BiscutLabs/RISCay-MCU/README.md

# RISCay-MCU

RISCay-MCU is an asynchronous RV32E microcontroller built in Chisel with
[chisel-async](https://github.com/BiscutLabs/chisel-async), targeting the GF180MCU
process. It combines a small RISC-V CPU, on-chip SRAM, firmware loading, GPIO,
measurement interfaces and event-driven sleep.

The active rebuild is a [multi-bank desynchronized MCU](docs/desync-contract.md),
generated from the [clocked MCU](designs/clocked/README.md). Its register banks
will exchange data through four-phase handshakes, without a shared fast clock.
The bank transformation and physical controllers are under development.
The earlier **four-phase bundled-data (BD)** and **native two-phase Click** designs
are frozen behavioral references. All variants use the same ISA and software interfaces.

## Features

| Component | Capabilities |
| --- | --- |
| CPU | RV32E, sixteen 32-bit registers, one instruction in flight; no cache, compressed instructions or hardware multiply/divide |
| Memory | 2 KiB executable SRAM and 1 KiB working SRAM in the reference build; configurable capacities |
| Boot | External SPI NOR flash, A/B firmware slots and a golden recovery image, with I²C host-loader fallback |
| Programming | CRC and image-compatibility checks, programming lock, optional flash persistence |
| I/O | GPIO inputs, outputs and events; external SPI ADC interface; measurement value, validity and age |
| Timing | Independent low-frequency timebase and watchdog, deadlines, wake events and retained sleep |

Application behavior lives in firmware. Board profiles describe pin assignments,
measurement metadata and capacities.

The BD and Click CPU and major SoC datapaths use native request/acknowledge handshakes.
The low-frequency timebase, watchdog, reset qualification, service coordination,
wire sampling and production SRAM access still use clocks. See the
[architecture and remaining clocked boundaries](docs/async-residual-state.md).

## Build and test

Use Python 3.12, JDK 21, firtool 1.160.0 and Icarus Verilog 13. Firmware tests also
use the pinned RISC-V GCC toolchain. Follow the [setup guide](docs/build-and-test.md)
to install the tools and configure their paths, then run:

```sh
python tools/ci.py --output build/ci-local
```

Choose a fresh output directory for each run. This runs the Python tests and fast
RTL simulation suites; CI uses the same command on pushes to `main` and pull
requests. The build fetches chisel-async at a pinned Git revision automatically.

To export the clocked source for the rebuild:

```sh
python tools/sbt.py --bootstrap "clocked/runMain riscay.clocked.EmitClockedSoc build/export/clocked"
```

The [build guide](docs/build-and-test.md) also covers reference exports, extended
simulation suites and the physical toolchain. Run only one sbt process at a time.

## Firmware and integration

Firmware targets `rv32e` with the `ilp32e` ABI. The repository includes startup
code, linker scripts, a generic bootloader and example test workloads in
[`firmware/`](firmware/README.md).

At power-on, the bootloader validates an image in external SPI NOR flash and
loads it into executable SRAM. An optional A/B layout preserves the previous
usable image during updates and falls back to an external golden image. If no
valid image is available, it waits for an
I²C upload. GPIOs start as inputs; board pull resistors determine their electrical
state. Watchdog recovery preserves the image and programming lock, with GPIO
retention available as a generic build option.

- [Boot image format and flash programming](docs/generic-boot-contract.md)
- [A/B slots, golden recovery and factory provisioning](docs/boot-slots.md)
- [Memory map and storage](docs/memory-architecture.md)
- [MMIO and I²C host protocol](docs/soc-contract.md)
- [Sleep, wake events and reset behavior](docs/sleep-and-clock.md)

## Repository layout

| Directory | Contents |
| --- | --- |
| [`physical/desync/`](physical/desync/) | Generated desync bank-map inputs |
| [`designs/clocked/`](designs/clocked/README.md) | Independent synchronous reference |
| [`designs/four-phase-bd/`](designs/four-phase-bd/README.md) | BD CPU and SoC implementation |
| [`designs/two-phase-click/`](designs/two-phase-click/README.md) | Native Click CPU and SoC implementation |
| [`shared/`](shared/README.md), [`soc/`](soc/README.md) | ISA, interface definitions, parameters and fixed SRAM models |
| [`profiles/`](profiles/README.md) | Board pin and measurement metadata |
| [`firmware/`](firmware/README.md) | Boot ROM, runtime and firmware fixtures |
| [`verification/`](verification/) | RTL simulation and integration tests |
| [`physical/`](physical/), [`analog/`](analog/) | GF180 implementation flow and analog candidates |
| [`tools/`](tools/) | Build, verification and implementation scripts |

## Physical implementation

BD routed digital layout on a 2.35 × 2.53 mm die


This earlier BD routing study uses a **2.35 × 2.53 mm** outline. Cell
footprints total **3.493 mm²**, including the three SRAM macros across the top.
Pads and analog blocks are not included. The selected run (`d6e5d91`) includes
the native receiver-isolation fixes and predates the expanded A/B boot ROM
and subsequent native-bank changes.

**This is a development design, not ready for fabrication.** Detailed routing
has zero router violations; electrical, timing and signal-integrity qualification
remain open. See the [layout and congestion results](docs/gf180-routability.md),
[module placement study](docs/hierarchical-floorplan.md), [area ledger](docs/area-ledger.md)
and [development roadmap](docs/architecture-followups.md) for measurements and
remaining work.

## License

[Apache License 2.0](LICENSE). Third-party IP retains its own licenses and
attribution.
