BiscutLabs/RISCay-MCU/shared/README.md

# Shared MCU contracts and verification

This directory is reserved for material used unchanged by both implementations:

- RISC-V execution environment, memory map and generic host/peripheral definitions.
- Pure instruction decoding and datapath functions where sharing preserves
  each design's independent protocol/storage implementation.
- Common startup/linker support; board policy and firmware bindings live in `profiles/`.
- Identical workload inputs and independent ISA/supervisor reference models.
- Common test vectors, result schemas and comparison tooling.

Protocol controllers, state storage and protocol-specific timing/reset logic
belong under their respective `designs/` directories. Expected test results
must not come from the same shared datapath used to implement the CPU.

Shared combinational RV32E logic is implemented in
[Architecture.scala](src/main/scala/riscay/Architecture.scala). Independent tests
are in `verification/`; the interpreter does not call production datapath code.
[ArchitecturalRegisters.scala](src/main/scala/riscay/ArchitecturalRegisters.scala)
holds one event-written register bank; each design supplies its own native
arrival pulse and a matched request guard that completes writeback before token
forwarding. Public asymmetric C-elements select each register; read muxes are
inside the execute transform budget. The control token no longer copies the
register file or trace. See the [execution timing contract](../docs/execution-contract.md).

[HostSchema.scala](src/main/scala/riscay/HostSchema.scala) defines and validates
the generic logical host catalog, measurement descriptors and build parameters.
It supplies no I2C transport, peripheral RTL or physical memory. Board-specific
registers and pin roles belong in [profiles/](../profiles/README.md), never in the
shared CPU or common device/loader services.
Shared interface schemas and fixed macros live in [soc/](../soc/README.md);
clocked peripheral implementations live separately under each design. SoC/board
tests live in `verification/`. Compiler-built firmware and memory budgets are in
[firmware/](../firmware/README.md). Both designs must pass the same functional tests; each also
needs its own protocol/timing negative controls. Compare committed instruction
and I/O effects rather than internal cycles. Optional features are on hold.
