BiscutLabs/RISCay-MCU/designs/four-phase-bd/README.md

# Four-phase bundled-data MCU

Selected tape-out implementation, pending physical qualification, using Chisel and chisel-async four-phase
bundled-data components. The core and complete digital SoC are implemented.
[FourPhaseSoc.scala](src/main/scala/riscay/bd/FourPhaseSoc.scala) connects the core
through `FourPhaseFabric` to its own clocked `FourPhaseServices` endpoint via
explicit four-phase/clocked bridges. `FourPhaseControl` uses a seeded state token,
join, transform and fork to own loader accounting/lock, MMIO validation and
selector/producer staging without a periodic clock. Clocked ingress and snapshot
crossings are explicit; peripheral effects and reset/status projection remain in
Services. This directory owns its Platform,
peripheral, scaling, sleep and SRAM controller implementations.
Its native Telemetry, SRAM and I2C loops retain separate POR-owned
state. [FourPhaseSpiAdc.scala](src/main/scala/riscay/bd/FourPhaseSpiAdc.scala)
owns native conversion/priming, frame assembly, scaling and retirement; the
clocked boundary plays its immutable recipe and buffers the complete frame.
`FourPhaseHousekeeping` owns native time/deadline/lease/wake-mask policy, kick
authorization and low-power cadence. Independent LF/watchdog, heartbeat delivery
and legacy SPI idle-delay timing remain clocked.
Follow the [migration checklist](../../docs/async-soc-migration.md).
See the [SoC contract](../../docs/soc-contract.md) for behavior and qualification limits.

The core is [FourPhaseCore.scala](src/main/scala/riscay/bd/FourPhaseCore.scala).
Build instructions are in [build and test](../../docs/build-and-test.md).
The SoC emitter enables retained sleep and also emits `chip/FourPhaseSocChip.sv`
with internal LF and stoppable service oscillator boundaries. See [sleep and clocks](../../docs/sleep-and-clock.md)
for simulation views and outstanding analog qualification.

Own the four-phase CPU sequencing, long-hold storage, reset/token initialization,
top-level integration, emission and protocol-specific tests in this directory.
Use explicit request/acknowledge return-to-zero contracts and preserve their
matched-delay and storage timing obligations.

For each profile, match the native Click implementation's ISA, firmware image, datapath width,
memory capacities, MMIO map, board signals and supervisor policy. Shared logic
must not hide a protocol-specific implementation behind a mode flag.

Use the [reusable interface](../../docs/reusable-interface.md),
[common feature plan](../../docs/features-and-ip.md),
[board I/O contract](../../docs/groundlark-io.md), and
[shared ownership rules](../../shared/README.md). Optional features are on hold.
