BiscutLabs/RISCay-MCU/docs/architecture-followups.md

# Architecture-first follow-ups

The [open migration checklist](async-soc-migration.md) owns sequencing and status.
This document expands its boundary decisions and records the implemented slices.
The remaining proposals are open work. Completed build/characterization work
is in the [migration log](history/migration-log.md#source-build-and-mismatch-screen-follow-up).

RISCay is a generic MCU. Neither RTL nor ROM contains application policy. BD is
the tape-out target. Architecture conversions keep BD and Click functionally equal
unless the user explicitly requests otherwise. Each variant gets its own native
implementation and functional regressions. Click physical timing and sizing work
remains frozen; area and sink accounting still accompany functional changes.
Document temporary internal divergence and any approved ABI transition.

The user has scoped the current native-area redesign **BD first**. BD's
[SRAM word loop](native-sram-word-loop.md) reuses one byte crossing while Click
retains four lanes. BD also replaces Telemetry/Housekeeping reservation round
trips with a [payload-free receiving-edge slot](publication-slot.md); Click
keeps its native reservation owners. BD Control now uses a
[closed architectural/effects bank](native-control-bank.md) and commits CRC on
Stored; Click retains its state FIFO, Join and speculative CRC path. BD
[Telemetry](native-telemetry-effects.md) now publishes a three-bit effects reply
from its existing closed banks. BD [Housekeeping](native-housekeeping-effects.md)
also retains its architectural bank and publishes only 41 effect bits. Click
retains the corresponding full-state replies. The follow-on
[three adaptive area loops](area-optimization-loops.md) are also BD-only: the
first replaces the ADC scaler with an exact single-stage constant transform;
the second factors elapsed arithmetic with its own remeasured request guard;
the third drops consumed CPU Join writeback and unobserved physical retirement
storage. Default BD debug/verification exports still retain retirement, while
PhysicalSocExport explicitly disables it. Click retains its original pipelines
and transport. Both keep the same ISA and integer/scaling ABI. Those loops reached
1.455121 mm² flat BD logic. The follow-on
[memory-guard batch](reviews/bd-memory-guards.md) removes redundant BD Source/Return
waits, retains full decision/history return, and sizes three surviving chains
from their own loaded paths. It maps to 1.345309 mm² flat; the ledger records the
remaining gap. Click retains its existing memory transport and guard recipes.
The [resetless-payload/compact-transport batch](resetless-payload-plan.md) uses
plain latches only for BD's four transient I²C frame banks and narrows the BD
accepted-MMIO descriptor and Control sender address. Click retains resettable
frame payloads and its full command transport; neither ABI nor reset ownership
changes. Architectural banks and all native control state remain resettable.
The external ABI and reset/retention behavior remain equal;
Click remains an unchanged functional regression reference during this pass.

The user-approved [clocked comparison MCU](clocked-design.md) is a third,
independent implementation of the same ABI, including a synchronous CPU. Its
ordinary clocked state is intentional; it neither reverses the native migration
nor changes BD's tape-out selection.

## Work order

The [external boot batch](boot-slots.md) is verified: A/B slots, external golden,
factory image/read-back and full-capacity boot/fallback measurements precede the
remaining area work. No application policy moves into silicon.

1. Decide B's replacement host ABI before resuming 11a2b credit/admission work,
   then continue A/B with producers and consumers moved together.
   Before replacing a memory decision bridge, re-prove publication-ACK inhibition
   before decision-payload reuse. The current +29.206 ns residual credits one
   50 ns period from that retained work-clock bridge at the 20 MHz maximum.
   Removing it, bypassing its retained payload/return states or raising the clock
   limit invalidates that credit. Supply native completion or newly measured
   source retention; do not carry the old margin into the new architecture.
2. Regenerate the BD request-guard inventory and size surviving guards at each
   corner. Historical counts are not the new architecture's inventory.
3. Run item 16 once on the integrated architecture and supported configurations,
   then regenerate 17a3 and close the BD tape-out gate, including full R2b reset
   distribution and targeted routed hold repair.

Local measurements and affected verification accompany each implementation batch.
The [native-area action plan](native-area-action-plan.md) proposes concrete,
ABI-preserving ownership reductions before surviving-guard tuning: one SRAM
word loop per memory, removal of Telemetry/Housekeeping reservation round trips,
and compact Control and native bank-result storage. It preserves the existing
receiving-edge arbitration and memory return/eligibility lifetimes. Its area
budgets are planning gates; [batches 1–4](area-ledger.md) now measure
1.506013 mm² flat BD logic, with 3,449 fewer native storage bits and 247 fewer
flat periodic sinks. This completes the scoped BD-only rewrite, including final
full-capacity primary/golden boot checks. The remaining physical gates are still open. The host ABI decision still precedes frame/credit restructuring.
Record mapped/repaired logic, clock sinks and wake activity/duration in the
[area ledger](area-ledger.md), against the immediate parent and original baseline.
Full extracted-RC qualification remains item 17. Physical prerequisites may be
resolved earlier when they determine a design choice; optional 15a–c research is
not on the tape-out critical path.

The immediate physical prerequisites are compact C-element keeper/output
placement, repairable native parent drivers and a matched 1.94–2.53 mm width
sweep at 50–55% placement density, retaining only zero-router-DRC candidates.
Pre-fix routed timing is [void](gf180-routability.md#withdrawn-physical-results).
The retained time coordinate/timestamps are narrowed from 64
to **43 bits of conservative upper milliseconds**, preserving saturating 32-bit
age. A 41-bit coordinate lasts 69.7 coordinate-years, but the GF180 5–12 Hz
envelope can advance it 2.4 times faster than wall time: only 29.0 wall years.
43 bits supports at least 116 wall years under that envelope. Saturate the
coordinate and force terminal age to `0xffffffff`, even for newly sampled data,
so a stopped coordinate cannot make data permanently fresh. Nominal 32-bit MMIO
time and deadline arithmetic remain unchanged. The verified 43-bit batch removes
42 periodic sinks per variant, with Services work sinks 1,228 → 1,207. Production
ADC/time local timing passes; optional software-sample configurations still need
their own physical map. Matched area and unchanged native-model wake activity
are recorded in the [ledger](area-ledger.md#bounded-time-coordinate).

The [Housekeeping view](native-housekeeping-view.md) removes 292 Services work
sinks in each variant (1,207 → 915). The obsolete elapsed-age command lanes and
architectural state mirror are gone; time/CPU/reset receiving-edge arbitration
remains. The existing 32-bit consumed-time acknowledgement stays at that edge
because it drives asynchronous oscillator-wake logic. BD uses one closed native
bank and a one-bit feedback credit. Click retains its native state buffer and
adds two completion synchronizer flops at the reader boundary. Total periodic
sinks fall by 292 BD / 290 Click. Qualification increases work-clock edges in
some wakes; the ledger records the cost. The 269-sink host snapshot bank belongs
with B's register-pointer redesign, not this slice.

## A. Always-on/application ownership split

The implementation currently has a service clock, a gated work clock and native
POR/application owners, but they are interleaved in Platform/Services. Moving
code into two wrappers alone would not reduce crossings or clock sinks.

| Retained always-on ownership | Application ownership |
| --- | --- |
| LF time/watchdog, reset qualification, crash count, SDA wake | CPU, register file, fetch/execute and CPU transaction presentation |
| Image/lock metadata, host-loader admission, accepted programming work | Uncommitted CPU requests and CPU response presentation |
| SRAM contents and completion of already committed macro work | Application execution eligibility |
| GPIO retention option, POR-retained sample/time state, host telemetry transport | Application words and pending event/deadline/lease state, cleared by the existing reset command |
| Reset/close/rebase coordinator and demand needed to drain owners | Request for sleep/lease, subject to independent watchdog limits |

"Always-on" means retained and able to request progress; it does not mean a
continuously running fast clock. Sampling and the existing service/SRAM boundaries
remain explicit physical obligations. Native storage remains clock-free.
Physical residence does not change reset semantics: an AON owner may host
application-lifetime fields. Pending event flags, deadlines, leases and application
words still clear on application cancellation. Only ordinary GPIO output/OE
retention is configurable; SPI recovery always releases its outputs.

Use the existing close/rebase protocol at the boundary: inhibit admission, close
each receiver on its actual clock, finish or cancel according to the established
commit point, reset native application state, rebase and reopen. No raw reset may
qualify retained synchronous loads. Never cancel a committed loader/SRAM effect
because the CPU resets. Wake demand must include return/rearm, not just valid.

First implementation gate: assign every retained state owner and every periodic
clock sink to a side; move producer and consumer together. Reuse existing channel
schemas, with one ownership crossing per subsystem; move its producer and consumer
as a unit rather than adding a crossing per message type. Do not add a
payload mirror merely to cross the new module hierarchy. Verify reset during host
upload, ADC completion, CPU RAM traffic and sleep, including repeated watchdogs.
Measure mapped/repaired area, periodic sinks and wake activity/duration for each batch.
This absorbs C1e2, the remaining 10b ownership/debt, 11b dispatch, 13a state
projections and 14 temporary round trips. Remove obsolete grant/drain copies,
receipts and gate demand together with their migrated clients.

This is a proposed logical boundary, not implemented power gating. Separate rails
would additionally require isolation, retention cells, supply sequencing and an
external-memory/pad strategy before RTL work starts.

### Implemented slice: retained Telemetry view and clocked event arbitration

Both variants remove Services' application/GPIO payload mirrors. Telemetry keeps
one closed native architectural bank and the existing CPU MMIO crossing. The
[single-writer sample split](single-writer-telemetry.md) assigns physical samples
to the ADC loop and software publications to the CPU, using retained timestamps
in place of time-driven Telemetry updates. BD captures on the qualified
receipt ACK and waits for full return. Click uses its own standard Click bank,
launched by both receipt ACK phases, with its native completion phase synchronized
for clocked readers. Click has no four-phase adapter. See the
[register-view contract](native-app-registers.md).

Pending events, arrival masking and WAIT parking deliberately remain together at
one clocked arbitration point in Services. Independent arrivals must be ordered
against the first offered clear request; saturated source counters cannot preserve
that cutoff. No event travels through Telemetry. The six-bit bank is the sole
pending state, shared by MMIO, WAIT/sleep and the host snapshot. This is a generic
arbitration boundary, not an application policy. The [event contract](native-events.md)
records the sources, exact cutoff/reset rules and shared executable oracle.

The remaining Control scheduler orders host, CPU, programming-completion and reset
commands on the receiving edge. Housekeeping similarly orders time, CPU timer/
cadence actions and recovery. These are intentional clocked arbitration points;
this batch does not require a GF180 MUTEX. Any native replacement must qualify
arbitration before moving the competing sources.

## B. Register-pointer host interface

The target is a **replacement for the framed loader**, not an additional permanent
protocol. The existing framed ABI remains the implemented interface until the
new ABI and host transition are specified and verified. Decide protocol version,
register allocation, pointer units/increment/wrap, command commit, status/error
behavior and migration of existing host tools before changing RTL. Keep 11a2b and
its occupancy/descriptor/admission substeps paused until that decision.

Use repeated START for coherent register reads. Define the snapshot's atomic point
and retain bytes through the read. Stage multibyte command fields and commit only
a complete accepted write. Specify partial writes, STOP, timeout, pointer bounds,
busy/overflow and application/POR reset behavior; none may partially program RAM,
release the lock or start an unvalidated image. Preserve accepted persistent work
and the association of each command with its admission-time reset/busy context.

Reuse the native Control loader owner, full-width image validation, CRC and SRAM
serialization. Do not create a second image store or programming owner. Keep
explicit flash persistence subject to the generic boot contract and source
payloads stable through actual consumer acceptance and native return.

This replaces the old 11a2/11a2b frame-admission and 13c snapshot plan. Decide
whether frame banks are needed at all. Only surviving banks need the R5 epoch/
stale-history redesign and the R6 private frame-route AND replacement with public
primitives. Remove obsolete banks, copies and receipts with the protocol. Test
wire-level repeated START, partial/oversized writes, pointer limits, lock, busy,
reset, coherent snapshots and the chosen host transition in both implementations.
Implement the replacement natively in both variants; Click physical optimization
remains frozen.

## External boot resilience and provisioning

The verified A/B implementation's [contract](boot-slots.md)
specifies the flash layout, golden image placement/protection, versioned
selection/commit metadata and bounded boot attempt/fallback rules. The legacy
single-slot path and I²C fallback remain. Keep generic boot decisions separate from application
behavior; a golden application belongs in external storage, never mask ROM.

The factory tool assembles a bootable image set and verifies full-device read-back,
compatibility and CRC before acceptance. Field updates preserve the newest usable
field image and leave golden/directory untouched. Both variants pass blank/corrupt
slots, interrupted erase/program/metadata commits, POR, watchdog and lock scenarios,
including golden recovery. The programming lock is not protection against
arbitrary firmware GPIO writes to flash; any physical write protection must be
specified separately.

The boot contract records reset-to-entry and worst-case fallback time and work
edges at the full 2 KiB reference capacity. These digital-model measurements
include flash transfer, CRC and SRAM loading; shared ADC-bus drainage has its
separate integration test. Routed boot timing and board provisioning remain
physical integration obligations.

## Retained services and arbitration (11c, 12, 13b)

Use a native MUTEX only for independent asynchronous requesters meeting in the
native domain; qualify metastability containment and ownership. Arbitration on
a real receiving clock is acceptable after the requests safely cross into it.
Neither approach may compromise fairness, accepted work or reset containment.

Acquisition has one publication path into the ADC's retained sample bank. CPU and
host read its coherent view; no independent Supervisor history or fan-out exists.
Keep elapsed ordering/reduction (12a) and GPIO/event history (12c) only for retained
application services, with bounded capacity, sample validity/age, set-wins events
and correct cancellation lifetimes. Retained residence does not imply POR-only
lifetime for every field. Output publication (13b) concerns generic GPIO and cadence,
POR input defaults, optional watchdog GPIO retention and mandatory SPI recovery
release. There is no board-owned power output or application-policy feedback path.

## Residual audit configuration matrix

Run item 16 once after A and B are integrated. Audit emitted owners, native/event/
periodic storage, reset domains, chip-wrapper state and actual clock sinks. Record
conditional owners and exclude unsupported combinations explicitly; do not revive
removed supervisor-policy configurations.

| Configuration axis | Required coverage |
| --- | --- |
| Production reference | Generic 2 KiB program / 1 KiB working SRAM, SPI boot, scheduled ADC and source-stopping LF sleep |
| Boot | Valid external image, I²C fallback, supported I²C-only builds, A/B/golden paths and interrupted updates |
| Acquisition | ADC disabled/zero measurement channels, scheduled ADC, and autonomous ADC in supported legacy builds |
| Time and sleep | LF with service stopping on/off, plus legacy service-derived time without retained-sleep support |
| Capacity and schema | Supported minimum/non-power-of-two/reference capacities; generic GPIO/channel counts and sparse application words |
| Reset | GPIO retention on/off, SPI release, POR, repeated watchdogs and reset during committed work |
| Implementation | Full BD and Click ownership/sink inventories and functional regressions; BD physical qualification only |

SPI boot requires at least seven logical GPIOs and 256 bytes of working RAM.
SPI boot plus ADC requires explicitly scheduled acquisition; the autonomous ADC
combination is currently rejected. Use the actual parameter validators when
constructing the matrix. Reconcile the final inventory with item 17 clock/reset
constraints and retain a written reason for each clocked boundary.

## External application dependency

Groundlark firmware, its policy tests and board integration are maintained outside
this MCU workstream. Application compatibility is an integration dependency, not
permission to restore power policy, profile-owned GPIO masks or a supervisor in
RTL/ROM. Generic MCU verification uses generic firmware and peripheral stimuli.

## Routed hold repair

The former +0.729 ns feedback result has zero wire RC and is not a routed margin.
Reserve 0.05 mm² additional BD standard-cell area, separately from existing
electrical/CTS repair and whitespace. No reserve cells are inserted in advance.

After routing and electrical repair, enumerate every actual feedback/source-release
path with min/max extracted RC at all corners. Measure earliest next-data arrival
against the latest capture leaf plus its Liberty hold aperture, including the
source's real ACK reaction and return/rearm. Preserve phase-specific contexts and
fail on unresolved paths or out-of-table slew; do not borrow Control's margin for
other owners.

Only paths with failing composed hold get candidate delay cells, outside protected
primitives and on the affected data branch. Recheck setup at the earliest capture
leaf, ACK ordering, pulse width, return/rearm, graph equivalence and all sibling
loads after every repair. If a data buffer cannot repair hold without breaking
setup, revise the relevant capture/ACK ordering and remeasure it; do not blanket
buffer all payload bits. Record cell count/area, limiting pins and before/after
slacks in the existing run receipt and area ledger. The reserve is a planning
allowance, not permission to relax the hold requirement.
