BiscutLabs/RISCay-MCU/docs/memory-architecture.md

# On-chip memory architecture

Both native variants execute from on-chip SRAM. Generic mask ROM loads a CRC-
and compatibility-validated image from external SPI boot flash, or waits for the
I2C loader when storage is blank/invalid. No application or profile policy is
fixed in ROM or RTL. See [generic boot](generic-boot-contract.md) for current
implementation and verification status.

## Groundlark sizing budget

| Storage | Selected baseline capacity | Implementation |
| --- | --- | --- |
| Generic bootstrap | Generated RV32E boot ROM | External SPI read, existing CRC/compatibility validation and I2C fallback; no power policy |
| Application firmware, constants and startup image | 2 KiB | Two on-chip 1 KiB SRAM macros loaded from external flash or I2C; volatile |
| Application data and stack | 1 KiB | One on-chip 1 KiB SRAM macro |
| Architectural registers and control | x1-x15 contain 480 bits; additional PC/control and pipeline storage | Protocol-appropriate standard-cell storage; x0 is constant |

Use **2 KiB program SRAM and 1 KiB working SRAM** as the baseline. The
[compiled sizing fixtures](../firmware/README.md) provide repeatable code/data/stack
measurements; actual future application changes must pass these budget checks.
The SPI ROM is generated by `tools/build_boot_rom.py`; its report records bytes,
instruction audit and stack bound. Minimal host-only fixtures may still select
the three-instruction I2C-wait ROM. Neither contains application behavior.
External flash retains the application across total MCU power loss; SRAM does not.

The selected implementation uses **three 1024-by-8 GF180 SRAM macros**, totaling
3 KiB (24,576 data bits), following the explicit SRAM scope change. Their combined
LEF footprint is **0.46624 mm2**, before controllers, routing and placement margins.
The CPU architectural register file, loader metadata and peripheral registers
remain standard-cell storage. [SRAM integration](sram-integration.md) specifies
pinned views, serialization, reset behavior and physical qualification limits.
Keep memory separate from the CPU's circulating state token. Both protocol
variants must use the same backend, capacity and firmware for each comparison;
count their wrappers in the results.

The 1 KiB working RAM budget includes static application data, a 16-byte guard,
and a 128-byte reserved downward-growing stack. It has no heap or interrupt stack.
CPU architectural/handshake state, loader state, measurement registers and
profile-declared software-owned MMIO application words are separate storage.
All profile application words are software-owned. These
program/data capacities are not a count of every flip-flop in the MCU.

Compiler sizing with pinned GCC 13.2.0, `rv32e/ilp32e`, `-Os`:

| Workload | Loaded program image | Static working RAM | Static maximum stack | Guard | RAM including measured bound |
| --- | ---: | ---: | ---: | ---: | ---: |
| Finite event loop | 728 B | 16 B | 20 B | 16 B | 52 B |
| Runtime stress fixture | 1212 B | 48 B | 88 B | 16 B | 152 B |

The larger image leaves **836 bytes (40.8%)** of program headroom. Reserving 128
stack bytes, rather than just its 88-byte bound, uses 192 RAM bytes including
static data and guard, leaving **832 bytes** uncommitted. A 1 KiB program budget
cannot hold that workload; 128 bytes of working RAM cannot hold its static data,
stack bound and guard. The linker negative controls deliberately reject both.
The 1 KiB data capacity follows the selected fixed macro size; it is not a new
firmware requirement. These finite fixtures exercise useful runtime paths but are not the final Groundlark application.

The measured stress call chain uses `main` (12), `batch` (32), `transform` (44)
and `divide` (0), totaling 88 stack bytes. Startup uses no stack. The report includes load
copies of `.data` in program size and both `.data` and `.bss` in static RAM size;
it does not confuse ELF file size or debug metadata with on-chip storage.

`FirmwareSpec` uploads both binaries over real I2C and executes them on both native
SoCs at these full capacities. Independent retirement-SP and RAM-watermark checks
must match the compiler's 20-byte event-loop and 88-byte stress bounds. It also
checks initialization, arithmetic, guard, sleep retention and programming lock.
The images above include explicit event acknowledgement and keyed watchdog
servicing; earlier 704/1204-byte images predate that fix. See the
[verification record](build-and-test.md).

## Generic cold-start and recovery

1. POR disables GPIO outputs and invalidates image/lock metadata. Board pull
   resistors determine safe levels.
2. ROM claims the shared SPI bus, waits for complete ADC drainage, then reads the
   generic external image. It feeds the header/body to the native loader owner.
3. The loader validates full-width fields before narrowing, serializes SRAM
   writes, and accepts the image only after complete CRC verification.
4. ROM releases SPI and starts the validated image. Invalid/blank flash falls
   back to the existing I2C host loader. CRC provides integrity, not authenticity.
5. Watchdog recovery retains validated SRAM image and lock, returns to ROM, and
   restarts a valid retained image without rewriting locked storage. Interrupted
   CPU-origin loading retires accepted writes before aborting the session.

No fixed controller makes power decisions while software is missing or stalled.
A Pi reset does not reset MCU memory or lock. Full MCU POR clears validity and
lock even if some SRAM bits happen to survive. Optional flash write-through must
publish a valid commit record last and distinguish RAM validity from durability.

## Previous flip-flop baseline

The earlier 2 KiB program plus 256-byte working flip-flop implementation is
retained only as historical evidence in [GF180 estimates](gf180-estimates.md).
Those whole-chip area, leakage and energy numbers do not describe this SRAM
revision. New estimates must include all three physical macros, controller
logic, their clock loads and memory-access activity.

## Async integration and initialization

The selected SRAM has a synchronous single-port interface. Its 8-bit width also
requires sequencing to serve the core's 32-bit read response. Each design owns its service controller, which, but must satisfy macro pulse-width, setup/hold
and access timing, then retain the response until consumed. [SRAM datasheet][sram]

Do not wire an arbitrary request signal directly to a macro clock. Qualified
local timing is necessary; a free-running global CPU clock is not required.
Include byte sequencing and response storage in the comparison. A Chisel
`SyncReadMem` declaration alone does not supply the technology macro or its
physical integration. [Chisel memory guide][chisel-memory]

Use the existing one-outstanding-request contract and byte masks. Validate a
transaction before any write commits; return exactly one completion. Define
coordinated reset behavior, including reset during a multi-byte operation.

RAM contents are not guaranteed after power-on. Bootstrap initializes its own
working state; application startup initializes data from the validated image
and clears the required zero-initialized region before use. Do not make
an instantaneous hardware clear of every RAM bit part of the architectural
contract; that would unnecessarily constrain an SRAM replacement.

## Verification required at integration

Test both native SoCs against actual ROM SPI transactions: valid, blank, corrupt,
incompatible and truncated images; busy/stuck storage; competing I2C/ROM loads;
lock; watchdog; and POR at each commit boundary. Keep first/last SRAM address,
byte-mask, aliasing, ROM-write rejection, backpressure and exactly-once checks.
Firmware startup still initializes its data and stack. All GPIOs must be inputs
at POR regardless of profile names; test both generic watchdog retention options.
Application power-policy verification belongs to its firmware project.

[sram]: https://gf180mcu-pdk.readthedocs.io/en/latest/IPs/SRAM/gf180mcu_fd_ip_sram/cells/gf180mcu_fd_ip_sram__sram256x8m8wm1/gf180mcu_fd_ip_sram__sram256x8m8wm1.html
[dff]: https://gf180mcu-pdk.readthedocs.io/en/latest/digital/standard_cells/gf180mcu_fd_sc_mcu7t5v0/cells/dffq/gf180mcu_fd_sc_mcu7t5v0__dffq_1.html
[chisel-memory]: https://www.chisel-lang.org/docs/explanations/memories
