BiscutLabs/RISCay-MCU/docs/async-soc-migration.md

# Asynchronous SoC migration: open work

RISCay is a **generic MCU**: ROM contains the bootloader; application policy lives
in external firmware. **BD is the tape-out target. Architecture conversions cover
both native implementations** unless explicitly scoped otherwise. Click physical
timing and sizing campaigns remain frozen.
Completed work and old contracts are in the [migration log](history/migration-log.md).
The [architecture plan](architecture-followups.md) supplies boundary details.
External [A/B boot, golden recovery and factory provisioning](boot-slots.md) are
verified, including full-capacity boot measurements in both variants.

## Architecture and implementation

- [ ] **A. Always-on/application island split.** Absorbs C1e2, the 10b remainder,
  11b, 13a and 14. Assign state, reset, cancellation and wake ownership; move each
  subsystem's producer and consumer together, with one crossing per subsystem.
  Remove duplicate queues, mirrors and grant/drain round trips while preserving
  committed SRAM/loader effects, lock, retention and close/rebase recovery.
  Start with a logical split on one supply. Measure mapped/repaired area, periodic
  clock sinks and wake activity/duration against the parent for each batch.
  The [Telemetry register view](native-app-registers.md) removes application/GPIO
  mirrors in both variants. [Event pending/clear/WAIT](native-events.md) stays at
  its intentional clocked arbitration boundary, without Telemetry transport.
  The [single-writer sample split](single-writer-telemetry.md) removes time/sample
  Telemetry traffic and clocked sample projections in both variants.
  The [Housekeeping view](native-housekeeping-view.md) removes its clocked state
  mirror and obsolete elapsed lanes, retaining command arbitration and the
  consumed-time wake acknowledgement. The scoped [BD area rewrite](native-area-action-plan.md)
  reuses SRAM byte crossings, removes reservation detours and compacts Control,
  Telemetry and Housekeeping transport; Click remains the unchanged reference.
- [ ] **B. Register-pointer host interface.** Replace the framed loader; do not
  build a permanent second transport. Decide the versioned wire ABI and host
  transition before RTL. Absorbs 11a2/11a2b, 13c, R5 epoch work and the R6 public
  frame-route AND replacement if frame banks survive. **11a2b is paused until the
  ABI decision.** Define coherent reads, partial-write commit, busy/reset/overflow
  behavior, pointer bounds and lock enforcement; reuse the existing loader/CRC owner.
- [ ] **11c. Arbitration.** Use a physically qualified native MUTEX only where
  independent asynchronous requesters meet. Clocked arbitration at a real crossing
  is acceptable; verify fairness, simultaneous arrivals and reset containment.
- [ ] **12. Observation transport.** Use one acquisition consumer. Retain 12a elapsed
  ordering/reduction and 12c GPIO/event history only where retained application services
  need them; preserve sample age/validity, set-wins events and bounded buffering.
- [ ] **13b. Output publication.** Remove redundant GPIO/cadence copies where timing
  permits. Keep generic POR inputs, optional watchdog GPIO retention and SPI release;
  there is no board-owned output or supervisor feedback path.
- [ ] **BD request guards.** After A/B, enumerate surviving canonical request guards
  and size them in one same-corner campaign, with mismatch derates, complete launch/
  capture/ACK/hold composition, pulse floors and worst-corner throughput checks.
- [ ] **16. One residual-state audit after the split and ABI integration.** Cover
  generic SPI boot and I²C fallback, ADC on/off, retained sleep on/off, supported
  time sources/capacities and both GPIO-retention settings. Reconcile native/event/
  periodic storage, generated wrappers and clock sinks in both variants without
  restarting Click physical optimization. [Configuration details](architecture-followups.md#residual-audit-configuration-matrix).

## Remains clocked and why (15)

| Boundary | Required obligation |
| --- | --- |
| Production SRAM macros and pin controllers | Qualified CLK pulse, address/data setup/hold and read capture |
| I²C/GPIO pin sampling | Metastability containment, filtering and bounded edge capture |
| Event pending, clear cutoff and WAIT | One work-clock edge orders all six producers against request arrival; preserves the cutoff ABI without an unqualified native MUTEX |
| Command scheduling | Receiving-edge arbitration for Control's host/CPU/completion/reset commands, Housekeeping's time/timer/cadence/recovery, and Telemetry's CPU/recovery ordering; no unqualified native MUTEX |
| Shared upper-time coordinate | One POR time counter on the work-clock side of the existing LF/elapsed receipt; no new clock or per-sample clocked age bank |
| Consumed-time acknowledgement and bank-reader qualification | Capture LF progress on the real receiving edge before it enters asynchronous wake logic; inhibit readers during native bank capture/return |
| SPI pin player | Bounded SCLK high/low times and MISO sampling aperture |
| LF timebase/watchdog | Time and recovery independent of CPU/service progress |
| Reset qualifier/coordinator and clock gates | Real-time reset holds, receiving-edge close/rebase, safe stop/start |

15a–c (self-timed SRAM, edge-driven pin capture and SPI sequencing) are **optional
research**, not prerequisites for tape-out. A still removes avoidable scheduler
transport and payload copies; the documented receiving-edge arbitration remains. Keep the asynchronous SDA wake event. Qualification of
15d/e (time/watchdog, reset/wake/gating) belongs to 17.

## BD tape-out gate (17 + R2b)

- [ ] **Regenerate 17a3 after A/B** from the final ownership graph and protected leaf
  pins: ROM/fetch, RF/execute, elapsed, I/O, SRAM, feedback/return, arbitration and
  every surviving custom controller. Missing obligations fail qualification.
- [ ] Close electrical and routing violations, then composed setup/hold/ACK,
  capture-tree spread, pulse/rearm, clock skew/duty, SRAM and CDC checks across all
  required corners with extracted min/max RC and justified mismatch derates.
  Complete native-control crosstalk/keeper checks and power-grid analysis with
  actual supply and workload models. [Routing investigation](gf180-routability.md)
  separates NDR assignment, representative noise experiments and static IR screens
  from qualification.
- [ ] **Memory Return keeper retention:** remeasure `released` set-to-feedback
  retention (+2.060 ns locally) and every branch-completion keeper's set-to-feedback
  retention (minimum +1.606 ns), in both BD ProgramReturn and RamReturn, with
  extracted min/max RC and coupling. These are residuals after the engineering
  derate and 2 ns floor, at zero wire RC. A pulse/keeper failure needs feedback
  compaction or a remeasured arm/history tail, not payload hold buffers. Recheck
  offer inhibition, proof withdrawal, pulses, reset and throughput if it lengthens.
- [ ] **Resetless frame-bank hold:** qualify all four BD `frame_store/storage0–3`
  capture-to-source-reuse paths with mismatch and extracted min/max RC. The
  local plain-latch campaign grants no source-release credit; its positive
  zero-wire margin is not a routed hold result. Preserve both publisher-copy and
  receipt/Control full-return joins. [Contract](resetless-payload-plan.md).
- [ ] **SRAM byte receipts:** qualify retained-byte setup/hold and CDC with routed
  clock skew/jitter and min/max RC. Preserve the measured two-period setup wait
  and four-period source-hold floor, or re-prove them if the clocked boundary
  changes. Check 400 kHz earliest-status throughput with slow-corner native
  delays; the digital deadline pass is not physical throughput closure.
- [ ] **R2b:** qualify complete reset assertion/release distribution, recovery/removal,
  hold intervals and startup, including generated reset trees, wake and clock gating.
- [ ] Apply routed hold repair **only to failing composed paths**; reserve **0.05 mm²**
  separately from electrical/CTS area. Recheck setup, ACK and sibling paths after
  repair. Complete DRC/LVS, pad/analog integration and reconcile the item 16 inventory.

Each implementation batch needs affected [verification](build-and-test.md), a fresh
independent review and an [area/activity ledger](area-ledger.md) entry before commit
and push. **Groundlark firmware and board integration are external dependencies**;
this repository implements neither their power policy nor their firmware port.
