BiscutLabs/RISCay-MCU/docs/frame-admission-contract.md

# Native I2C frame delivery and admission

Item 11a1's payload-free original receipt is digitally verified and committed.
Item 11a2a moves accepted payload/epoch retention into separate native BD and
Click banks. Digital qualification and independent review pass. Narrow logical
credits, descriptor ordering and dispatch remain
clocked for 11a2b/11b/14. No physical timing or minimum-state claim follows.

**R3b native route ownership is digitally verified, 2026-10-13.** The implementation below
removes the clocked-slot dependency introduced by R3's copy-qualified admission.
Affected regressions, strict exports, fault controls and matched cost/activity
measurements pass; fresh independent review is recorded under `review-r1/`.
R3's original digital evidence and failed physical copy assumption remain recorded
below; neither qualifies the current change or complete physical implementation.

## 11b1: borrow the retained frame through native Control acceptance

Digitally verified on 2026-10-17. Affected regressions, fault controls and all
four strict exports pass; [matched cost and review](reviews/control-frame-borrow.md)
record the evidence. Physical timing of the new borrowed-data path remains open.
This supersedes the earlier D-time physical head retirement described below.

D remains `ControlCommand.fire`: it frees exactly one logical descriptor and
captures the existing dispatch-time kind/reset/busy/MMIO metadata. A, Q=A-D,
full-queue rejection (including A+D at Q=2), Stored precedence and epoch
classification at D are unchanged. The current descriptor's frame still feeds
loader classification at D and same-edge admission busy history.

The periodic sender now stores only a 108-bit `ControlCommandHeader`. A separate
POR-owned two-bit retiring-bank identity selects the immutable native frame for
the native Control input. A one-bit pending flag owns that bank. Click retains
its Join capture; BD's [architectural-bank rewrite](native-control-bank.md)
captures the borrowed frame's transition directly into its closed banks.
The native `ControlCommand` schema remains 379 bits; neither native payload
storage nor a new acknowledgment synchronizer is added. Non-Host commands mask
the borrowed frame to zero. Never use the live descriptor selector for this
borrowed view: the logical queue can advance on D.

R is retirement of the clocked tag: the sender has returned to `in.ready`
and the work clock is enabled. Sender idle proves synchronized native acceptance;
BD includes full command return-to-zero, and Click retains its phase protocol.
Another Host cannot replace the tag before R; simultaneous R/new D is permitted
with the new D assignment winning. Non-Host dispatch cannot overwrite the tag.
Pending participates in `controlBusy` and work-clock demand until R.

The physical return differs by protocol. Click accepts its head receipt at R,
with the selected head valid. BD accepts its head receipt at the original D,
then joins that receipt's ACK with the selected native Control ACK in a native
C-element for each bank. The join rises after both accept and falls only after
both return; their returns overlap. The existing clocked receipt ACK feeds the
join directly alongside native Control ACK, without an added observation stage.
Consequently a BD bank can finish before R, or remain held after R if its receipt
ACK is stalled. The retained per-bank C-element safely outlives a selector change
and an independently proceeding newer command. Do not substitute a combinational
AND for this retained return state.

Application cancellation resets neither the tag, pending flag, frame bank nor
sender; POR ends their shared lifetime. Loader completion bypasses controlBusy
as before, so a borrowed frame cannot block its own accepted program write.

At most one command borrows a bank at a time. Older BD banks can remain in
return while two logical descriptors and a publisher offer advance. The four-bank ring does not grant any extra logical credit.
The historical D-to-return arithmetic below must not be reused as a bound on
D-to-R: native acceptance can be stalled. Actual bank return, the unchanged
ready-by-third-next-A deadline and reuse at O remain checked independently; the clocked sender is still a temporary boundary.

The new physical path is native bank Q through the retiring-selector mux and
Host mask to actual Control capture (BD state/effect banks; Click Join). D gives the existing sender's full
settling cycle before its native request. This is a digital ordering argument,
not a physical timing waiver. Qualify selector/mask maximum delay, bank-Q setup,
source hold through the latest relevant capture and earliest R/mask removal at all
corners with routed RC. Prior clocked-snapshot or Control-local timing results
do not qualify this new input path. BD also requires its native ACK qualification
chain to settle low before bank/kind can change after synchronized sender idle.
Measure this complete return envelope; the 1–10 ns digital gate sweep does not
qualify its mapped maximum delay.

## Events, retention and acceptance

The sampled-wire front observes a 15-bit native projection: headGray (4),
active, rejected, addressByte, drive, ack and sent (6). Each variant explicitly
selects these fields from its protocol state. A5a removed 325 redundant
observation bits. A5b moves the receive bytes into a native addressed scratch
bank, narrowing protocol state to 76 bits and publication input to 174 bits;
see the [receive-byte contract](native-i2c-byte-store-contract.md). The publisher's
337-bit retained frame and all bank/admission owners remain unchanged.

The complete publication input, 264-bit scratch bank and held frame/snapshot
feedback form the 783/785-bit BD/Click timing source. The separate scratch
transform has a 264-bit data/capture aperture. The existing projection's
register_data/captured remain 360 bits BD and 362 Click.
Click's two phase-feedback bits remain inside the same capture aperture. Guards,
capture trigger, independent effect backpressure, source hold and POR ownership
are unchanged. Actual-pin wiring checks independently reconstruct all retained
fields; no activity or setup/hold requirement is removed with the unused bits.

O is the original native I2C publisher's completed-frame offer. A is the receipt's
original accepting service/work-clock edge, independent of native copy completion.
C is actual native copy completion. D is the actual selected Host
`ControlCommand.fire`. These are distinct events; native copy completion is
neither A nor D. O, C, A and D retain independent testbench ordinals. A may precede
C; C may precede A. Both must occur before publisher acknowledgment can release
the source. D requires an accepted descriptor and a valid completed bank head.

`FourPhaseFrameReceipt` and `ClickFrameReceipt` retain five POR-owned clocked
bits each: two request synchronizers, acknowledgment and two local reset-release
stages. They transport the publisher's held 337-bit frame without another
payload register. Their ready requires local POR release, the actual work
clock's running state. A changes the receipt's retained ACK
and captures one narrow descriptor on the same edge. The publisher's ACK then
changes through a native completion join; it is not an additional clocked capture.
The original receipt remains on the ungated
front service clock; the falling-edge retained gate still controls work edges.

Original request observation does not depend on bank availability or copy ACK.
`frame.valid` remains the original receipt's actual accepting opportunity A.
Full logical occupancy does not conceal it: a third offered frame trips
`CONTROL_HOST_MAILBOX_OVERFLOW` at A even if copying is delayed and even with D
on that same edge. When D occurs one edge earlier, A succeeds independently of C.
Keep Q=A-D,
0<=Q<=2, independently of physical native-bank return occupancy.

The source packs 264 byte bits, six length bits, overflow, sampled reset/busy
flags and a 64-bit reset epoch. Four fixed physical banks each retain all 337
bits. The descriptor tail advances modulo four at A; native routing advances once
per copy transaction independently. Both start at bank zero after POR. Banks finishing an old return
are separate from the two accepted-undispatched logical credits. These extra
banks provide return spacing; they never authorize a third logical credit.

BD borrows original REQ and payload. Its two-bit route register resets to three
and captures its own increment at O, selecting bank zero first. It holds that
route through the complete original RTZ. The clocked tail is not an input to
the store. Four independent LongHoldBuffers
retain payload through native head acceptance and complete return. Availability
requires input and output REQ/ACK idle plus a 32 ns internal-return guard.

Click sends original phase directly into the native request comparison. A common
native capture pulse captures four payload registers, four bank phase registers,
one global accepted-phase register and its own two-bit modulo-four route. The
route resets to zero and increments on capture. A public asymmetric C-element
asserts the pulse when pending and selected-bank availability are true; after
assertion it remains high until pending falls. Route/phase feedback cannot drop
and reassert the pulse while the same request is pending. Unselected registers
retain their own complete feedback. Each bank toggles its own phase; four global
offers later the global phase has repeated and cannot identify that bank's new
transaction. Availability checks both retained and guarded output phase against
head ACK. There is no phase-masking mux, RTZ adapter or periodic capture clock.

Publisher ACK is a native two-input C-element join of raw copy and receipt ACK
in both variants. There is no copy-ACK synchronizer or copy-qualified ready.
Source request and payload remain retained through joined completion and BD RTZ.
The original receipt still requires clock edges for A and BD return; removal of
the extra copy round trip is not a claim of entirely clockless publication.

Qualification checks actual O-time bank availability, independent native capture
ordinals and exact 337-bit identity at C and D, including identical consecutive
frames and all four wraps. Instantaneous route/tail equality at A is not required:
early A can advance its ordinal before the native route captures. The independent
O/C/A/D ledger proves matching order, and unavailable-bank faults remain visible.

## Context and head dispatch

Two four-bit descriptors retain bank ID and reset/busy context through A. A two-bit
clocked Q retains the exact original capacity/overflow decision. With Q=0, A
writes the first descriptor. With Q=1 and no D it writes the second. A+D at Q=1
replaces the first after its old command capture; Q=2 plus A faults regardless
of D, independently of copy progress.
Both descriptors, Q and tail are POR-owned.

At A, reset context joins the sampled flag, current reset, source/current epoch
mismatch and Services' synchronized application reset. Busy context joins sampled
busy, physical program activity, pending loader effects/control work and an older
Host loader command dispatched on that same edge. The descriptor directly retains
these facts at original A; delayed native copy cannot resample them. No additional
sticky offered-context registers are needed. Epoch comparison still independently
detects complete watchdog episodes. Stored command/reply-edge tests retain their
original assertions.

Each bank has a separate five-bit payload-free head receipt on the ungated front
clock. Only the descriptor-selected valid head may feed Host dispatch. Its ready
requires actual Host D and work-clock running. D retires that descriptor and
acknowledges that same bank once. Nonselected banks and non-Host winners cannot
retire. A queued descriptor waiting for head synchronization retains priority
over CPU MMIO; `mmioLaunch` must require the descriptor queue empty.

The retained raw epoch survives through D. Reset context at D includes A's
retained context, current application reset and raw-bank/current-epoch mismatch.
Current epoch includes a coincident increment. This replaces queued reset debt
and catches complete intervening watchdog episodes, including multiple episodes
before D. Epoch wrap remains a fatal unsupported lifetime boundary. Program busy
at D includes retained A context and current program activity. The existing
ControlCommand crossing captures the final command; no new wide clocked head
copy is introduced. Post-D START recovery and persistent loader effects retain
their original rules.

Application reset resets neither publisher, bank, descriptor, tail, epoch nor
receipt phases. POR aborts their shared lifetime. Stored/MMIO commit/reset/HALT
precedence and the one-outstanding Control dispatcher remain unchanged.

## Digital timing and fixed-ring obligations

SocParameters accepts 1 kHz through 20 MHz: periods of 50 through 1,000,000 ns.
The principal measured sweep covers 3.2 through 20 MHz (312.5 through 50 ns);
that campaign does not redefine the wider parameter contract. Original receipt
observation provides at least two periods from O to A, hence >=100 ns at 20 MHz.
That is only a lower bound on A. R3 first removed the old copy-before-A race by
delaying A. R3b instead makes route ownership independent: A stays on its original
edge and C may finish later. Joined publisher completion retains the source and
head validity blocks early D. No larger assumed delay guard is introduced.

BD's route data path has a complete 10 ns budget and an 11 ns request delay.
Route capture Q is bounded by O+21 ns and decoded selection by O+31 ns. A 32 ns
request guard precedes a preserved atomic AND (1..10 ns), followed by the native
bank's request/capture/ACK path. The resulting copy-ACK bound is:

    32 + 10 + 11 + 10 + 10 + 10 = 83 ns from O.

This historical digital copy bound did not prove the old 100 ns physical race
safe: measured 32 ns guards alone ranged roughly 51-211 ns. The implementation
must no longer depend on copy finishing before that original accepting edge.

Click's complete 1,354-bit transform includes every payload, bank phase and native
route increment. Its source endpoint is 1,691 bits (native route + source + old
bank state). With 10 ns data and 11 ns request delays, 1..10 ns comparison,
atomic capture and register cells, guarded copy ACK is bounded by:

    11 + 10 + 10 + 10 + 32 = 73 ns from O.

All ten Click trigger pins require setup/hold, high/low pulse and distribution
checks. The retained capture pulse returns through accepted-phase feedback,
pending comparison and the capture C-element, with a 3 ns digital minimum. The digital
aperture/distribution assumptions are 100 ps. A 110 ns bank output guard is
separate from copy ACK. These bounds require complete mapped path/distribution
qualification; the fixed digital delay is not an additional decorative buffer.

For the fixed ring, the historical analysis used S(T) as an earliest-next-O
lower bound after A and P(T) as minimum A spacing:

    S_BD = (ceil(111/T)+2)*T + 115 ns
    P_BD = (ceil(111/T)+ceil(115/T)+4)*T
    S_Click = 114 ns
    P_Click = (ceil(114/T)+2)*T

These formulas describe the older digital publisher/receipt path. R3b restores
A as the original descriptor capture. Waiting for both native copy and receipt
at the publisher ACK join adds nonnegative delay to the old earliest-next-O and
A-spacing paths. Thus the formulas remain conservative lower bounds under their
original cell/digital assumptions; they are not exact new ACK latencies or
maximum service deadlines. Receipt ACK still changes at A, while native ACK
follows the characterized join (1-10 ns in the digital cell campaign).
Re-run actual return/capture monitors with those distinct endpoints. In particular,
BD source return must complete both raw copy and receipt RTZ before reuse. Arbitrarily prolonged
copy/return stalls are governed by the handshake, not the old 83/73 ns equations.

FIFO ordering and Q<=2 imply D_i <= A_(i+2)-T before legal reuse. Old source
input/capture feedback must also be quiet by that point: BD's selected input
REQ/ACK return is bounded by 32+10+11+10=63 ns after original REQ falls, before
the original synchronized ACK return and next publication; Click's global
capture/ACK feedback settles before the next original O. Anchor physical bank
return at the later of D_i and old-input quiet, never at an early D alone.

Using a conservative 110 ns BD output-return guard, including a missed receipt
edge and the actual 32 ns availability guard, the conditional return bounds are:

    R_BD <= (floor(120/T)+3)*T + 32 ns
    R_Click <= 20 ns after old capture feedback is quiet

The reuse-O age is at least T+P+S; bank readiness by A_(i+3) gets T+P. Evaluating
all ceil/floor breakpoints over 50..312.5 ns gives minimum
margins of 543 ns BD / 379 ns Click at reuse O, and 198 ns BD / 265 ns Click by
A_(i+3). For T>120 ns the margins simplify to increasing functions:

    BD: reuse 7*T+83 ns; ready-by-A_(i+3) 4*T-32 ns
    Click: reuse 4*T+94 ns; ready-by-A_(i+3) 4*T-20 ns

Thus the same minima cover the entire accepted interval through 1,000,000 ns;
slower periods do not require another bank. Supplemental 1 us and 1 ms period
controls exercise the slower arithmetic regime without changing original
real-wire test deadlines. These are conservative digital arithmetic obligations,
not physical signoff. Directed campaigns must independently observe complete return and
exercise the quantization boundaries, including 50, 57, 57.5, 60, 111, 114, 115,
120, 125 and 312.5 ns. Unbounded forced return stalls must diagnose unavailable
reuse; finite bank count cannot make such stalls safe.

The logical D-to-next-A admission decision remains at most one 50 ns service
period, independently of native copy completion. Same-edge-full rejection still
uses the queue's pre-edge occupancy; a preceding D permits the next A.
Additional physical banks do not solve that native-credit proof. Item 11a2b must
remove Q only with a reviewed path satisfying both next-edge release and
same-edge-full rejection. Otherwise Q remains explicitly temporary while the
native dispatcher removes the periodic edge dependency.

## Sleep and physical obligations

Original pending receipt demand, descriptor occupancy, head receipt busy and
two-stage synchronized native-store busy cover speculative copy, logical work
and complete native return. Q=0 alone is not quiet. Actual A/D require actual
work edges; stopping a clock cannot synthesize receipt progress. Keep the full
synchronized demand and seven-edge ordinary drain guard. Verify final-return
source stopping and wake while preserving LF time, acquisition and permanent
Groundlark power supervision independently of a stalled Host dispatcher.
With workClock stopped before A, a native bank copy may finish while A, tail and
receipt ACK remain held. When the gate returns, original A occurs once. If A
already happened, native C and the publisher ACK assertion can finish even with
both front/work clocks stopped. BD's receipt RTZ still requires its front clock.

Actual native buses require digital aperture checks through source, bank and
ControlCommand capture pins. Synchronous descriptor/epoch/busy context requires
independent pre-edge identity and post-edge destination checks; zero-delay
flip-flops do not prove physical hold time. Metastability, complete data paths,
reset recovery/removal, pin pulse/distribution, clock-gate handoff and supported
configuration limits remain physical item 17 obligations. Old P&R does not
qualify these controllers.

## Verification and state accounting

11a1's committed evidence remains under `build/async-host-frame-migration/`.
11a2a's digitally qualified evidence is under
`build/async-host-admission-payload-migration/`. Native `AsyncFrameStoreSpec`
checks service-clock-free capture, every source bit, repeated bank rotation,
identical payloads, original O/A ordinals, actual pins and POR phases.
`FrameAdmissionSpec` retains its original 14 cases and adds continuous reuse,
multiple completed reset episodes and queued-Host/MMIO priority cases for both
variants. Real I2C, Stored-edge, earliest-status, sleep/wake, firmware and core
reference assertions/deadlines remain required. Structural fingerprints only
attest the reviewed emitted graph; independent simulation/fault controls carry
the behavioral and digital aperture evidence.

R3b requires directed copies slower than two front periods, both relative offer/
completion orders, copy completion after A with front and work clocks stopped,
repeated identical frames across all four banks and both Click phases, admission
reset/busy context that changes before delayed copy, POR and full Q plus same-edge
D. Preserve the exact overflow fatal and independent source, copy, A and D
ordinals. Mutate native route seed/increment, retained Click capture, raw ACK
joining, original-offer visibility and each context fact separately; unrelated
failures do not prove a control. Exercise opposing native route/accepted delays
and every Click capture recipient. The separate R3 results below are historical.

## R3b verification and cost evidence

Current evidence is under `build/async-frame-native-route-repair/`. The focused
campaign passes 46 distinct Scala cases: 12 native-store, 30 admission and four
wake cases. Native stores include 88 seeded runs; additional actual-RTL controls
pass 172 positive and 86 exact-site negative simulations. Structural campaigns
reject 6,368 store mutations and 2,880 receipt mutations. All 463 Python tests
pass after correcting an obsolete external-slot metadata expectation; the
original failed run remains. The composed capture campaign passes 344 cases
(292 positive, 52 exact-site negative), retaining all 312 R3 cases and adding
eight opposing route/accepted profiles plus 24 late-copy runs. Its independent
ledger records 100,124 C-before-A and 192 A-before-C completions. All 20 wake
controls pass (16 positive, four exact-site negative). Four immutable export
snapshots pass 3,762 actual integration mutations (942 per portable export,
939 per inline physical export). The complete affected regression passes 225
verification cases plus four physical-policy tests. Together with the focused
cases, `final-evidence-r1.json` records 275 distinct Scala passes across 29 suites.
All four portable/inline physical strict exports pass. Fresh activity matches
all 27 R3 windows per variant, including durations and fast/work-clock counts;
firmware remains 3,256 work edges BD / 3,161 Click.

The compiled state inventory removes exactly two front-clock copy synchronizers
and two work-clock context bits per variant. BD reuses its native route register;
Click adds two native route bits and uses a retained C-element capture pulse.
Portable periodic totals return to 6,538 BD / 6,539 Click, excluding the unchanged
SDA-edge bit; enabled-policy physical exports contain ten more bits each.
The clocked original receipt, descriptor counter and service scheduler remain.
The matched mapper reports logic area of 3.351460 mm² BD / 4.207351 mm² Click,
respectively −0.05977% / +0.02656% against R3. Existing guards and four payload
banks remain. See the [matched comparison](gf180-matched-comparison.md).
This correction removes an unnecessary clock dependency; it does not establish
lower total storage, standby power, wake energy or physical timing closure.

The first focused run retained 30 fixture-elaboration failures: nested native
route observation needed `BoringUtils`. Four subsequent stop-clock fixtures had
a SystemVerilog declaration after executable statements; their corrected reruns
pass. Two initial negative-control campaigns rejected stale expected fatal sites;
the final controls require the exact observed missed-copy-ACK site. Original
logs and binaries remain. The first portable strict attempts exceeded the default
600-second host allowance. Independent replay of the exact original BD/Click
binaries passes 803,760,768 / 697,428,723 checks in 1,731.36 / 1,720.88 seconds.
Final strict checks use the existing 3,600-second host allowance, as R3 did.
Original probes, binaries and inputs remain hash-bound; no functional expectation,
simulated deadline or coverage requirement was relaxed. Fresh review receipts
cover production wiring, emitted state/ABI, exact negative sites, all executed
campaigns, mapped cost, wake activity and strict execution provenance.

## Historical state accounting through R3

The emitted comparison against `a0e2d1a` confirms unchanged 34-port public tops
and 516 fewer periodic-clocked bits per variant. The old 550-bit mailbox/count/
debt becomes ten descriptor/count bits, removing 540. Four five-bit head
receipts plus two tail and two busy-synchronizer bits add 24. Existing original
receipt and epoch state are outside that subtraction. Four native 337-bit banks
add 1,348 payload bits plus native controls; there is no claim of smaller total
storage, mapped area or power. All 34 new temporary clocked bits remain audit
candidates for 11a2b, 11b and 14. The independent 15-bit snapshot crossing remains.

R3 at `a3f11af` added four periodic-clocked bits per variant beyond that implementation:
two copy-ACK synchronizers and two descriptor-context facts. It adds one native
completion C-element (three inputs BD, two Click), with no payload bank. Count
these controls in the matched mapper and state inventory. This correction keeps
the real clocked descriptor consumer; it does not remove its scheduler, establish
minimum clocked state or qualify physical capture/reset/fork timing.

The final R3 physical-r2 exports have completed matched mapping against C1;
see [incremental cost and constraint binding](gf180-matched-comparison.md#r3-incremental-frame-completion-comparison).
Logic area increases 0.04833% BD / 0.00423% Click. The exact preserved-native
increment is one C-element, 15/13 physical leaves, and all existing native payload
storage/guards remain unchanged. Both copy first stages remain timed; constraint
binding adds no false paths. Evidence is under `build/async-frame-completion-repair/`
in `mapped-cost-r2/receipt.json` and `constraints-binding-r2.json`. Fresh native-model
activity (`activity-r1-receipt.json`) measures unchanged clock-edge counts and
durations in all 27 maintenance/sampling/firmware windows per variant; it does not
measure loader transfer latency. The R3 final functional and fresh-review gates
pass; physical timing remains unqualified.

## R3 final verification

Evidence under `build/async-frame-completion-repair/` retains every failed attempt
and its diagnosis. `final-evidence-r1.json` records 262 distinct passing Scala
cases in 28 suites after affected reruns, 457 Python tests plus the final ten-case
integration-helper rerun, and all four portable/physical strict exports. This
includes both core/reference implementations, firmware, service/reset/sleep,
real-wire I2C and the 33 focused frame-admission/wake cases.

The final campaigns pass 312 capture controls (260 positive, 52 exact-site
negative), 20 wake controls (16 positive, four negative), 2,880 receipt mutations
and 3,868 actual RTL integration mutations. Extracted integration inputs are
immutable snapshots bound to their final export origins; inline inputs and all
mutants retain hash attestations. Independent review additionally exercised
seven completion/rearm/context mutants and checked emitted state, ABI, mapped
cost, measured activity and the campaign receipts under `review-r1/`.

Initial synthetic-delay tests failed because the override did not bind, then
because an injected 8 us delay exceeded the ordinary 2 us POR. Overrides now
resolve exactly one metadata owner/primitive; only those artificial-delay cases
use 20 us POR. Initial strict checks exposed missing retained aliases and
semantic-marker/emitted-alias binding assumptions, all corrected before the
final exports. Supplemental campaigns also exposed stimulus, exact co-fatal,
mutator-formatting and mutable-input attestation failures; original logs remain.

The first broad run passed 140 of 153 cases. Twelve I2C failures came from the old
structural assumption that receipt ready equals work-gate running immediately
after reset. The updated independent ready oracle also checks actual retained
copy phase; all functional wire/reset/overflow assertions and stimuli remain.
The remaining failure was a 240-second BD cold-boot host timeout. Independent
replay of the exact unchanged binary passed in 251.222 seconds, preserving all
original artifacts and the 1.2-second simulated deadline. Only this BD test's
host allowance changes to 600 seconds; its fresh Scala rerun passes. No functional
expectation or simulated deadline was relaxed.
