BiscutLabs/RISCay-MCU/docs/gf180-matched-comparison.md

# Matched service-architecture comparison

This comparison initially froze further service-island migration. The user's
subsequent direction on 2026-10-13 authorizes correcting redundant storage and
clocked coordination around the native services; see the
[historical corrective checklist](history/migration-log.md#corrective-gates-from-the-independent-reviews).
The comparison results below remain the measured baseline. Matching the mapper, SRAMs, native
core timing and workload confirms that the migrated services cost substantially
more area and active-clock work. Keep both native CPUs and all later correctness
requirements while evaluating a smaller service architecture. Restoring the old
raw-reset implementation is not an acceptable rollback.
A corrected service architecture must retain the newer correctness requirements
and be measured again; the historical baseline does not guarantee its final cost.

The compared RTL revisions are `8637099bb603543b4d8e1d76de2bf165bbaa171a`
and `2e4169c2f1befd1e8c5dfc704d9e936fe70e1a90`. No production RTL changes
are part of this measurement. The flip-flop-memory `4b5d105` experiment is not
the baseline here.

## R3b native frame routing

This incremental comparison uses committed R3 (`a3f11af`) and the final R3b
`physical-r1` exports. The mapper sources, Yosys/ABC/sv2v binaries, five pinned
Liberty corners, physical policy, control-delay mapping and normalized synthesis
commands match the R3 run. No P&R or STA run is included.

| Metric | R3 BD → R3b BD | R3 Click → R3b Click |
| --- | ---: | ---: |
| Logic area excluding SRAM (mm²) | 3.353464 → 3.351460 | 4.206234 → 4.207351 |
| Mapped leaves, including SRAM | 122,751 → 122,539 | 124,521 → 124,561 |
| TT listed-state leakage, including SRAM (µW) | 8.765842–11.459462 → 8.760285–11.451153 | 10.450277–14.177046 → 10.452129–14.179303 |
| Front/service-clock storage cells | 1,333 → 1,331 | 1,337 → 1,335 |
| Front/service storage clock-input capacitance (pF) | 4.461361 → 4.454669 | 4.474775 → 4.468083 |
| Work-clock storage cells | 4,733 → 4,731 | 4,784 → 4,782 |
| Work storage clock-input capacitance (pF) | 16.585777 → 16.579085 | 16.757203 → 16.750511 |
| Preserved native physical leaves | 66,127 → 66,125 | 71,531 → 71,542 |
| Firmware work-clock edges per wake | 3,256 → 3,256 | 3,161 → 3,161 |
| Maintenance work-clock edges per wake | 22 → 22 | 19 → 19 |
| Sampling work-clock edges per wake | 216 → 216 | 214 → 214 |
| Retired instructions per firmware wake | 43 → 43 | 43 → 43 |

Logic area changes **−0.05977% BD / +0.02656% Click**. Each variant removes
two copy synchronizers and two retained admission-context bits, reducing each
front/work clock load by 0.006692 pF. BD reuses its two native route bits with
a different reset seed and reduces its completion join from three inputs to two.
Click adds two native route bits, replaces its capture AND with a C-element and
widens the existing data transform by two route bits. No payload bank is added.
The private AND bindings in BD's bank routes are unchanged by this item.

Eight compiled hierarchy inventories independently confirm portable nonprimitive
totals of 6,539 BD / 6,540 Click, or **6,538 / 6,539 periodic bits** after excluding
the unchanged SDA-edge bit. Enabled-policy physical exports contain ten more bits
per variant: 6,549 / 6,550 nonprimitive, or 6,548 / 6,549 periodic. These counts
exclude the generated chip wrapper and SRAMs; they are not mapped cell counts.
Native primitive register declarations remain 14,221 bits in BD and increase
14,382 → 14,384 in Click. Click's retained C-element pulse is recorded separately
as a primitive change; combinational feedback state is not a Verilog register.

All native binding changes are confined to the frame store and completion join.
The four 337-bit frame banks and matched-control guard area remain unchanged;
guard area is 0.594065 mm² BD / 1.146281 mm² Click. All three SRAMs, the 34 external
ports in each portable/physical export, and every chip wrapper/oscillator/reset/
supply model are unchanged. Ordinary logic remaps under the same ABC policy;
fewer periodic storage cells do not imply lower total mapped area or leakage,
as the measured Click increase demonstrates.

Fresh native-model activity contains 22 maintenance, three sampling and two
firmware windows in each variant. All 27 ordinals retain their R3 classifications,
fast/work-clock counts, retired counts, ADC counts and durations. Every measured
delta is zero; the audit records changes rather than requiring unchanged
performance. Firmware windows last 271,691.173 ns BD / 263,774.443 ns Click.
The testbenches and 50 uploaded words are identical, and the audit verifies
current source/binary hashes and exact final R3b I2C target/store RTL. These
windows exclude loader transfer latency and do not measure energy.

Final constraints bind 15,321 paths / 230 stages / 14,221 capture monitors for BD
and 15,594 / 131 / 14,384 for Click. Click's two route bits add two paths and two
capture monitors. Both variants retain the same 40 pre-existing first-stage
false-path declarations. The removed copy synchronizer also removes its timed
residual CDC entry; no timing exemption is added. Binding is not qualification
of the new feedback path or any reset, pulse, setup/hold, slew/load or routed path.

Evidence is under `build/async-frame-native-route-repair/`: final `mapped-*-r1/`,
`mapped-cost-r1/receipt.json` (1,799 input hashes), `constraints-abi-r1.json`
(79 hashes), their audit scripts/logs, and `mapping-source-exports-r1.json`.
`reviewer-mapped-constraints-r1.json` freezes 1,890 evidence hashes. Accounting
adapts the reviewed independent Liberty/Decimal and clock-pin graph audit;
`emitted-state-r2/receipt.json` binds the compiled inventories with 1,299 hashes.
`activity-r1-receipt.json` binds 475 activity inputs, and
`reviewer-cost-state-activity-r1.json` freezes 2,583 combined evidence hashes.
Affected functional and strict checks pass; fresh independent review covers
the mapped/compiled inventories, activity, unchanged public ABI and all constraint
bindings. See [R3b verification](frame-admission-contract.md#r3b-verification-and-cost-evidence).
Listed-state leakage is a library envelope, not measured reachable standby power.
Storage clock-pin capacitance excludes routing/CTS and does not establish energy.
Historical physical failures remain open.

## R3 incremental frame-completion comparison

The frame-copy completion repair is mapped against committed C1 (`abcd1d2`),
using final `physical-r2` exports. This is a separate incremental comparison;
the historical R4 tables below retain their original revisions. The mapper
sources, Yosys/ABC/sv2v binaries, pinned Liberty files, physical policy, guard
mapping and normalized synthesis commands match C1. No P&R or STA run is included.

| Metric | C1 BD → R3 BD | C1 Click → R3 Click |
| --- | ---: | ---: |
| Logic area excluding SRAM (mm²) | 3.351844 → 3.353464 | 4.206056 → 4.206234 |
| Mapped leaves, including SRAM | 122,587 → 122,751 | 124,516 → 124,521 |
| TT listed-state leakage, including SRAM (µW) | 8.761202–11.452980 → 8.765842–11.459462 | 10.448732–14.176661 → 10.450277–14.177046 |
| Front/service-clock storage cells | 1,331 → 1,333 | 1,335 → 1,337 |
| Front/service storage clock-input capacitance (pF) | 4.454669 → 4.461361 | 4.468083 → 4.474775 |
| Work-clock storage cells | 4,731 → 4,733 | 4,782 → 4,784 |
| Work storage clock-input capacitance (pF) | 16.579085 → 16.585777 | 16.750511 → 16.757203 |
| Preserved native physical leaves | 66,112 → 66,127 | 71,518 → 71,531 |
| Firmware work-clock edges per wake | 3,256 → 3,256 | 3,161 → 3,161 |
| Maintenance work-clock edges per wake | 22 → 22 | 19 → 19 |
| Sampling work-clock edges per wake | 216 → 216 | 214 → 214 |
| Retired instructions per firmware wake | 43 → 43 | 43 → 43 |

Logic area increases **0.04833% BD / 0.00423% Click**. The added native C-element
maps to 15 BD or 13 Click leaves; every existing native binding, native storage,
guard area and all three SRAMs remain unchanged. Ordinary logic is remapped by
the same ABC policy, so total cell-count changes are not the new join count plus
four flip-flops. The four added clocked bits are two copy-completion synchronizers
and two retained admission-context facts. No payload bank is added.

Fresh native-model activity contains 22 maintenance, three sampling and two
firmware windows per variant. Every recorded window retains its C1 classification,
fast/work-clock counts, ADC count, retired count and duration; measured deltas are
zero. The audit records all old/new ordinals and flags changes rather than requiring
unchanged performance. It verifies identical stimulus and observers, the same
50 uploaded words, current source/binary hashes and exact final R3 I2C RTL.
The measured testbenches are identical.
These measured windows exclude loader transfer latency. The added synchronizers
and context facts increase front and work storage clock-input capacitance by
0.006692 pF each per variant despite unchanged measured clock-edge counts.

Final constraint generation binds 15,321 paths / 230 stages / 14,221 capture
monitors for BD and 15,592 / 131 / 14,382 for Click. The new join adds one bound
path per variant. Both retain the same 40 pre-existing first-stage false-path
declarations; the new copy synchronizer is explicitly recorded with
`none-preserve-synchronous-control`. Neither the new stage nor the completion
path receives a false-path exemption. Binding is not timing qualification.

Evidence is under `build/async-frame-completion-repair/`: final `mapped-*-r2/`,
`mapped-cost-r2/receipt.json` (1,285 input hashes), `audit_mapped_r2.py`,
`constraints-binding-r2.json` and its audit script/log. Fresh activity is recorded
in `activity-r1-receipt.json` (470 input hashes) and `audit_activity_r1.py`; the
frozen reviewer handoff is `reviewer-cost-activity-r1.json`. Accounting adapts C1's
reviewed independent Decimal/Liberty and hierarchical clock-pin audit. R3's
affected functional checks, all four strict exports and fresh independent review
pass; `final-evidence-r1.json` binds the final sources and result receipts.
All five listed-state leakage corners are retained in the receipt. These are
library state envelopes, not measured reachable standby power. Clock-pin
capacitance excludes routing/CTS and does not determine wake energy. Historical
R4 physical failures remain open; this correction does not qualify reset, pulse,
setup/hold, slew/load or routed timing.

## Matched mapping and activity

| Metric | Baseline BD | Current BD | Baseline Click | Current Click |
|---|---:|---:|---:|---:|
| Mapped logic area, excluding SRAM (mm²) | 0.576457 | 3.492221 | 0.594447 | 4.345699 |
| Control guards (mm², included above) | 0.018892 | 0.594065 | 0.027954 | 1.146281 |
| TT listed-state leakage, including SRAM (µW) | 2.217–2.890 | 9.129–11.987 | 2.253–2.982 | 10.817–14.705 |
| Firmware work-clock edges per wake | 866 | 3,256 | 866 | 3,161 |
| Maintenance work-clock edges | 10 | 22 | 10 | 19 |
| Sampling work-clock edges | 183 | 216 | 183 | 214 |
| Work storage clock-input capacitance (pF) | 6.358257 | 20.774969 | 6.358257 | 20.946395 |

All candidates have three identical SRAM macros: 2 KiB program and 1 KiB working
memory. Their combined LEF footprint is 0.466241 mm². The report keeps SRAM
Liberty area and LEF footprint distinct. The real 100,000-edge POR hold is included
in mapping. Five pinned Liberty corners are reported in the evidence.

Each activity run contains 22 maintenance windows, three sampling windows and
two firmware windows. Every firmware window retires exactly 43 instructions.
Real I²C upload, commit, lock, deadline sleep and ADC pin stimulus are unchanged.
Both revisions use identical supported default core policies; the old physical
emitter's different timing experiment is not used. The baseline harness-only
patch inlines its original assertions so Icarus executes them. Baseline metadata
explicitly retains its historical reset limitations and cannot pass the
production v3 policy gate.

The workload uses the same 12 MHz service oscillator and approximately 7.7307 Hz
LF model. It exercises Groundlark OFF/restart qualification, not RUN/SHUTDOWN.
The implementation clock target remains 20 MHz.

These are library estimates and native-model activity, not silicon energy.
Leakage sums independent listed cell states, which need not form one reachable
standby state. Storage clock-pin capacitance excludes buffers, CTS and wires.
Native activity counts width-weighted capture opportunities, not changed bits,
glitches or internal switching energy. Analog and pads are excluded. The
6.06×/7.31× logic-area increase, larger leakage, loads and wake counts justify
freezing further state removal without claiming a complete energy measurement.

Large native owner groups include I²C (0.522/0.608 mm² BD/Click), elapsed scaling
(0.339/0.377), Control (0.331/0.397), and program/RAM access (each 0.221/0.299).
These disjoint hierarchy groups include nested bridges and guards. Guard area
crosses those owners; do not add the two decompositions. Rework must preserve
reset containment, accepted effects, ABI, lock, retention and permanent power
supervision.

## Physical experiment

The common outline is fixed before placement at 3,250 µm square, with the same
30 µm core inset, macro coordinates, PDN, placement settings, routing seed, eight
threads and pinned tools. It derives from the largest mapped logic candidate at
45% target occupancy plus SRAM footprints and core inset. Placement uses density
0.50 for every candidate. This does not establish minimum die size.

Nominal, minimum and maximum RC are extracted independently from the same routed
checkpoint, each with its own bound ODB/SPEF. The flow analyzes five cell corners
against each RC view. Reset-tree repair and the full reset envelope remain R2b
obligations; other timing-closure work remains under item 17. Routing success is
not qualification.

| Routed metric | Baseline BD | Current BD | Baseline Click | Current Click |
|---|---:|---:|---:|---:|
| Placed cells plus SRAM (mm²) | 1.058367 | 4.024985 | 1.079839 | 4.880987 |
| Routed wire length (m) | 1.316968 | 5.864487 | 1.325040 | 6.401379 |
| Detailed-router violations | 0 | 0 | 0 | 0 |
| TT/nom local probe groups | 85 | 1,228 | 83 | 1,495 |
| Local timing violations | 0 | 395 | 0 | 47 |
| Uncovered local probe groups | 0 | 0 | 0 | 0 |

The local probe inventory additionally contains ten constant groups and four
reset-only groups across the four designs. These are not dynamic timing passes.
The targeted FF/min and SS/max checks cover the former missing dynamic probes:
BD's address C-element measures 8.091–11.020 ns at SS/max, exceeding its 10 ns
maximum. Click's corresponding acknowledge guard measures 200.045–211.952 ns;
its local contract has a 32 ns minimum and no upper bound. That PASS does not
establish a controller deadline or reset envelope. Full local probes here use
TT/nom only, supplemented by those selected corners; they are not a complete
fifteen-corner local timing campaign.

Signed STA diagnostics are retained: 202 negative reset-only measurements in BD
and 40 negatives in Click (24 dynamic). Every dynamic negative belongs to a
VIOLATION group. Independent old/per-group and optimized/global contexts agree
point by point. The inspected negatives arise from Liberty extrapolation beyond
an 8.6 ns slew-table ceiling: BD's reset input is modeled at 537.8 ns; Click's
generated `~porReleased` net drives 3,300 instance terminals and reaches about
641/548 ns rise/fall slew. Its downstream buffer then receives 55.3 ns slew.
These out-of-range results are not credible physical delay bounds. The collector
rejects a dynamic-negative PASS, and R2b must repair this internal POR tree as
well as other reset distribution before qualifying reset or local timing.

The old probe logs contain two BD omissions and one Click omission. BD's initial
data path is proven constant zero. The dynamic omissions are automatic STA loop
cuts inside preserved primitives. Separate local measurements retain source
slew, cut outgoing timing edges at selected output/capture boundaries without
changing physical connections, and
require each meaningful source/sink polarity pair. Constant and reset-only
cases are distinct from timing passes. Keeper feedback, complete controller
loops, pulse/aperture and reset envelopes remain separate obligations.

The four corrected routes, all 60 clocked corner reports and full TT/nom probes
are complete. Independent review found that an early constraint fallback to
module inputs omitted locally retained state. Those first attempts remain
diagnostic evidence. The corrected fallback bounds all register launches to the
exact destination, with explicit endpoint-qualification limits. The final
independent receipt confirms complete evidence for the R4 cost decision while
retaining open timing violations. R2b reset distribution comes next.

## Reproduction

Evidence is under `build/matched-service-comparison/`. The baseline is a detached
worktree; `tools/gf180_matched.py setup-baseline` records its two-file patch.
Run sbt serially in each checkout to emit `riscay.physical.EmitPhysical` and run
`riscay.PhysicalEstimateSpec`. Use `gf180_matched.py map-inputs`,
`gf180_implement.py` and `report_gf180_matched.py --output <new-report.json>`
with the same locked assets. Baseline policy requires the explicit comparison
option. Keep original logs and use fresh output paths for reruns.

The independent numerical review uses its own Decimal/Liberty parser and graph
traversal. It reproduced areas, five leakage corners, clock loads, storage
observer coverage, all wake windows, and identical core/workload contracts.
The final mapping/activity report is `mapped-cost-r4.json`; it validates eight
measurement/preparation helpers and the independent audit's 432 artifact files
and 190 source files, including the four executed testbenches, binaries and logs.
Reproduction requires that independent audit receipt (`--audit-receipt`), not
just copying the displayed totals. Ten provenance controls reject stale or
missing bindings. Four physical-policy cases and all 428 Python controls pass.
The new executable Tcl controls reproduce the endpoint-cap failure across both
polarities and reject a mutation restoring the old accounting.
Preparing the local timing graph once preserves all pair/polarity checks while
avoiding repeated whole-design rebuilds. Independent differential checks match
17,980 measurements across all 295 completed original groups, retain existing
violations and detect the
same actual interior-arc mutations. `--run-tag context-r3` keeps the new complete
sweeps separate from the original reports and interrupted current-BD attempt.

The final independent physical receipt is
`physical-review/r4-physical-provenance-r1.json`, SHA256
`18e890ad30954d6d4ed6fed4a56bb1b394c81007e80009e0c4ba014dfe03609a`.
It binds 1,119 inputs and 12 helper files, all four corrected routes, 60 clocked
views, 257,148 complete local polarity/mode measurements, original/new
differential checks and actual-path negative-delay diagnosis. Seventeen
collector controls pass. The mapping/activity provenance receipt is
`cost-review/r4-provenance-receipt.json`, SHA256
`c7bfd7b02421cc6c4627ea663205b5b417cb2f69de8a193fcfae88f14e7f5757`.
All paths in this paragraph are relative to the evidence directory above.
