BiscutLabs/RISCay-MCU/docs/gf180-estimates.md

# GF180 area, standby and wake-energy estimates

The current generic-MCU correction is measured in the [area ledger](area-ledger.md):
2.100657 / 2.894444 mm² mapped logic and 2.283901 / 3.099576 mm² repaired logic
(BD / Click), excluding SRAM. Earlier leakage/power estimates below have not been
rerun for the changed boot ROM and removed supervisor; they are historical bounds,
not current deep-sleep power measurements.

The [matched service comparison](gf180-matched-comparison.md) supersedes the
cross-method comparisons below. Its mapped area/activity and completed P&R runs
are independently audited. The subsequent corrective work targets redundant
storage and clocked coordination while preserving native BD/Click; see the
[migration checklist](async-soc-migration.md). Physical timing remains unqualified.

## Electrical repair area

The newer [11b1 matched measurement](reviews/control-frame-borrow.md) reports
**3.014986 / 3.795762 mm²** of repaired logic (BD / Click), excluding SRAM, and
268 fewer periodic flip-flops per variant. Digital verification passes; the
new path remains physically unqualified.
The tables below retain the preceding physical baseline and its provenance.

These are totals over every physical leaf in the accepted electrical-first maps
(`bounded-distribution-bd-r2` and `-click-r2`, RTL at the merged PR #8 tree,
with bounded native trees and three exclusive SRAM clock drivers).
The comparison is the original and repaired graph of **the same mapping**, not
the earlier A2b RTL. Pinned LEF dimensions supply physical cell footprints.
SRAM's three unchanged macros occupy **0.4662406590 mm²**; their distinct
Liberty area fields sum to 0.6282008304 mm². Both totals are reported explicitly.
Standard-cell areas agree between the two views.

| Area metric (mm²) | BD | Click |
|---|---:|---:|
| LEF footprint before repair, including SRAM | 3.3146048574 | 4.0794827838 |
| LEF footprint after repair, including SRAM | 3.5052426110 | 4.2894580542 |
| Liberty area sum before repair, including SRAM | 3.4765650288 | 4.2414429552 |
| Liberty area sum after repair, including SRAM | 3.6672027824 | 4.4514182256 |
| Before repair, excluding SRAM | 2.8483641984 | 3.6132421248 |
| After repair, excluding SRAM | 3.0390019520 | 3.8232173952 |
| Repair increase | **0.1906377536** | **0.2099752704** |
| Added native-reset distribution buffers | 0.0153707904 | 0.0187953024 |
| Three exclusive SRAM clock drivers | 0.0002502528 | 0.0002502528 |
| Added hierarchy-writer feedback buffers | 0.0117223680 | 0.0291873792 |
| Other OpenROAD buffers | 0.1261888768 | 0.1239366016 |
| Added constant ties | 0.0017034752 | 0.0014839552 |
| Net change from equivalent ordinary-cell resizing | 0.0354019904 | 0.0363217792 |

The buffer counts are 1,167/1,427 reset, 890/2,216 writer workaround, and
1,958/1,931 other OpenROAD buffers (BD/Click), plus three SRAM clock drivers each.
The bounded-tree/clock-driver update increases repaired logic area by
0.0067568256 / 0.0063572992 mm² relative to the previous electrical-first maps.
Exact accounting reconciles
`after - before = added cells + net resizing`; no workaround cell is hidden.
Fixing the writer or proving a flat-netlist repair could remove the workaround
cost, at most the currently listed 0.0117/0.0292 mm² before any replacement
distribution. It would not eliminate most of the repair cost. Neither alternative
has yet passed the required graph and roundtrip proof.

Reproduce with `python tools/report_repair_area.py <mapping> <new-output.json>`
and the configured physical-tool environment. The report validates the complete
repair receipt, records hashes and inventories every leaf. Evidence is
`build/bounded-area-bd-r1.json` and `build/bounded-area-click-r1.json`.
The previous electrical-first reports remain in `build/repair-area-{bd,click}-r2.json`.
Independent review caught the original Liberty/LEF naming error; the earlier
`repair-area-*-r1` reports remain as superseded accounting. Seven focused tests cover distinct
SRAM views, hierarchical leaves, resizing/additions, missing areas and overlapping
or empty named inventories.
These are cell totals before placement, excluding routing, fillers, analog and
pads. They do not establish leakage, wake energy or timing closure. The older
activity and leakage tables below do **not** describe these repaired maps.

### Wide capture-driver correction

The subsequent `capture-drive-{bd,click}-r1` maps use stronger wide
EventRegister capture roots/trunks. Standard-cell area after repair becomes
**3.0391600064 mm² BD / 3.8246398848 mm² Click**, increases of
0.0001580544 / 0.0014224896 mm². Before repair it is 2.8485222528 /
3.6146646144 mm². Repair-added area, resize deltas, cell counts and SRAM area
remain unchanged; these changes replace existing buffer masters only.

The corresponding LEF totals including SRAM are 3.5054006654 /
4.2908805438 mm². Evidence is `build/capture-drive-{bd,click}-area-r1.json`.
The [capture contract](native-capture-distribution.md#capture-driver-correction-after-pr9)
records local timing and its limits. This correction does not update leakage,
wake activity or routed-area estimates.

## Earlier A2b comparison

The A2b retained-loader-metadata comparison against accepted C1e1 `64e6211`
uses the same pinned mapper, macros, native bindings and five-corner cost
method. Acceptance: **digitally verified; matched cost recorded; physical timing open**. Logic area excluding SRAM is
**2.8309672384 / 3.5965234816 mm²** (BD / Click); the measured area
changes are **-1.1045% / -0.9128%**.
The mapped work-clock inventory falls from 4,068 to 4,009 storage-cell inputs in BD and from 4,119 to 4,060 in Click. Pin-only clock capacitance falls from 14.378128 to 14.183811 pF and from 14.549554 to 14.355237 pF, respectively. The complete fanout inventory reports 43 to 43 BD and 46 to 42 Click nets exceeding a listed pin-capacitance limit; wire RC, slew and the full capture/hold aperture remain unqualified. All 27 ordinal wake windows per variant remain unchanged; the 43-instruction firmware wakes still use 3,255 BD / 3,160 Click work-clock edges.

| A2b listed-state leakage, including SRAM | BD (µW) | Click (µW) |
| --- | ---: | ---: |
| TT / 25°C / 3.3 V | 7.496075–9.710117 | 8.961381–11.964312 |
| SS / -40°C / 3.0 V | 6.102031–7.702081 | 7.294739–9.488268 |
| SS / 125°C / 3.0 V | 44.400154–48.592716 | 48.659267–54.434697 |
| FF / -40°C / 3.6 V | 8.881997–11.142658 | 10.608502–13.548919 |
| FF / 125°C / 3.6 V | 250.992944–557.391048 | 320.157194–653.981167 |

These per-cell listed-state envelopes are not reachable deep-sleep
measurements or complete silicon power bounds. Analog, pads, clock/reset
distribution and routed overhead remain excluded. All observed increases
and timing failures are retained; see [the A2b report](reviews/loader-metadata-a2b-completion.md).

The prior [C1e1 request-receipt measurement](application-reset-boundary.md#c1e1-retained-cpu-request-receipt)
compares against the accepted C1f maps using the same mapper, assets, policies
and five-corner accounting. Logic area falls **0.2404% BD / 0.2999% Click** to
**2.862584704 / 3.629653440 mm²**, excluding SRAM. The complete mapped hierarchy
contains **103,349 / 105,247** leaves, including the unchanged three SRAMs and
**56,276 / 61,661** preserved native cells. The four deleted request payload
objects total 70 periodic bits per variant; all nine receipt control/reset bits and
all native storage remain. Service storage clock-pin load falls **0.234220 pF**
per variant, to **4.193681 / 4.207095 pF**. Work-clock load stays **14.378128 /
14.549554 pF**. All 27 ordinal wake windows are unchanged, including both
43-instruction firmware wakes at **3,255 / 3,160 work edges**.

| C1e1 listed-state leakage, including SRAM | BD (µW) | Click (µW) |
| --- | ---: | ---: |
| TT / 25°C / 3.3 V | 7.577419–9.818140 | 9.043886–12.090826 |
| SS / -40°C / 3.0 V | 6.168063–7.787103 | 7.361771–9.587289 |
| SS / 125°C / 3.0 V | 44.951562–49.193714 | 49.161935–55.008372 |
| FF / -40°C / 3.6 V | 8.978283–11.266171 | 10.706138–13.690175 |
| FF / 125°C / 3.6 V | 253.568210–563.763014 | 323.102086–660.434374 |

Both ends decrease at every corner. These independent per-cell listed-state
envelopes are not reachable deep-sleep measurements or complete silicon bounds.
Analog, pads, clock/reset distribution and routed implementation overhead are
not included. The receiving-aperture results and unproved native/mask/clock/RC
obligations remain explicit in the request contract; no timing or energy
qualification follows from these cost reductions. Evidence is retained under
`build/async-quiescing-receipt-measurement-r3/`.

The prior [C1f saved-address measurement](sram-integration.md#c1f-saved-address-narrowing)
uses A5b `67b282cf` and the same mapper/assets/policies and five-corner accounting.
Logic area changes **-0.1878% BD / -0.0782% Click**, to
**2.869484 / 3.640572 mm²** excluding SRAM. TT listed-state
leakage including SRAM becomes **7.595104–9.845576 / 9.071659–12.132237 µW**.
Click FF125 high listed-state leakage increases **0.231845076 µW**
from ordinary-logic cell composition (low changes -0.277877088 µW).
Periodic RTL loses 43 bits per variant; native storage, ABI and macro topology
remain unchanged. Of 27 ordinal windows per variant, **0 BD /
0 Click** change; all values remain recorded. Bounded
controller timing reports violations in **20/20**
cases and missing coverage in **20/20**. Real native
aperture, clock/reset distribution, route RC, SRAM and A7 qualification remain
open. Setup timing worsens: largest matched endpoint slack changes are
**-17.39656 ns BD / -21.38074 ns Click**
at SS125; hold minima remain unchanged. These are unplaced estimates, not
physical timing acceptance, deep-sleep power or wake energy.

The prior [A5b addressed-byte measurement](native-i2c-byte-store-contract.md#matched-cost)
uses the same mapper and five-corner accounting as C1d. Logic area falls
**1.9160% BD / 1.5153% Click**, to **2.874882 / 3.643422 mm²** excluding SRAM.
TT listed-state leakage including SRAM becomes **7.607764–9.867172 /
9.079021–12.144499 µW**. Native payload storage loses 513 bits per variant;
periodic state, periodic clock-pin loads and all 27 matched wake windows remain unchanged.
Functional, frame-control and strict export checks pass. The byte-write
transform exceeds its 10 ns allowance at slow corners, and the changed upstream
transform fails at TT and both SS corners. Relative setup/hold screens remain
conditional. These are pre-layout estimates, not measured deep-sleep power
or wake energy.

The prior [C1d SPI comparison](spi-player-contract.md#matched-cost)
uses the same mapper and five-corner accounting against `a8c0300`. Logic area
falls **0.2730% BD / 0.3012% Click**, to **2.931040 / 3.699481 mm²** excluding
SRAM. TT listed-state leakage including SRAM becomes **7.752528–10.033946 /
9.222217–12.361046 µW**. Each variant loses 90 periodic bits and 0.290708 pF
of mapped storage clock-pin load. All 27 matched wake windows remain unchanged.
Functional, actual-wiring and strict export checks pass. Local selected
setup/hold paths pass, while slew and capacitance failures remain explicit.
These figures do not update P&R or measure reachable deep-sleep power or wake energy.

The prior [A5a observation comparison](native-area-reduction.md#a5a-native-i2c-observation-projection)
uses the same mapper and five-corner accounting against `5e1406b`. Logic area
falls **1.2155% BD / 1.0008% Click**, to **2.939063 / 3.710656 mm²** excluding
SRAM. TT listed-state leakage including SRAM becomes **7.772042–10.062488 /
9.252447–12.399941 µW**. Periodic storage and clock-pin loads are unchanged.
All 27 matched wake windows per variant are unchanged, including 43-instruction
firmware wakes at **3,255 / 3,160 work-clock edges**. Functional, strict export
and actual-pin mutation controls pass. Complete publication/capture/reset
timing remains unqualified. These figures do not
update P&R or measure reachable deep-sleep power or wake energy.

The prior [A2a CRC comparison](native-area-reduction.md#a2a-narrow-whole-word-crc-feedback)
uses the same mapper and five-corner accounting against `7bb7b71`. Logic area
falls **4.0985% BD / 4.2730% Click**, to **2.975227 / 3.748168 mm²** excluding
SRAM. TT listed-state leakage including SRAM becomes **7.864666–10.202253 /
9.346913–12.543369 µW**. Periodic storage, clock-pin loads and all 27 matched
wake windows per variant remain unchanged; firmware wakes retire 43 instructions
in **3,255 / 3,160 work-clock edges**. Functional, mutation and strict export
checks pass. Measured CRC transform timing still fails its data allowance;
complete capture/reset and routed qualification remain open. These figures do
not update P&R or measure reachable deep-sleep power or wake energy.

The prior [A1b elapsed-loop comparison](native-area-reduction.md#a1b-bounded-native-elapsed-loop)
uses the same mapper and five-corner accounting against `0f6e26f`. Logic area
falls **5.5516% BD / 5.4050% Click**, to **3.102377 / 3.915477 mm²** excluding
SRAM. TT listed-state leakage including SRAM becomes **8.176051–10.596532 /
9.763012–13.152871 µW**. Periodic state and its clock-pin load are unchanged.
All 27 matched wake windows per variant retain their classes and effects and
lose one fast/work edge; firmware wakes retire 43 instructions in **3,255 /
3,160 work-clock edges**. Functional and strict export checks pass. Arithmetic
data-budget failures remain explicit; these numbers do not update P&R, qualify
physical timing or measure reachable deep-sleep power or wake energy.

The [C1b retained peripheral/SRAM cleanup](held-peripheral-capture-contract.md#matched-cost)
is digitally verified. Against `2676845`, the same mapper and five-corner
Liberty accounting show logic area falling **1.78% BD / 1.41% Click**, to
**3.291909 / 4.147977 mm²** excluding SRAM. TT listed-state leakage including
SRAM falls to **8.603006–11.223379 / 10.293397–13.952939 µW**. Portable periodic
RTL totals become **6,000 BD / 6,001 Click**, excluding the unchanged SDA-edge
bit; enabled-policy physical SoC exports contain ten more bits each. Native
storage, delay chains, SRAMs and public ports are unchanged. Fresh activity
matches all 27 baseline windows per variant, including 3,256 / 3,161 firmware
work-clock edges and 43 retired instructions. These results do not update P&R,
qualify the direct capture paths or measure reachable standby/wake energy.

The digitally verified [R3b native-frame-routing comparison](gf180-matched-comparison.md#r3b-native-frame-routing)
uses the same mapper/library inputs as R3. Logic area changes **−0.05977% BD /
+0.02656% Click**, to **3.351460 / 4.207351 mm²** excluding SRAM. Both variants
remove four periodic-clock storage bits; Click adds two native route bits. TT
listed-state leakage including SRAM is **8.760285–11.451153 /
10.452129–14.179303 µW**. Each front/work storage clock load falls 0.006692 pF.
Compiled portable periodic totals are **6,538 BD / 6,539 Click**; enabled-policy
physical SoC exports contain ten more bits each, excluding the chip wrapper.
No payload bank or timing exemption is added. Fresh activity matches R3 in all
27 windows per variant: firmware wakes use 3,256 / 3,161 work-clock edges and
retire 43 instructions, with unchanged measured durations. Affected functional and
strict checks pass; independent review receipts bind the evidence. These measurements exclude
loader transfer latency and do not establish physical timing or power/energy savings.
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
