BiscutLabs/RISCay-MCU/docs/images/bd-layout-2530x2530.png

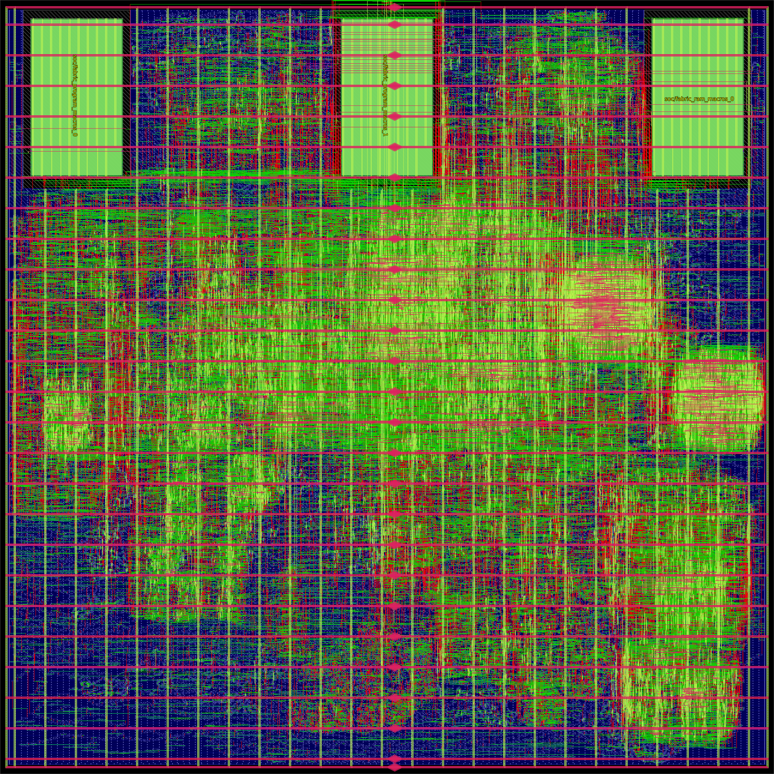
docs/images/bd-layout-2530x2530.png
