BiscutLabs/RISCay-MCU/docs/images/bd-layout-3930x2530.png

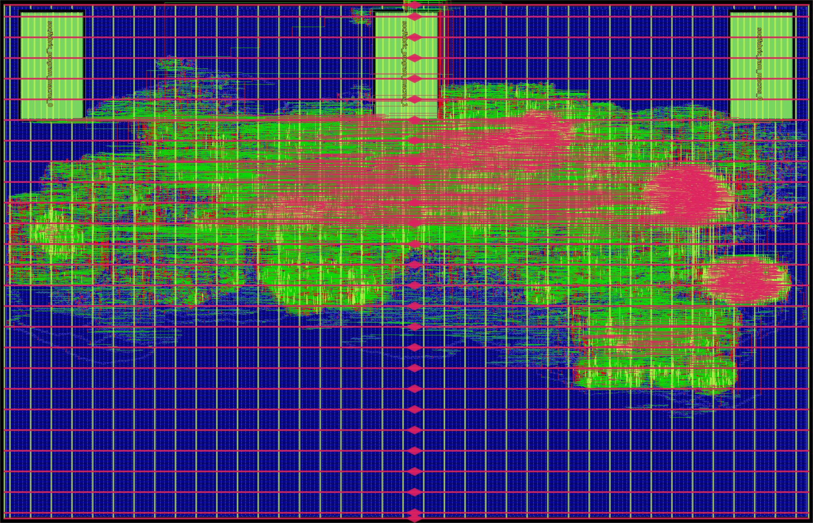
docs/images/bd-layout-3930x2530.png
