BiscutLabs/RISCay-MCU/docs/history/migration-log.md

# Migration log (historical)

Archived from `1376557` on 2026-10-18. The [open checklist](../async-soc-migration.md)
is the current work plan; [build and test](../build-and-test.md) is the current
verification entry point.

The entries below preserve items 1–9, completed sub-item narratives, their
surrounding historical plans, and the original scope/handshake contracts.
Checkboxes, counts, commands and timing assumptions describe their original
revision, not present qualification. Some linked evidence sections and tools have
since been retired. The fixed application supervisor was removed by the generic
MCU correction; its historical contracts must not be implemented again. BD is now
the tape-out target and Click is a frozen functional reference.

The obsolete C3 supervisor task, probe-hook/mapper-sweep plans and superseded
post-PR10 work order are omitted. Their source history remains in Git. The
completed area-batch narrative is retained at the end.

## Ownership and invariants

- Four-phase bundled-data implementation: `designs/four-phase-bd/src/main/scala/riscay/bd/`.
- Native two-phase Click implementation: `designs/two-phase-click/src/main/scala/riscay/click/`.
- Each owns its Fabric, Completion, Admission, RAM/program sources, Control, Telemetry, Housekeeping, SRAM sequencing, I2C and SPI ADC protocol,
  Services, Platform, ClockedPeripherals, ConstantScaling,
  I2cTarget, SleepTiming and SramBank code. Copying the former service island into
  these directories establishes ownership; it does not migrate its state machines.
- Share port schemas, parameter/ISA definitions, fixed macro models and verification
  utilities. Keep protocol controllers separate; Click must not use hidden RTZ adapters.
- Preserve the host/firmware ABI, programming lock, validated image, accepted SRAM
  effects and retention, retained sleep and application-reset isolation. Application
  behavior belongs to uploaded firmware, not silicon. Keep an independent timebase/watchdog even as
  service-clock work is removed. Never relax tests to accept implementation bugs.

## Corrective gates from the independent reviews

The area proposal against `c71b234` is tracked in the
[native area reduction plan](../native-area-reduction.md). Begin with C1g, then
ABI-preserving elapsed arithmetic and CRC reduction. LF width reduction needs
a publication-latency/overflow proof. Self-timed SRAM macro clocks are authorized
for implementation only after the macro timing and reset/pulse gates in A4;
the existing service-clock implementation remains current until qualified.
Then address native I2C storage, residual widths/copies, guards and data-delay
mapping. Proposal estimates remain hypotheses; record matched costs at every
accepted step. C1g and A1 are digitally verified. After A1a removes unused native
context, A1b replaces unrolled elapsed arithmetic with a bounded native loop,
reducing mapped logic area a further 5.5516% BD / 5.4050% Click. Periodic state
is unchanged; each matched wake loses one fast/work edge. Whole-transform
physical timing still fails its existing allowance. See the plan for exact
evidence and qualification limits.

A5b now retains received I2C bytes in one native addressed scratch bank instead
of carrying them through every protocol-state/update token. It removes 513
native payload bits per variant without changing periodic storage or measured
wake activity. The [receive-byte contract](../native-i2c-byte-store-contract.md)
records its passing digital checks, exact mapped cost and open physical
gates. Publication/bank copies, sampled readWord, reset epochs and clocked
dispatch are separate unfinished items.

A2b narrows retained native loader metadata while preserving full-width
host validation and the public ABI. Its acceptance is **digitally verified; matched cost recorded; physical timing open**;
the [area checklist](../native-area-reduction.md#a2b-capacity-sized-loader-metadata)
records the exact capacity, strict, cost and physical-screen scope. The
2026-10-15 pause and incomplete strict attempt remain historical evidence.
At that point the request authorized finishing only the WIP PR, and broader
migration was paused. Later work superseded that pause; the prior incomplete
attempt remains historical evidence. Use the [open checklist](../async-soc-migration.md)
for the current work order.

The subsequent user instruction on 2026-10-13 authorizes correcting the
clocked coordination around native services and adapting timing analysis to
their actual protocols. This supersedes the R4 migration freeze as a work
priority; the measured cost regression remains evidence. Use native ownership
and completion, remove duplicate payload storage, and measure each correction.
Synchronous-tool limitations do not authorize masking real timing failures or
adding periodic-clock stages to a native path. R3 completion is digitally verified;
R2b and complete physical frame capture/return qualification remain open.

The first correction is **C1: direct capture of retained native service
replies**, tracked below. Subsequent steps must remove complete redundant
crossings/owners; C1 alone does not remove the clocked service shell.

The review of `2e4169c` changes the order: **R4 matched comparison first,
then R2b reset distribution; R3/R5 only for service blocks retained by the
comparison decision.** R4 is complete. The [matched comparison](../gf180-matched-comparison.md) of `8637099`
and `2e4169c` favors the smaller clocked island with the same supported core
timing, mapper, SRAMs, enabled board policy, wake workload and physical settings.
Retain both native CPUs and reconstruct expensive services while preserving all
later correctness fixes; never restore the old raw-reset crossings. Any revised
service architecture must be measured again. Independent timekeeping and permanent
supervision remain mandatory. The benchmark preparation and reviewed evidence
live under `build/matched-service-comparison/`; cost comparison is complete,
physical timing qualification is not.

The user supplied a code-only review on 2026-10-12. Its environment could not run
the dependencies, so its findings require local reproduction and independent
verification. Complete the already-started supported-export prerequisite (17a2a),
then resolve the following gates before further clocked-state removal. Earlier
digital passes remain evidence of their tested scope, not RDC or physical proof.

- [x] **R1. Close reset-domain crossings — digitally verified.** Inventory
  raw-reset state and native levels reaching POR-owned clocked acceptance,
  reservation, commit/cancel and payload state. Include request bridges,
  application projections, return fences, recovery debt and retained role levels.
  Synchronize or isolate each crossing with an explicit stability/handshake
  contract. Delaying a bridge reset alone is insufficient if its native source
  drops phase or payload immediately. Preserve accepted effects and prevent old
  requests from acquiring new-lifetime credit. Add structural rejection controls
  and adversarial reset/capture tests; simulation cannot prove metastability safe.
  The [reset-boundary contract](../application-reset-boundary.md) retains
  native producers until actual clocked closure acknowledgments, then rebases
  POR-owned bridge history while payload stays held. Publication clients use
  clocked reservation/recovery mirrors. A graph audit additionally found and
  removed BD's raw word-ACK input to RAM/program admission. The affected cohort
  passes 509 verification cases in 38 suites, four physical-emitter/core-policy
  tests, 402 Python tests and all four portable/inline strict exports. Fresh
  review fixes and exact source/probe/binary/log receipts are preserved with
  original failures under `build/async-reset-domain-migration/`. The change adds
  forty periodic-clocked bits per variant. This closes digital containment only;
  physical CDC, related-clock timing and reset propagation remain unqualified.
  - [x] Remove unused raw-reset return fences and move the test-only RAM/program
    reset-debt observers into fixtures, preserving their diagnostic oracles (C1c).
- [ ] **R2. Reset intervals and complete physical recovery bounds.**
  - [x] **R2a. Extend assertion and release intervals — digitally verified.**
    Retain the eight-edge raw qualifier and unchanged 250 ns supported digital
    timing-policy cap. A reused six-bit counter separately requires 64 native
    assertion edges and 64 post-release isolation edges, plus actual receiving
    rebase/withdrawal acknowledgments. Each interval is conservatively at least
    3.15 us at 20 MHz, over twice the rounded measured local 1.55 us guard bound.
    The change adds three periodic bits per variant and preserves all 34 public
    ports. V3 export metadata explicitly records this limited scope. Fresh
    review, 431 affected verification cases in 34 suites,
    four physical-emitter/core-policy cases, 402 Python tests, 92 coordinator
    and 12 service-projection actual-RTL controls and all four strict exports
    pass. Original short pulses and behavioral oracles remain intact; service
    projections are tested at the
    coherent cutoff with pre-cutoff retention checked separately. Setup failures,
    stale diagnostic expectations and a host timeout are retained with their
    diagnosis/reruns under `build/async-reset-hold-migration/`.
  - [ ] **R2b. Qualify the complete physical reset/recovery envelope (17a3).**
    Repair reset fanout/slew with a protected-net-aware buffered distribution
    tree before measuring assertion and release; the first run's small inverter
    and excessive slew are not acceptable physical implementation.
    Include the generated `~porReleased` distribution: R4 found a 3,300-load
    Click net with modeled reset slew far outside Liberty's table range.
    Repairing only the external reset port would miss this tree.
    Include upstream logic, reset-tree wiring, recovery/removal, every native
    controller and later core-reset removal/startup. Local guard margin and an
    acknowledgment withdrawal edge do not establish this complete bound. Use
    proved completion or measured bounds with margin; increase/rework intervals
    if full-path evidence requires it. R2a does not authorize physical use.
- [x] **R3. Remove the unacknowledged frame-copy timing race — digitally verified, 2026-10-13.** Original receipt
  acceptance could precede physical bank copy completion. Use a native join of
  original receipt and bank-copy completion, with safe route/payload retention
  through BD RTZ and independent Click phase ownership. Explicitly revise the
  old no-wait-for-copy contract if required. Keep exactly two logical credits,
  original-offer overflow observability and immutable reset/busy admission
  context; delaying ACK must not conceal a third offer or resample its context.
  Retain the selected bank tag until copy completion, including a Click capture
  later than original admission/tail advance; an ACK join alone is insufficient
  if the copy can observe the next slot. Cover both copy-first and receipt-first
  orders and complete return before reuse.
  Exercise copies slower than two service periods, stalls, identical payloads,
  reset and all bank wraps with independent offer/capture/dispatch ordinals.
  The original R3 implementation at `a3f11af` kept the request receipt and observed
  its eligible offer O_f independently of A. Two POR copy-ACK synchronizers
  gate actual A/tail advance. Publisher ACK uses a native C-element join of
  copy and receipt; BD also includes synchronized copy ACK so RTZ cannot finish
  before the old high observation clears. Click compares synchronized copy
  phase against the clocked receipt phase, without a four-phase adapter.
  Two POR descriptor-context bits accumulate original-offer reset/busy evidence
  through delayed A and clear only at accepted enqueue. Full Q still faults on
  the original offer, including same-edge D. This adds four periodic-clock bits
  per variant and no payload bank. Existing identity/capture checks remain.
  Final evidence covers 262 distinct passing Scala cases across 28 suites,
  including both core/reference implementations, firmware, reset and sleep;
  457 Python tests plus the final ten-case integration-helper rerun; and all
  four portable/physical strict exports. The 312 capture and 20 wake controls,
  2,880 receipt mutations and 3,868 integration mutations pass, with exact-site
  negative controls and immutable export provenance. Fresh independent review
  checked RTL, context/rearm mutants, costs, activity and evidence hashes.
  Matched logic area increases 0.04833% BD / 0.00423% Click versus C1; all 27
  measured wake windows per variant retain their work counts and durations.
  Preserve initial failed runs, including twelve obsolete ready-identity checks
  and the 240-second BD host timeout. The unchanged binary passed in 251 seconds;
  its fresh rerun passes with a 600-second host allowance and the same simulated
  deadline and behavioral assertions. See `build/async-frame-completion-repair/`
  and [frame verification](../frame-admission-contract.md#r3-final-verification).
  This closes the unacknowledged-copy race in the digital contract. The service
  scheduler and complete physical bank/capture/return timing remain open.
- [x] **R3b. Move frame-bank route ownership fully into each native store — digitally verified, 2026-10-13.**
  The review of `a3f11af` identifies clocked `frameSlot` as the avoidable native
  copy dependency. BD reuses its two-bit route register, seeded to three and
  incremented at each original offer. Click adds a two-bit native route register,
  seeded to zero and incremented on the common capture pulse. Include increment
  feedback in each full data aperture. Click capture uses a public asymmetric
  C-element: selected-bank availability permits assertion, while pending alone
  controls return. A combinational AND could retrigger when route/phase feedback
  changes before pending falls; verify opposing route/accepted delays explicitly.
  Restore original clocked acceptance A and direct descriptor reset/busy capture.
  Remove the two copy synchronizers, two sticky offered-context bits and offered
  port per variant. Join raw copy and receipt ACK only, retaining publisher data
  through both acknowledgments. Keep the independent two-bit clocked descriptor
  ordinal: A may precede native copy, so substituting live native route at A
  would recreate the crossing. Verify original O, actual copy, A and D ordinals,
  full-Q rejection including same-edge D, identical payloads, all bank wraps,
  POR and application reset. D must wait for a valid completed head. Prove late
  copy completes after A with both front/work clocks stopped. The original
  receipt still requires clocked acceptance and BD return; only the redundant
  synchronized-copy round trip is removed. Final verification passes 275 distinct
  Scala cases across 29 suites, 463 Python tests and all four strict exports.
  Actual-RTL campaigns pass 172 positive/86 negative store simulations,
  292 positive/52 negative composed capture simulations, 16 positive/four negative
  wake simulations, 6,368 store/2,880 receipt/3,762 integration mutations.
  Fresh independent review covers RTL, exact fault sites, input/binary hashes,
  state/ABI, mapped cost and activity. Four periodic bits are removed per variant;
  Click adds two native route bits. Mapped logic changes −0.05977% BD / +0.02656%
  Click; all 27 wake windows per variant retain their counts and durations.
  Evidence: `build/async-frame-native-route-repair/final-evidence-r1.json` and
  [R3b verification](../frame-admission-contract.md#r3b-verification-and-cost-evidence).
  Preserve initial fixture, stale-expectation and host-timeout failures. Both
  original timed-out strict binaries independently pass unchanged with the
  existing 3,600-second host allowance; simulated deadlines and coverage remain
  unchanged. R3's earlier evidence remains historical. Physical capture/reset
  qualification, clocked service scheduling and energy measurement remain open.
- [x] **C1. Remove duplicate clocked service-reply payload banks — digitally verified, 2026-10-13.** Both native
  variants already retain Control, Telemetry, Housekeeping and Supervisor replies
  through acceptance. Keep their receivers' existing synchronizers, control FSM,
  settling interval and ACK cadence while capturing payload directly in the
  existing consumer on `reply.fire`. Add no native payload copy or guard.
  Keep POR ownership and verify stalled replies, stopped clocks, both Click
  phases, BD RTZ, application recovery and exactly-once effects. Strict probes
  must drive exact native producer storage, never a derived bus. Measure the
  actual state/ABI delta, run affected regressions and strict exports, obtain
  fresh review, and keep producer-to-consumer physical setup/hold open until
  qualified. See [service-reply capture](../service-reply-capture-contract.md).
  Independent compiled inventories prove exactly 1,254 fewer clocked payload
  bits per variant, identical native/macro state and public ABI. Matched logic
  area falls 4.02% BD / 3.21% Click; firmware wake work remains 3,256 / 3,161
  edges. Core/reference, service/reset/sleep/firmware and physical-policy checks,
  452 Python controls and all four strict exports pass after the documented
  test corrections. Keep the original failed runs: a Click test selected an
  idle high phase, and two long BD simulations hit the 90-second host allowance.
  Actual pending-phase checks now cover both directions; exact unchanged binaries
  prove the runtime diagnoses, with all RTL deadlines and oracles preserved.
  Fresh independent review and hash-bound evidence are retained under
  `build/async-service-publication-repair/`. This item removes payload copies;
  the service scheduler, physical capture timing and R2b remain open. R3 is
  separately verified above.
- [x] **C1b. Remove duplicate peripheral and SRAM receiver payload banks — digitally verified, 2026-10-13.**
  Audit found no ordinary clocked storage inside the native controller bodies.
  Remove 538 duplicate periodic-clock payload bits per Groundlark variant:
  elapsed result 159, ADC result/token 35, I2C snapshot token 8, eight SRAM byte
  requests 336. Reuse each design's existing direct held-bus receipt without
  changing synchronizers, settling or ACK cadence. Preserve real macro input
  capture and falling-edge launch. Extend structural RDC proof through the
  actual saved byte, compiled native-state inventory and mutation controls.
  Standalone scaling/SRAM wrappers receive equivalent fixes but are excluded
  from the production count. Require regression, strict export, cost/activity
  evidence and independent review before completion. See the
  [capture contract](../held-peripheral-capture-contract.md). Evidence root:
  `build/async-held-boundary-cleanup/`; baseline `2676845`.
  The full verification suite passes 660 tests and physical-policy checks pass
  four tests; the focused run passes 68 overlapping tests. All 468 Python tests,
  four complete strict exports, 252 structural fault controls and 24 compiled
  exact-fatal wiring mutations pass, with a positive wiring baseline per variant.
  Fresh independent review addresses capture-monitor, clock-proof, primitive
  inventory and executed-binary provenance gaps. Final compiled periodic totals
  are 6,000 BD / 6,001 Click. Matched logic area falls 1.78% / 1.41%; all 27 wake
  windows per variant are unchanged. Keep initial checker/catalogue/provenance
  failures and interrupted runs. The final evidence index binds passing runs and
  review to the final sources; physical capture timing and native service
  scheduling remain open.
- [x] **C1c. Remove test-only Platform reset diagnostics — verified, 2026-10-13.** Move raw-reset
  `ramResetDebt`/`programResetDebt` mirrors and unused return-fence expressions
  into verification fixtures, preserving fault controls. Expect source clarity,
  not mapped savings: these have no production consumers. Both variants now
  keep the observers in RAM/program/publication fixtures; RecoveryOwnership
  inherits the publication observers. The 52 affected tests and 468 Python tests
  pass. Six positive and six exact-fatal observer controls pass. The old RAM
  early-release mutant exposed a 12-edge test window shorter than the current
  reset sequence; extending the unchanged assertions to 200 edges detects it.
  All 11 RAM tests pass again after this strengthening. Four fresh production
  exports have identical preprocessed default/synthesis/recorded-strict inputs
  and identical contract fields except derived RTL hashes from unused random
  initialization indices. Prior strict evidence is reused under those exact
  flags; it is not a newly executed strict run. State totals and mapped logic
  remain unchanged. Fresh independent review and evidence, including failed
  compile/control attempts, are retained in `build/async-platform-diagnostic-cleanup/`.
  See the [reset contract](../application-reset-boundary.md#verification-only-observers-c1c).
- [x] **C1d. Compact the fixed SPI waveform player.** Digitally verified:
  replace its 96 recipe shift bits with a five-bit slot and active bit, preserving
  all 32 samples, exact half-phases, first-frame discard, immutable source recipe
  and full drain. See the [player contract](../spi-player-contract.md). Verification
  passes 167 Scala tests, 519 Python controls, four strict exports and four
  actual-wiring baselines with 30 exact-fatal mutations. Matched logic falls
  0.2730% BD / 0.3012% Click; all 27 wake windows per variant are unchanged.
  Fresh independent review and source/evidence inventories are recorded in
  `build/async-spi-recipe-reduction/review-final-r1.json` and `final-evidence-r1.json`.
  The physical pin boundary remains clocked. Selected local setup/hold passes;
  slew, capacitance and complete physical qualification remain open.
- [x] **C1e1. Remove the quiescing CPU request payload copy.** The implemented
  receiver uses the native 70-bit address-stage payload with zero outside valid.
  Preserve R1 close/closed/rebase/withdrawal, both synchronizers, settling/ACK
  cadence, BD return and Click phase history. Actual work-clock capture qualifies
  service-clock ACK; background consumers must see the invalid zero mask.
  Regression, exact source/mask/gate/RDC controls and strict exports pass.
  Both variants lose 70 periodic bits; native state is unchanged. Matched logic
  area falls 0.2404% BD / 0.2999% Click and all 27 ordinal wake windows are
  unchanged. Evidence and independent review are in the
  [request-receipt contract](../application-reset-boundary.md#c1e1-retained-cpu-request-receipt).
  Native source aperture, minimum mask-removal hold and physical reset/clock/RC
  bounds remain open; this does not complete all C1e or minimum boundary state.
- [ ] **C1e2. Remove the six smaller grant/drain payload copies.** The accepted
  C1f maps retain all ten bits: seven have no functional mapped consumer and
  three carry program/publication roles. No C1e2 implementation is applied.
  Preserve all POR-owned reservations, real work-clock acceptance, assertion
  identities, independent grant/drain retirement and BD/Click histories.
  Require separate stopped-clock/reset, actual-wiring, state and cost evidence.
- [x] **C1f. Narrow internal SRAM saved addresses.** Both controllers retain only
  configured address bits under the upstream valid-offset contract, with full
  32-bit firing-lane assertions retained for verification. No range-rejection
  hardware is added at the byte controller.
  Groundlark removes 43 periodic RTL bits per variant; native state, macro
  topology, public schema, falling launch and full-cycle capture are preserved.
  Twelve fresh fixtures cover one-word, non-power-of-two and production sizes;
  1,304 exact negative controls bind all 48 production assertion sites. Regression,
  strict and actual held wiring evidence and whole mapped cost/activity are in
  the [SRAM contract](../sram-integration.md#c1f-saved-address-narrowing). Five-corner
  controller timing retains all violations and missing checks; physical source
  aperture, clock/reset distribution, route RC, macro qualification and A7 stay open.
- [x] **C1g. Make I2C snapshot consumer-clock acceptance explicit.** Both
  receipts qualify acceptance with the actual work-clock gate; no storage or
  handshake stage is added. SnapshotWakeSpec covers reads from real sleep,
  source stopping on/off, 3.2/8/20 MHz, maximum native delays and deliberately
  stopped consumers. A real SELECT changes the second snapshot; ACK must
  coincide with actual capture. All 26 strengthened cases and two positive/
  four exact-fatal controls pass. Full verification/physical checks total 690
  distinct tests; Python controls total 468. Four strict exports and 1,890
  portable/1,884 physical structural controls pass. Matched native/periodic
  state, guard cells and all 27 wake windows per variant are unchanged; mapped
  logic changes +0.0293% BD/+0.0470% Click. This hardens an implicit invariant,
  not a demonstrated production loss. See the
  [capture contract](../held-peripheral-capture-contract.md#snapshot-consumer-clock-c1g)
  and `build/async-snapshot-clock-qualification/final-evidence-r1.json`.
- [x] **C2. Narrow native loader CRC feedback (A2a, digitally verified).**
  The selected implementation replaces four 337-bit stores with one 32-bit
  whole-word CRC stage. The existing update stage retains context, with explicit
  native request/return rendezvous delaying its acknowledgment through state
  capture and CRC ingress return. This ownership change is necessary: borrowing
  BD's update latch after its old ACK would permit premature reopening. The
  measured candidate comparison favors this over both a wide whole-word stage
  and narrow byte feedback. All 230 ScalaTest and 500 Python cases pass, with
  four strict SoC exports and 27 original/27 exact-fatal rendezvous controls.
  Logic area falls 4.10% BD / 4.27% Click; periodic storage and all 27 matched
  wake windows per variant are unchanged. Physical timing remains open. Preserve
  independent branch stalls, immediate source reuse, actual capture/POR checks
  and Stored-only accounting. See [the CRC contract](../native-crc-contract.md).
- [x] **R4. Matched baseline/current comparison — complete for architecture
  decision, 2026-10-13.** The [matched report](../gf180-matched-comparison.md) uses
  identical core timing, SRAMs, mapper, enabled-policy workload and feasible
  common-outline P&R settings. Mapped logic grows 6.06× BD / 7.31× Click;
  placed cells plus SRAM grow from 1.058/1.080 to 4.025/4.881 mm². Firmware work
  edges per wake grow from 866 each to 3,256/3,161, with exactly 43 retired
  instructions in every window. Reports account for actual guards, native
  storage, bridges, five-corner listed-state leakage and storage clock loads;
  these do not amount
  to measured energy or reachable-state standby leakage. Independent review
  reproduced mapping/activity and verified all four corrected routes, three RC
  extractions each, 60 clocked corner reports and 257,148 local measurements.
  Full TT/nom local probes have zero uncovered groups but retain 395 BD / 47
  Click violation groups; selected FF/min and SS/max probes retain the BD
  violation. Constant/reset-only groups are not timing passes. All 428 Python
  tests, four physical-policy cases and 17 independent collector controls pass.
  Preserve original failures and signed out-of-range Liberty diagnostics.
  This result froze further migration before the later C1 corrective direction;
  retain both native CPUs and all later correctness fixes. These
  results establish common-outline cost, not minimum die size or timing closure.
- [ ] **R5. Replace avoidable guard delays and epoch state.** Inventory the
  200–241 ns guard/cleanup owners and their actual area, leakage and critical
  paths. Prefer native completion where it proves the same ordering/reset
  invariant. Evaluate per-descriptor stale history against the entire O-to-D
  reset window, including resets before admission and repeated episodes, before
  replacing the 64-bit epochs. Do not trade a race for a smaller register count.
- [ ] **R6. Repair public primitive use and maintenance surfaces.** Replace the
  private frame-route AND bindings with supported public primitives, preserving
  atomic semantics, metadata and timing controls. Condense README status and
  keep detailed migration evidence here. Keep separate design implementations
  as originally requested; use shared verification to detect asymmetric fixes.

Each correction requires the same fresh review, fixes, verification, documentation
and separate commit/push loop. R4 remains the measured cost baseline for rework.
R1/R2 safety must survive any architectural rework. Complete
physical reset qualification (R2b) remains mandatory under item 17a3.

## Items

- [x] **1. SocFabric routing - digitally verified, 2026-10-08.** Native request/response routing,
  clockless ROM/static faults, endpoint backpressure/return sequencing, coordinated
  reset and retained payloads. Keep stateful MMIO/SRAM behind explicit endpoint
  bridges. Expand focused and independent-service tests for both implementations;
  rerun affected SoC/sleep/firmware/SRAM, core/reference and Python controls and
  strict exports. Update contracts and evidence, then commit and push.
- [x] **2. MMIO and loader state - digitally verified, 2026-10-08.**
  Move state/serialization and validated-image
  accounting into each protocol; preserve full-width validation, atomic acceptance,
  upload arbitration, reset isolation and the POR-only programming lock.
  Implementation and fresh independent review fixes pass the final 107-case
  verification run, two core physical-policy tests, Python controls and both
  strict exports. See the exact scope below and the linked evidence.
- [x] **3. GPIO, events and telemetry - digitally verified, 2026-10-08.** Separate
  native state loops preserve board ownership, coherent snapshots, set-wins events,
  deadline replacement, retained samples and WAIT/lease behavior. Fresh independent
  review fixes, 121 verification cases, two core physical-policy cases, 69 Python
  controls and both strict exports pass. Exact clocked boundaries remain below.
- [x] **4. Scaling and CRC — digitally verified, 2026-10-09.** Independent native
  elapsed/sample pipelines and CRC feedback stages preserve fractional time,
  wrap/catch-up and image integrity. Fresh independent review fixes, all 145
  verification cases, two core physical-policy cases, 70 working-tree Python
  controls and both strict exports pass. Exact boundaries and evidence are below.
- [x] **5. Permanent supervisor — digitally verified, 2026-10-09.** Separate native
  state and safety-sample loops preserve firmware-independent Pi bootstrap and
  watchdog isolation, with disabled-by-default production policy. Fresh review
  fixes, 161 verification cases, two core policy cases, 71 working-tree Python
  controls and both strict exports pass. Scope and timing limits are below.
- [x] **6. SRAM access sequencing — digitally verified, 2026-10-09.** Separate
  native word ownership, byte sequencing and read assembly surround explicit
  synchronous GF180 macro crossings. No local clock generator is introduced.
  Fresh independent review, all 169 verification cases, two core policy cases,
  74 working-tree Python controls and both strict SoC exports pass. Scope,
  retained failure evidence and physical limits are documented below.
- [x] **7. I2C - digitally verified, 2026-10-09.** Separate native protocol
  loops preserve wire behavior, coherent reads, reset isolation, address-only wake
  and stuck/foreign-bus release. Fresh review fixes, 190 verification outcomes,
  two core policy cases, 80 Python controls, thirteen actual wiring mutation
  controls and both strict SoC exports pass. Scope and physical limits are below.
- [x] **8. SPI ADC - digitally verified, 2026-10-10.** Separate native conversion,
  assembly, priming and scaling loops preserve exact wire timing, cadence,
  reconfiguration, freshness and supervision independent of CPU progress. Fresh
  review fixes, 206 verification cases, two core policy cases, 83 Python controls,
  22 actual RTL mutation controls and both strict SoC exports pass. Clocked wire
  playback and full-frame capture remain explicit boundaries below; item 9 owns cadence.
- [x] **9. Slow-domain housekeeping - digitally verified, 2026-10-10.** Separate
  native time/deadline/lease/wake-mask, kick policy and low-power cadence loops retain
  independent LF/watchdog, observation/freshness ingress, Gray CDC and safe gating.
  Fresh review fixes, all 227 verification cases across 28 suites, both core policy
  cases, 84 Python controls and both strict exports pass. Exact boundaries are below.
- [ ] **10. Native completion and CPU coordination.**
  - [x] **10a. Native response storage and selected completion assembly — digitally verified, 2026-10-10.**
    Replace clocked response retention and Telemetry/Housekeeping completion
    joining, and connect the production response directly to native Fabric.
    Keep current admission and per-source cancellation ownership explicit.
    Fresh independent review fixes, all 235 verification cases, both core policy
    cases, 87 Python controls and both strict SoC exports pass. Original probes
    reject 22 actual RTL mutations; 27 contract and six dynamic-binding mutations
    also fail as required. Public ports remain identical to item 9.
  - [ ] **10b. Native transaction ownership and admission context.** Remove the
    remaining clocked CPU occupancy/source-pending state and whole-word response
    round trips. Preserve accepted persistent effects through watchdog reset,
    stale-response cancellation, boot/WAIT behavior and retained sleep.
    - [x] **10b1. Native admission credit — digitally verified, 2026-10-10.** Separate BD/Click credit owners
      must preserve endpoint acceptance and offered-request event visibility,
      and release occupancy from retained native completion retirement. A native
      grant with an explicit clocked-client crossing avoids moving the MMIO
      clear-protection window. Consume the grant at the existing commit edge;
      prevent stale credit through full return. Local replies cannot create
      service credit; HALT consumes credit until reset. Keep an unaccepted parked
      WAIT eligible for sleep and unused credit from retaining clock demand.
      Separate `FourPhaseAdmission`/`ClickAdmission` implementations pass fresh
      independent review, all 253 verification cases, both core policy cases,
      90 working-tree Python controls and both strict SoC exports. The unchanged
      oracles reject 32 actual RTL mutations, 55 contract mutations and six
      dynamic-binding substitutions. Evidence: `build/async-admission-migration/`.
    - [ ] **10b2. Persistent source ownership and cancellation.** Define retained
      operation identity, publication-before-completion and recovery debt before
      removing source-pending bits or SRAM word crossings. Repeated watchdog
      resets cannot alias an old operation into a new CPU lifetime. POR-owned
      effects must finish exactly once while cancelled CPU replies stay cancelled.
      - [x] **10b2a. RAM source slot and cancellation fence - digitally verified, 2026-10-10.** Allocate ownership
        no later than CPU acceptance; cancel reply eligibility without resetting
        accepted POR effects. Include queued commands in the reuse fence. Preserve
        the existing whole-word publication crossing for this first substep.
        Reserve the native slot before permitting clocked CPU acceptance. A
        separate accepted/cancelled receipt settles an uncommitted reservation;
        a committed reservation retains the slot through publication and full
        return. Record every raw reset pulse asynchronously, including a second
        pulse during recovery, and drain queued reservations before releasing
        reset debt. Keep the release sequencer under that same asynchronous reset.
        Do not arm eligibility on late arrival of the existing word command.
        A Decoupled `fire` level is not a commit clock; an unqualified generated
        strobe cannot replace this reservation protocol. Clocked drain projection
        and `SramAccess.active` remain explicit boundaries in this substep.
        The implementation has separate native owners and four POR crossings.
        Focused short-pulse tests exposed Click completion-phase replay during
        reset release; that substep added an eight-edge qualifier
        on the ungated service clock. Its original 350 ns/250 ns settlement
        interpretation is superseded by R1/R2a: the qualifier remains, while
        coordinated reset and separate 64-edge assertion/release intervals
        control native restart. Complete physical reset timing remains open.
        At that substep, review fixes, all 276 verification cases, both core policy cases, 96 Python
        controls and both strict exports pass. Unchanged oracles reject 55 actual
        RTL mutations, 191 metadata mutations and six dynamic-binding changes.
        Coverage includes the full timing policy, emitted reset distribution,
        early publication/return, repeated pulses and actual macro write counts.
        Evidence: `build/async-ram-source-migration/qualification-evidence.json`.
      - [x] **10b2b. Program-memory CPU/loader ownership - digitally verified, 2026-10-10.** Preserve exactly-once
        `Stored` accounting and loader priority through cancellation and recovery.
        Reserve a native slot tagged CPU read or loader write before word
        acceptance. If higher-priority Control work arrives before CPU commit,
        cancel the uncommitted reservation and retry without consuming admission.
        Retain loader obligations through application reset and backpressure a
        loader reply until grant/word/commit acceptance agree. Replace clocked
        CPU-pending and `Stored`-pending ownership; keep `ControlState.loaderPending`,
        which already belongs to the native accounting token. Retain `Stored`
        delivery until its Control command is accepted and the full return drains.
        Click needs independent `Stored` phase history across CPU-only operations.
        Only committed loader slots wait for Stored; CPU commits/cancellations
        bypass that phase. Loader reservation, grant, publication and accounting
        must progress through application reset debt. Accept actual word
        publication before waiting for word drainage; retain admission-time busy
        history through the Stored command/reply gap. Cover independent phase
        histories and directed selector skew with newly derived timing bounds.
        Separate owners now remove Services' `cpuMemoryPending` and
        `completionPending`. Five POR crossings, clocked drain/debt projection
        and the SRAM whole-word round trip remain explicit. Fresh independent
        review fixes, all 309 verification cases, both core policy cases, 105
        Python controls and both strict exports pass. Original functional
        oracles reject 50 actual RTL defects, 218 metadata mutations and six
        dynamic-binding changes. Custom Click register pin checks pass 127
        positive replays and reject ten timing defects (included in the 50).
        Earliest on-wire I2C status exposed a redundant Stored capture stage;
        a specialized two-synchronizer receipt crossing fixes it without
        changing the timing/status oracle. Evidence and retained failures:
        `build/async-program-source-migration/qualification-evidence.json`.
      - [ ] **10b2c. Publication receipts and recovery debt.** Move Telemetry and
        Housekeeping CPU eligibility only with their publication acknowledgments;
        repeated resets cannot let an old recovery clear newly incurred debt.
        - [x] **10b2c1. CPU eligibility and exclusive publication receipts — digitally verified, 2026-10-10.**
          Reserve before CPU acceptance, including both sources for deadline
          writes. Cancel uncommitted grants without consuming admission; keep
          offered-request event history visible during stalls. Do not let a
          reservation block its own commit through the ordinary busy predicate.
          A cancelled Telemetry commit may disappear before dispatch, whereas
          accepted POR-owned Housekeeping actions must still execute and publish.
          Retain an independent reset/full-drain fence until native recovery is
          qualified; remove each clocked CPU-pending bit with its native owner.
          - [x] Retain publication receipts and acknowledge their ingress
            independently of owner retirement. Prove that no captured receipt
            remains in flight before cancellation permits reuse. Keep separate
            Click publication/drain phase histories and complete BD returns.
          - [x] Issue a persistent drain offer for every committed decision,
            including one accepted before application reset. Acknowledgment
            must prove the old dispatch, command, reply and publication paths
            quiet; accumulated observations and undispatched recovery work must
            not prevent that proof or lose their retained history.
          - [x] Hold the validated MMIO Control reply until all required grants
            and decision ingresses can commit together. Leave parked WAITs
            unreserved; separate engine readiness from reservation occupancy.
          - [x] Publish receipts even for cancelled CPU lifetimes. Qualify live
            completion with actual service publication, native eligibility and
            the reset fence. Receipt retirement never advances `consumedGray`.
          - [x] Verify independent crossing stalls, reset during capture and
            return, both deadline arrival orders, skipped phase histories,
            continuous ticks, permanent supervision and immediate source reuse.

          Separate native owners now replace both clocked CPU-pending bits.
          Five POR crossings per source and clocked recovery/debt projection
          remain temporary boundaries. Fresh implementation and qualification
          reviews required actual register-pin timing controls and independent
          Housekeeping publication/drain stalls, in addition to Telemetry cases.
          All 334 verification cases, both core policy cases, 113 Python controls
          and both strict SoC exports pass. Unchanged oracles reject 49 actual RTL
          defects, 857 metadata mutations and six dynamic substitutions.
          Actual Click pin checks pass 130 positive replays, including reset
          overlap in every capture-reset seed/skew case. Evidence and failures:
          `build/async-publication-source-migration/qualification-evidence.json`.
        - [ ] **10b2c2. Fresh recovery attribution and native debt.** An old reset
          reply cannot clear a later raw reset pulse, even when several pulses
          occur before publication. Associate recovery with a retained exclusive
          slot and prove older command/publication/cancellation return before
          reuse. Qualify each projection update with that same identity; keep
          physical reset release and clock-domain observations explicit. Avoid
          a cycle in which debt blocks the recovery dispatch needed to clear it.
          - [x] **10b2c2a. Fresh recovery ownership — digitally verified, 2026-10-10.** Extend the retained source
            role to distinguish CPU work and recovery. Admit a recovery only
            after older accepted effects drain; commit its grant and decision
            with actual reset-command acceptance. A later reset revokes that
            slot's freshness. Require actual attributed publication before
            authorizing application projection or ending recovery. Remove the
            Services reset-needed/recovery flags only with this native owner;
            retain and identify the clocked full-return fence in this substep.
            Fresh review and final digital qualification pass. The new
            native debt and CPU/recovery role reuse the original five crossings.
            Separate command/reply markers identify the recovery reservation;
            Housekeeping `resetApplication` alone is not that identity.
            - [x] Verify repeated raw resets with old recovery replies held,
              revoked queued grants, offered CPU requests, independent source
              return and reset after debt clears but before complete return.
            - [x] Stall reservation ingress while the owner is empty after
              reset: quiet alone must not release the retained return fence.
            - [x] Check the debt register's actual capture pins for every seed
              and skew, including observed reset immediately before/after capture.
            - [x] Reject role, freshness, publication, drain, marker and fence
              defects with unchanged functional oracles. Isolate mutations by
              actual emitted instance even when firtool deduplicates modules.
            - [x] Complete fresh review, full regressions, strict exports,
              preserved ABI/P&R checks, evidence, commit and push.

            All 352 verification cases across 41 suites, two core policy cases,
            43 final focused cases, 137 working-tree Python controls and both
            strict exports pass. The final 34-port ABI matches 10b2c1. Original
            oracles reject 91 actual RTL defects, 989 metadata mutations and six
            dynamic substitutions. Capture checks pass 342 positive replays;
            every reset-overlap fixture meets its coverage obligations. Failed
            probes, surviving mutants and all fixes/rechecks remain recorded in
            `build/async-recovery-ownership-migration/qualification-evidence.json`
            and `failures-and-rechecks.md`. No physical qualification is implied.
          - [x] **10b2c2b. Native full-return debt release — digitally verified, 2026-10-11.** Replace clocked
            debt/previous-safe sequencing only after a native retained proof
            joins fresh recovery publication with complete owner and crossing
            return. If a temporary quiescence receipt is needed at the clocked
            client boundary, count it and schedule its later removal. Never
            use an unqualified combinational strobe or a bare idle observation
            to clear debt. A reset invalidates every older clear obligation.
            - [x] Retain successful recovery identity independently of the
              reopened BD payload latch and independent Click proof phases.
            - [x] Certify original native return before offering a final receipt;
              its consumer checks original bridge/engine drainage without
              waiting on the new receipt or its own owner-idle feedback.
            - [x] Enforce native capacity against an early next request/phase.
              Gate new clocked reserve acceptance without truncating the active
              bridge request; an unaccepted next input cannot block old return.
            - [x] Test repeated reset, offered next payload changes, all original
              return stalls, final receipt stalls and proof cleanup. Qualify
              every new capture/feedback path and reject real proof bypasses.
            - [x] Count temporary receipt synchronizers/ACK storage separately
              from removed policy state, and schedule their removal in item 14.
            Separate `FourPhaseRecoveryReturn`/`ClickRecoveryReturn` controllers
            now retain proof identity, exclude early next admission and release
            debt after original and final return. BD waits for full final RTZ;
            Click uses four independent POR phase registers and no RTZ adapter.
            A 200 ns digital cleanup guard preserves clear pulse/capture before
            reuse. Qualified application reset immediately masks the application
            and revokes eligibility without resetting the POR proof transport.
            Each temporary control-only `ReturnReceipt` contains two request
            synchronizers, an ACK register and two POR-release synchronizers.
            Two receipts add ten clocked bits per variant while four old fence/
            previous-safe bits are removed: **net six additional temporary
            clocked bits**. This transfers policy ownership; it does not finish
            boundary removal. Evidence and retained failures are under
            `build/async-recovery-return-migration/`. Physical qualification and
            the remaining clocked client/bridge removal are still outstanding.
            Qualification covers 365 cases in 43 suites across the retained
            interrupted invocation and its completed-suite continuation, two
            physical-policy cases, 143 Python controls, 11 pinned SRAM assets,
            unchanged 34-port ABIs and both strict SoC exports. Final focused
            reruns pass 63 and 31 cases. Controls reject 181 actual RTL mutations
            (147 simulated mutants and 34 static receipt RTL checks),
            1,845 metadata mutations and six dynamic constant substitutions;
            actual-pin campaigns pass 508 positive replays and all 27/54 prior
            reset-overlap fixtures. Fresh independent reviews and fixes are in
            `build/async-recovery-return-migration/qualification-evidence.json`
            and `review-notes.md`; actual failures and interruptions are retained.
      - [x] **10b2d. Remove whole-word response round trips — digitally verified.** Use the verified
        ownership/isolation contract to connect native completion paths directly
        and remove superseded pending flags and crossings.
        - [x] **10b2d1. Working-RAM native return and presentation isolation.**
          Separate native return owners are connected to working SRAM, source
          publication and an independently selected Completion input in both
          variants. Fresh review, all 415 verification tests across 44 suites,
          two physical-policy tests, 217 Python tests and both strict SoC exports
          pass. Production wiring controls detect all 40 actual RTL faults.
          Evidence: `build/async-ram-return-migration/qualification-evidence.json`.
          Net reduction: 39 clocked RTL bits per variant, with the 34-port ABI
          unchanged. See `docs/ram-return-contract.md`; physical timing remains open.
          Capture the native word and retained slot identity in POR-owned storage;
          acknowledge SRAM independently of publication retirement. Connect its
          payload to a separately selected native Completion input. Application
          reset cancels presentation, not captured memory effects or receive
          phase history. Click needs independent POR receive and application
          transmit phases, with explicit cancellation/return before reuse.
          Do not directly connect SRAM response to source publication: publication
          ACK currently waits for wordDrained, which waits for response return.
          Exclude the retained publication token from the word-drain proof it
          releases. A temporary control-only capture receipt may replace the
          wide reply crossing; count it and retain its item-14 removal obligation.
          Existing RamAccess active/return synchronizers and RAM debt/previous-
          safe policy remain explicit until their own native proof is verified.
          Source occupancy cannot substitute for memoryBusy: it would block the
          reservation's own commit. Distinguish original effect/receipt drainage
          from complete return-owner occupancy; the latter cannot feed the
          publication proof that releases it. Capture per-word reset-sticky
          permission before exposing branches, and retain terminal proof so
          asynchronous reset cannot shorten a POR capture event. BD branches
          require independent request return; Click requires independent receive,
          issue and application phases. Test clock-stopped payload progress, byte/
          publication/presentation stalls, reset throughout capture and return,
          exact macro effects, custom capture pins and actual isolation mutations.
          Represent the mixed-lifetime application output as an explicit reset
          boundary with a closed protocol/reset schema and production bindings;
          the library's single-domain channel metadata cannot express it. Keep
          POR monitors active and add a complete application-reset monitor.
          Click's saved application target resets with permission/output phase;
          POR issue identity must never sample an asynchronously reset phase.
        - [x] **10b2d2. Program/loader native return and Stored attribution — digitally verified, 2026-10-12.**
          Reuse only interface/verification contracts; each design owns its
          implementation. Preserve retained loader/CPU role and separate selected
          program/RAM Completion inputs with immutable plan selection. Loader
          effects must issue exactly one Stored token and never CPU completion.
          ProgramSource.eligible alone denotes the live application lifetime;
          it does not distinguish loader writes from CPU reads. Capture the
          retained native role with presentation permission; never infer role
          from projected loader state or reuse RAM's eligibility-only binding.
          Stored ACK remains Control command acceptance; preserve the subsequent
          busy/reply gap, independent Click Stored history and BD complete return.
          Test alternating banks/roles/cancellations, earliest real I2C status,
          repeated reset with held old replies, and exact received/CRC/write counts.
          Remove the old wide memory ingress only after both banks qualify;
          preserve the Completion return barrier and complete capture aperture.
          This step removes the 39-bit program word reply bridge, eight-bit
          publication bridge and 40-bit Completion memory ingress. Account for
          every replacement receipt, reset and idle synchronizer in the net
          change. Keep the existing five-bit Stored
          receipt until its Control consumer is native; a loader completion must
          remain live while application reset is held.
          Fresh review and qualification pass under
          `build/async-program-return-migration/qualification-evidence.json`: all
          461 verification cases / 45 suites in an explicitly split regression,
          both physical-policy cases, the final strengthened 16-case loader-source
          recheck, 301 Python tests and both strict SoC exports. The original
          interrupted invocation remains recorded as incomplete. Actual program/
          RAM production wiring controls reject all 42/40 faults. The public
          34-port ABI is unchanged; net clocked state falls by 80 bits per variant.
          Physical timing remains open; no maximal-asynchrony claim is made.
          - [x] Connect separate native ProgramReturn/ProgramAccess owners and
            remove all three obsolete crossings from production.
          - [x] Close retained CPU-role permission, independent capture receipt,
            POR publication and application-reset presentation contracts.
          - [x] Preserve original loader/CPU effect oracles; add capture stalls,
            work-clock stops, role/phase alternation and early Stored visibility.
          - [x] Qualify actual capture pins, opposing skew/reset edges and
            production wiring faults against attested strict positive runs.
          - [x] Recount clocked state and public ABI; finish core/reference,
            firmware/sleep, Python and strict-export checks, then fresh review,
            fixes, documentation, commit and push.
        Both steps require closed strict-export bindings, independent references,
        unchanged external ABI, fresh review and updated crossing/state counts.
        Wrappers are temporary implementation choices, not physical necessities.
      Use exclusive retained slots until every older command, publication,
      cancellation and handshake has drained. A wrapping lifetime bit alone is
      insufficient. Test short reset pulses between work-clock edges, repeated
      watchdog episodes with an old reply held, accepted byte-lane effects and
      both native return protocols. Do not join a POR-owned Click sender directly
      to an independently reset application receiver without isolation/recovery.
- [ ] **11. Native service admission and dispatch.** Remove the clocked host
  mailbox, command selection and dispatch ownership in separately reviewable
  substeps. Preserve priority for accepted SRAM/MMIO completion before reset,
  reset history of queued host frames, admission-time busy context, host/CPU
  fairness and exactly-once effects. Connect native producers directly where
  possible. Independent live requests require physically supported arbitration
  or a proven event-token scheduler; the library's RTZ-backed two-phase arbiter
  and unqualified MUTEX model cannot satisfy native Click or physical signoff.
  - [ ] **11a. Host admission storage.** Replace mailbox/reset-debt storage while
    preserving each frame's admission-time reset/busy context and overflow proof.
    - [x] **11a1. Remove the redundant clocked I2C frame copy.** A separate
      native-protocol receipt in each design carries only synchronization and
      acceptance history. The existing native publisher retains the full frame
      until the real mailbox capture edge. Qualify receipt acceptance with the
      destination work-clock enable; retain ungated wake demand while stalled.
      Preserve the two-slot mailbox, admission-time context and overflow behavior
      in this substep. Check all 337 source bits through actual destination capture,
      full BD return and Click parity, stopped-work clocks, POR and watchdog
      episodes. Existing wire/status/reset/busy oracles must stay unchanged.
      Digitally verified: 489 verification cases in an audited combined cohort,
      two physical-policy cases, 329 Python tests, actual capture/fault controls
      and both strict exports pass. Evidence is in
      `build/async-host-frame-migration/qualification-evidence.json`. The change
      removes 339 clocked bits per variant with unchanged public ports. The
      mailbox/count/debt remains clocked; physical qualification is still open.
      Follow the [frame-admission contract](../frame-admission-contract.md), including
      actual mailbox capture, complete epoch comparison, same-edge Stored context
      and source/work-clock handoff. Separate digital native-bus aperture evidence
      from the still-unqualified physical synchronous-context hold paths.
    - [ ] **11a2. Native accepted-frame slots and context.** Replace both mailbox
      payloads, occupancy and reset debt with native ownership. Keep exactly two
      accepted, undispatched frame credits; distinguish reservation and physical
      return occupancy. A full-queue offer must still fault rather than wait for
      an idle context. Join each reserved slot with its actual admission-edge
      busy/reset context, and retain existing reset epoch through Host dispatch.
      The 64-bit epoch rejects wrap; it is not an unbounded lifetime identity.
      Use the existing Control-command capture as the destination and remove
      the temporary receipt when its dispatcher becomes native in 11b/14.
      - [x] **11a2a. Native payload ownership and per-frame epoch.** Replace the
        two clocked payload banks with separate native, non-compacting retained
        banks. Retain each frame's original epoch through actual Host-command
        capture and remove queued reset debt. Keep the existing narrow logical
        occupancy count explicitly temporary while validating wide ownership.
        Distinguish accepted credits from banks still occupied by physical
        return. If an accepted frame remains in its native publisher while its
        assigned bank returns, it already consumes a logical credit. Prove this
        cannot hide a later completed-frame offer and its overflow fault; retain
        the original offer frontier or qualify the complete return/backlog bound.
        Additional native retirement storage must not add accepted credits.
        Do not acknowledge the publisher before immutable payload retention is
        proved. Qualify each head's full return independently of the next head's
        selection.
        The historical verified implementation uses four fixed native banks, two logical credits,
        two four-bit descriptors and the unchanged original admission receipt.
        It removes 516 periodic-clocked bits per variant after counting four
        five-bit head receipts, the two-bit tail and two busy synchronizers.
        Full digital qualification and fresh independent review pass; retained
        evidence is under `build/async-host-admission-payload-migration/`.
        Physical timing remains item 17; this step does not remove logical Q.
        Historical R3 at `a3f11af` superseded its copy-before-original-A
        assumption by delaying A until completion and joining publisher ACK.
        R3b above restores independent original A by giving each native store
        its own route counter, retaining the native completion join. The checked
        items below retain the scope of the earlier 11a2a digital campaign;
        R3 and R3b record their separate verification.
        - [x] Prove complete bank availability at original O and by A_(i+3),
          independent copy ordinals (including identical payloads), fixed bank
          rotation, retained BD routing and independent per-bank Click phases.
        - [x] Check every actual capture pin, all selected/unselected feedback,
          all nine Click triggers, min/max skew and service-period breakpoints.
        - [x] Preserve original A/ACK, exact two-credit overflow including D on
          the same edge, D-time epoch classification, priority and sleep demand.
        - [x] Freeze full regression, unchanged earliest wire/status deadlines,
          strict exports, real RTL fault controls and independent review before
          committing and pushing this substep.
      - [ ] **11a2b. Native logical credits and admission observation.** Remove
        the temporary occupancy count using separate retained admission/dispatch
        histories or an equivalently proved native owner. Keep the frame-offer
        observer live while full: delaying an offer until dequeue would silently
        remove the existing overflow fault. Prove full plus simultaneous dequeue
        still faults, while an earlier dequeue releases logical capacity before
        the next permitted admission. Bound every credit-observation path at
        the 20 MHz service limit; a 110 ns transport guard cannot substitute for
        a required next-edge decision. Account for physical return occupancy,
        reserved payloads, and accepted but not yet copied publisher payloads
        separately. With two queued frames and a third offer reaching request
        meta at E1, release an old Host dispatch at E2: admission at E3 must
        succeed. Move that dispatch to E3 or E4 and require the original overflow
        at E3. Drive the control-release stimulus off active edges. Publisher
        reuse spacing does not constrain this independently delayed dispatch.
        Complete the native credit proof before closing 11a2.
        - [ ] **11a2b1. Remove redundant clocked occupancy.** First replace only
          the two-bit mailbox count, preserving both four-bit descriptors, the
          admission tail and all original A/D events. Prove that accepted and
          dispatched histories reproduce empty/full through modulo wrap without
          adding credit. Click may reuse independent head-ACK phases; BD needs
          rising-edge-only retirement history so an old falling return cannot
          count as a new D. Cover old-return/new-D coincidence and lost, duplicate
          or reordered events with independent ordinals. Count this as removal
          of redundant clocked state, not completed native admission ownership.
        - [ ] Qualify the complete D-to-next-edge decision path, including source
          clock-to-Q, native logic, downstream descriptor/dispatch enables,
          generated-clock skew and destination setup. Prove minimum contamination
          and hold for both A and D through the same work-clock edge, and bound
          binary-tail-to-Gray glitches. An early A-tail change must not redirect
          an empty enqueue into descriptor two or falsely fault a one-to-two
          admission. Include simultaneous-A/D busy-context capture in the cone.
          Keep transient empty/full values away from asynchronous side effects.
          A provisional 30 ns Click / 40 ns BD logic path alone is insufficient
          evidence that the full 50 ns edge-to-edge requirement is met.
          A single complete six-input decision transform may reduce that digital
          target to 10 ns Click / 20 ns BD. Pin the entire expression and every
          output polarity, preserve an independent integer occupancy oracle,
          and qualify the remaining consumer cones before removing the count.
          Neither target is a measured physical delay.
          The preliminary five-corner Boolean experiment measured 0.262479 to
          9.705319 ns before source flops, downstream consumers and wiring. It
          establishes neither a one-nanosecond minimum nor complete-path closure.
          Close the relevant physical-flow prerequisites in 17a before using a
          mapped credit-cone result to authorize removal of Q.
        - [ ] **11a2b2. Native descriptor and order ownership.** Replace descriptor
          movement and the retained admission tail with native owners. Reassess
          every temporary receipt and count net state after new ownership is
          included. Preserve source-context association through bank reuse,
          simultaneous A/D, watchdog episodes and queued Host priority.
        - [ ] **11a2b3. Remove the admission-context boundary.** Move remaining
          A-time context and observation with their generating dispatcher in
          11b/14. A delayed native observer must never resample live reset/busy
          signals as if they were the original A-time values. Qualify the actual
          capture aperture before removing the final held context packet.
    - [ ] Inventory the entire frame path, including native I2C publication,
      its clocked delivery copy, both mailbox slots and reset-debt count. Preserve
      effective capacity and the exact admission event across the replacement.
    - [ ] Retain frame payload and occupancy in separate native BD/Click owners.
      Connect adjacent native producers directly where their lifetimes permit;
      account for every remaining payload copy and temporary clocked receipt.
    - [ ] Replace queued reset debt with non-wrapping, per-frame lifetime history.
      Preserve frames already queued when reset asserts, frames admitted during
      reset, and explicit commands admitted after reset. Cancellation must mark
      the command's context without discarding persistent loader effects.
    - [ ] Preserve admission-time busy history, including a new frame coincident
      with loader-command acceptance and a Stored reply held after SRAM drains.
      A later idle observation must never reclassify the earlier frame.
    - [ ] Verify simultaneous enqueue/dequeue, full/empty transitions, prolonged
      consumer stalls, repeated resets and overflow faults with independent
      payload/order oracles and real I2C transactions. Qualify capture apertures,
      reset crossings and both native return protocols before removing copies.
    - [ ] Audit net clocked storage, ABI and permanent-supervisor progress;
      complete strict exports, actual RTL fault controls and fresh review,
      address findings, update contracts, then commit and push.
  - [ ] **11b. Dispatch ownership.** Move Control outstanding, reset, HALT and
    MMIO-commit scheduling into native retained tokens; preserve completion-first
    priority and the offered-request event-clear window.
    - [x] **11b1. Borrow native HostFrame at Control ingress, digitally verified.**
      Final regressions, exact fault controls and strict exports pass. The sender's
      271-bit periodic frame copy is replaced by a POR-owned two-bit bank identity
      and pending flag retained until complete
      native command acceptance and work-qualified tag retirement. BD overlaps
      native/receipt returns with a per-bank C-element; Click accepts the head at R.
      Logical dequeue/admission timing and dispatch-time epoch/busy context are preserved.
      [Ownership contract](../frame-admission-contract.md#11b1-borrow-the-retained-frame-through-native-control-acceptance).
      [Matched cost and review](../reviews/control-frame-borrow.md): 268 fewer mapped
      periodic flip-flops per variant, repaired logic down 0.024174 / 0.028878 mm²,
      with unchanged native-model firmware wake edges. Physical timing remains open.
      This does not migrate the Services scheduler or remove its header crossing.
    - [x] **11b2. Borrow retained Housekeeping command storage, digitally verified.**
      Functional tests, strict exports, matched mapping and fresh review pass.
      The existing ordered bank holds
      ordered, background and recovery commands through actual sender idle, with
      backpressure on the competing Control period-update writer. Only recovery
      identity travels through the sender. Settling/return cadence, queued
      observations, publication-only consumedGray advancement and the separate
      33-bit in-flight projection remain. Removes 211 sender flops per variant.
    - [x] **11b3. Borrow Telemetry commit operands, digitally verified.**
      Verified with 11b2 in one batch: 319 Scala cases, all four strict exports,
      exact fault controls and matched cost/activity. The existing commit bank retains
      clear/offset/data/appIndex through complete sender return. Non-Commit
      commands see zero; dynamic observations remain in the sender header.
      Cancellation must not destroy an already dispatched payload. Removes 51
      sender flops per variant. Both contracts, stopped-consumer/reset/return tests and
      exact live-source fault controls are in the
      [batch review](../reviews/service-command-borrow.md). These changes remove
      copies, not the remaining clocked dispatch owners; physical apertures stay
      open under item 17.
  - [ ] **11c. Independent-request arbitration.** Implement and qualify the
    required arbitration or event scheduler, including simultaneous arrivals,
    bounded CPU/background fairness and permanent-supervisor independence.
- [ ] **12. Native observation transport and reduction.** Remove clocked elapsed,
  acquisition and GPIO-history reduction from Services. Preserve every required
  observation under independent consumer stalls, saturating ages, extrema,
  failed-acquisition history and set-wins events. Supervisor progress must remain
  independent of CPU, Control, Telemetry and Housekeeping publication. Prove
  bounded ingress capacity and overflow behavior against physical source rates.
  - [ ] **12a. Elapsed ordering and reduction.** Move queued/ordered elapsed
    batches, lower time, upper age and overflow history to native tokens. Keep
    accepted writes ordered against the frozen older batch; only Housekeeping
    publication advances consumedGray. Preserve the independent LF source.
  - [ ] **12b. Acquisition fan-out.** Give Telemetry and Supervisor independent
    retained histories, including extrema, failed frames, validity gaps and
    conversion age. One stalled consumer must not stop permanent supervision or
    make an old frame fresh. Prove bounded buffering and all overflow responses.
  - [ ] **12c. GPIO/event history.** Move post-sampling edge/history reduction
    and the offered-MMIO clear-protection window to native ownership. Preserve
    events raised before dispatch, application-reset masking, set-wins behavior
    and deadline replacement without duplicating or losing a physical observation.
- [ ] **13. Native publication and coherent host reads.** Replace clocked state
  replicas, bank capture/selection and output-effect coordination where feasible.
  Define the read snapshot's atomic point and output feedback timing explicitly;
  preserve the ABI, programming lock, freshness and current-boot ACK qualification.
  - [ ] **13a. State projections.** Remove service-clock Control, Telemetry and
    Housekeeping replicas where native retained views can serve consumers.
    Preserve immediate application masking, persistent samples/time, status
    observation deadlines and all accepted POR-owned effects.
  - [ ] **13b. Output publication.** Move GPIO, cadence launch and board-result
    presentation/feedback to native ownership where pin and downstream timing
    permit. Separate permanent board ownership from resettable application bits;
    permanent-supervisor applied-output feedback must remain independently live.
  - [ ] **13c. Host snapshots.** Replace clocked bank capture/selection with
    retained native snapshots. Define the atomic read point and immutable byte
    lifetime, including adjacent I2C reads, earliest loader status and reset
    during a frame. Keep the existing address/width/error ABI.
- [ ] **14. Remove intermediate service-clock round trips.** Connect the resulting
  native controllers directly, including I2C frame/snapshot delivery and native
  SRAM word/control paths. Remove obsolete bridges, duplicated payload storage,
  clocked outstanding bits and gate demands. Keep only crossings with an actual
  remaining clock domain. This is an integration item, not permission to defer
  an obvious direct connection in an earlier item.
  - [ ] Remove each temporary source reservation/grant/decision/publication/drain
    crossing only when both adjacent owners use the same native protocol.
    Include the temporary final-return receipts introduced by 10b2c2b and
    working-RAM and program capture receipts/return-idle synchronization from
    10b2d1/d2. Replace RAM/program clocked reset-debt/previous-safe policy with
    retained native cancellation/return proof; idle alone cannot release debt.
    The specialized Stored receipt remains until Control acceptance is native.
    The control-only I2C frame receipt from 11a1 is also temporary: remove its
    request synchronizers and clocked ACK with the final clocked admission client.
  - [ ] Connect command/reply, I2C frame/snapshot and SRAM word paths directly;
    retain explicit lifetime isolation between POR and application-reset owners.
  - [ ] Reconcile the emitted crossing inventory and gate demand after every
    removal. Prove complete old phase/RTZ drainage and immediate new-source reuse.
- [ ] **15. Minimize timed I/O and time-source boundaries.** Audit sampled I2C/GPIO,
  SPI playback/admission/age bookkeeping, SRAM byte launch/capture, watchdog kick
  delivery, application reset release, crash accounting, legacy timers, source wake and retained gating.
  Migrate ordering, counters and policy that can operate on native event tokens.
  Investigate edge-driven alternatives where pin electrical constraints permit;
  require metastability-safe arbitration, characterized pulse/setup/hold bounds,
  lossless capture and independent timeout behavior. Keep the pinned synchronous
  SRAM macro contract and independent watchdog/time source unless an equally
  qualified replacement is explicitly designed and verified. A generated local
  clock or renamed clocked module does not establish asynchronous migration.
  - [ ] **15a. SRAM macro boundary.** Reduce clocked state to the pinned macro's
    required byte launch/capture and clock obligations. Move remaining word busy,
    sequencing, accounting and response presentation out of that boundary.
    Separately evaluate whether the pinned macro can accept request-driven local
    clock pulses instead of periodic service-clock access. Require the actual
    macro's minimum high/low times, input setup/hold, read-data validity, recovery,
    reset isolation and retained-supply behavior across all pinned corners.
    Preserve the current service-clock implementation until that replacement is
    qualified; renaming a clock or moving the same clocked controller is not a
    native access sequencer or proof that periodic operation is necessary.
  - [ ] **15b. Sampled input boundaries.** Evaluate I2C/GPIO edge-driven capture
    against metastability, input filtering, minimum pulse widths, coherent slots,
    address-only wake and independent stuck-bus timeout. Retain periodic sampling
    only with a specific electrical or verified capture constraint.
  - [ ] **15c. SPI waveform boundary.** Separate required timed pin transitions
    and MISO capture from convenience admission, age and playback bookkeeping.
    Evaluate event-driven sequencing without stretching an in-progress frame or
    violating either edge's setup/hold and minimum high/low bounds.
  - [ ] **15d. Independent time and watchdog.** Keep supervision live while
    service clocks stop; minimize delivery/coalescing, legacy dividers and kick
    bookkeeping around the independent source. Requalify Gray/ACK CDC, timeout
    units and worst-case progress before changing a source or crossing.
  - [ ] **15e. Reset, wake and gating.** Audit qualification, crash accounting,
    source enable and safe clock stop/start. Native replacements must preserve
    asynchronous assertion, bounded release, no lost wake and the independent
    watchdog. Count physical reset/synchronizer/gating state explicitly.
    Include the generated chip wrapper's `resetHold`: its default 100,000-cycle
    hold uses three register declarations / 20 bits outside the portable SoC root.
    Preserve the continuous-good >=5 ms requirement while evaluating alternatives.
- [ ] **16. Residual synchronous-state audit.** Inventory every remaining
  periodic-clocked state owner in both elaborated production SoCs. For each,
  record its clock, purpose, physical/ABI constraint, alternatives considered and
  evidence for retaining it. Reopen migration items for convenience-only state.
  Check native Click end-to-end, service-clock-stopped progress, source-rate and
  backpressure bounds, reset isolation and all public interfaces. Do not claim
  maximal feasible asynchrony based on source-level module names or test passes.
  Start from the emitted inventory below, resolve every local clock alias to its
  real domain, and split flattened top-level state into individual owners before
  assigning a physical justification. Native-to-clocked bridges are removal
  candidates whenever their clocked consumer is migrated; their presence alone
  does not justify retaining a service clock.
  The [preliminary residual ledger](../async-residual-state.md) partitions all
  current reference-configuration nonprimitive bits and identifies the largest
  remaining transport, replica and history owners; it does not close this item.
  - [ ] Resolve the complete emitted register/event-control inventory to clocks
    and reset domains; account for flattened and generated state as well as children.
  - [ ] Maintain a separate chip-boundary ledger for reset hold and oscillator/
    supply boundaries; exclude behavioral model and verification-only state from
    production counts. Reconcile this ledger with both portable SoC inventories.
  - [ ] Cover supported configurations explicitly: reference Groundlark low-power
    emitters, legacy service-derived time, autonomous ADC cadence, ADC-disabled
    builds and generic application-word projections. Record conditional owners
    or justified exclusions; one reference emitter cannot cover the reusable SoC.
  - [ ] Classify each retained owner with its specific constraint, rejected
    alternatives and evidence; reopen any convenience-only boundary.
  - [ ] Recheck clock-stopped progress, maximum source rates, saturation/overflow,
    reset and end-to-end native Click after the final boundary removals.
- [ ] **17. Physical requalification (previously item 10).** Qualify new-controller
  timing contracts, mapped decode/data paths, arbitration/metastability handling,
  pulse/fork/return timing, reset and CDC bounds, then new P&R and extracted
  validation. Feed physical failures back into the migration design; digital
  passes alone cannot check this item or establish physical feasibility.
  Local physical prerequisites may be addressed during migration when a design
  decision depends on them; full-chip closure still follows the residual audit.
  - [ ] **17a. Restore complete physical-flow coverage for migrated RTL.**
    - [x] **17a1. Bind control guards by their role — locally verified.** The
      repaired mapper explicitly classifies every ControlGate by reviewed owner/ID
      and exact timing references, rejects unknown/conflicting/passive roles and
      parameter-tuple collisions, and preserves real per-lane control chains.
      The complete 1,440-instance audit fixes 54 scalar-data and 12 vector-control
      misclassifications. All 60 candidate tuples have five-corner per-lane
      measurements; all ten original vector-control tuples fail their intended
      minimums. Fresh review closed the passive-view bypass. Keep whole-transform
      allowances distinct; their complete upstream
      paths remain a separate 17a3 obligation. A corrected local adapter is not
      whole-controller timing qualification. Follow the
      [guard binding contract](../physical-control-guard-contract.md).
    - [ ] **17a2. Export and constrain the actual controller policies.** The old
      physical emitter is rejected by ClickFabric's simulation-policy guard.
      Preserve that guard until an explicit supported policy is verified. Bind
      each controller's actual contract, generated clock and reset domain;
      reconcile extracted verification sources without admitting arbitrary RTL.
      Replace stale hierarchy names and broad false paths that hide related-
      clock credit consumers. Preserve all original source and mapping checks.
      - [x] **17a2a. Supported physical export restored and digitally verified, 2026-10-12.** Export both
        current native controller contracts with the enabled evaluation board
        policy, retaining the unsupported Click-policy rejection. Keep assertions
        inline without admitting arbitrary verification sources. Hash-bind the
        actual contract and port schemas, label every result unqualified, and
        remove obsolete global timing claims that do not describe the controllers.
        Verify strict exports, source inventory, exact primitive mapping and
        rejection of stale policies before committing this prerequisite.
        Four physical tests, 378 Python tests, 3,620 actual frame-source mutation
        controls and 124 return integration tests pass. Both strict exports pass:
        815,242,320 BD and 706,764,240 Click mapping checks, with identical public
        port schemas and exact executed-probe/binary binding. Cell functional
        checks and synthesized connection audits retain all three SRAMs and
        preserved async cells. Fresh review closed a disabled-assertion hole;
        the final helper generation/compile matches the executed probe exactly.
        Evidence: `build/async-physical-export-migration/qualification-evidence.json`.
        No controller RTL, state ownership or delay budget changed. R1–R3,
        current related-clock constraints and physical qualification remain open.
      - [ ] **17a2b. Rebind clocks, reset and crossing constraints.** Use the
        current mapped hierarchy and actual source/consumer pins. Distinguish
        truly asynchronous first stages from related work/service-clock paths;
        cover every custom event clock and reject missing or ambiguous objects.
        Retain negative controls for stale names and false paths that hide the
        credit cone. This remains separate from complete 17a3 timing closure.
    - [ ] **17a3. Measure every custom timing obligation.** Canonical payload-stage
      reports do not cover the migrated controllers' custom transform, trigger,
      feedback, distribution and return paths. Require a complete per-obligation
      inventory, exact mapped endpoints, min/max coverage and negative controls;
      omitted paths or unmeasured allowances must prevent qualification.
      Measured 17a1 candidates already require envelope redesign: the 110 ns
      vector guard reaches 711.972290 ns and the 241.200001 ns guard reaches
      1548.816406 ns before wiring. Their reset paths also exceed the current
      250 ns settlement assumption. Long guards currently lack a finite local
      maximum check; local minimum passes cannot authorize controller use.
      - [x] **Bounded Control electrical repair — opt-in measurement only.**
        Buffer the identified 125-sink BD and 33-sink Click ordinary update
        nets, preserve the complete original graph after buffer contraction,
        and compare all five corners at fast/slow input transitions. Selected
        capacitance/slew limits pass; no native cell, guard or clock changes.
        See [the reviewed evidence](../reviews/control-electrical-repair.md).
      - [x] **Bounded native Control characterization tooling.** Preserve the
        uncut controllers and all 315 payload cells; reject unresolved sampling
        and verify actual capture-branch fault controls in both variants.
        Independent review and 806 Python tests pass. Refined timing remains open.
      - [x] **Conditional Control relative-timing pilot.** Resolve all 315
        actual captures, both Click phases, release-triggered Click capture and
        native ACK paths under explicit event states. Keep common-event hold,
        actual phase CLK-to-Q and per-corner physical cell apertures; verify
        period invariance and actual-arc fault controls. See
        [the scoped evidence](../reviews/control-relative-timing.md). No hardware,
        guard length or simulation policy changes.
      - [x] **Reusable canonical-stage local measurements.** Resolve contract
        instances through mapped module reuse, verify physical pin pairing and
        static lanes, and retain same-corner signed allowances. Survey execute,
        elapsed, RAM prepare/issue/capture and I²C update in both variants. Use
        [the stage survey](../reviews/native-stage-timing.md) for exact evidence and
        limits. New tools run with configured native Linux or WSL executables.
      - [x] **Conditional Control Join launch/setup composition.** Bind both
        actual operand stores, rendezvous and update stage; measure source input
        aperture and loaded source-to-capture paths in both native protocols.
        Verify BD Q-before-close and ACK-after-direct-close, both Click phases,
        slew custody, exact graph/arc controls and all five corners. All 20
        corner/slew cases and both revised control campaigns pass; independent
        review has no remaining blocking finding in this scope. See
        [the scoped evidence](../reviews/control-join-timing.md). Full source reuse,
        pending/return/pulse, simultaneous rendezvous and mismatch remain open.
      - [x] **Conditional Control capture retention.** Extend the sealed loaded
        Join slice with common-event capture-to-ACK hold, allowing zero source-Q
        and transform contamination delay. Measure the BD hold fork only under
        its proved settled-B Boolean cofactor; retain loaded cell/wire arcs and
        exact slew handoff instead of an automatically cut STA path. Verify
        both operands, both Click phases, five corners and actual-arc controls.
        All 20 cases resolve, eight physical fault/period controls and 922 Python
        tests pass, and fresh independent review has no blocking findings.
        See [scope and evidence](../reviews/control-retention-timing.md).
        B-before-ACK, overlapping transitions and complete source reuse stay open.
      - [x] **Reusable Join binding and conditional execute composition.**
        Reuse the Control measurement template with exact operand-field mapping
        and a separate source-input ledger. Keep all 480 RF bits symbolic and
        explicitly uncomposed, including their overlap with 274 result lanes.
        See [execute evidence](../reviews/execute-join-timing.md); positive
        conditional Join margins do not qualify whole execute timing.
      - [ ] **Electrical-first correction.** Run global graph-preserving repair
        in the default mapper with native leaves protected, then rerun the
        existing campaigns on its accepted graph. Retain residual electrical
        failures. Owner parameterization, longer elapsed/execute requests and
        the BD Control source ACK guard are implemented alongside this work;
        see [the correction record](../reviews/electrical-first-correction.md) for
        their digital evidence and the remaining physical gates.
        Shortening any guard waits for the complete measured envelope.
        - [x] Measure the slow request adapter and test existing elapsed batching
          and final maintenance drainage at 645 ns. Retain the unchanged 2 us
          tick sleep oracle's failure; document the production-coefficient
          conditional throughput budget. See [evidence](../reviews/elapsed-throughput.md).
        - [x] Anchor repaired stage/Join queries on preserved native leaf pins,
          including elapsed mode fanout and the actual BD Control ACK guard;
          see [binding evidence and limits](../reviews/repaired-leaf-timing.md).
        - [x] Repeat the seven-stage and Control Join corner/slew campaigns on
          the final mapped/repaired graph: 140 stage cases and 20 Join cases
          resolve with positive conditional margins. See
          [results and limits](../reviews/repaired-leaf-timing.md#final-mapped-graph-corner-sweeps).
          Small BD hold/ACK margins, RF/elapsed source composition and routed
          measurements remain open; this is not full-chip guard qualification.
        - [x] Provide separate parent drivers for all three SRAM clocks and
          structurally bounded native capture distribution for RF, frame banks
          and I2C publication. Maximum branch fanout is 16. The full local
          distribution sweeps retain one BD/eight Click propagation-budget
          failures; see [the contract and measurements](../native-capture-distribution.md).
          This structural completion does not close physical distribution timing.
        - [x] Repeat graph-proved repair after placement and global routing;
          both variants complete with exact native connectivity and all three
          exclusive SRAM drivers preserved. The pinned resizer's zero-progress
          loop required a tested upstream backport. All five corners retain
          electrical reports: the final SS-hot slew counts are 9,241 BD/11,241
          Click, with no capacitance violations. This completes execution and
          accounting, not electrical closure. See [results and runtime correction](../reviews/wire-electrical-repair.md).
        - [x] Publish total before/after repair area, including writer-workaround
          buffers, ties and resizing; see [accounting](../gf180-estimates.md#electrical-repair-area).
          A flat repair or writer fix remains a separately proved optimization.
        - [x] Count both ACK-guard edges in the native-model wake workload and
          explicit representative guard energy; document Click's existing native
          guard and physical ordering obligation. See [activity evidence](../reviews/ack-guard-activity.md).
          Mapped wake timing, actual energy and complete Click capture/ACK closure remain open.
      - [ ] **Post-PR9 repair efficiency and coverage.** PR9 was merged at
        `d72ee39`. Its 140 positive stage cases use the repaired mapped graph
        with zero wire RC; they are not extracted-chip timing closure.
        - [ ] Use corner-specific fractions of the Liberty slew limits for
          ordinary logic, while enforcing 2 ns on native request/capture/ACK
          networks. Preserve tighter macro limits. Compare density 0.6 and 0.7
          using the same die outline for both variants; report area and failures.
          The matched density comparison is complete: 0.70 saves only about
          0.002 mm² per variant and increases slow/hot violating-net counts.
          The first corner-policy comparison passes graph/report controls but
          saves no pre-placement area (about +0.0009 mm² per variant); the
          default remains unchanged pending a wire-dependent comparison.
          See [repair efficiency](../reviews/repair-efficiency.md).
        - [ ] Classify remaining slew failures by protected native boundary,
          unsuccessful repair and ordinary logic, then repair each group without
          waiving protected-pin or graph proofs.
          Classification now resolves actual final nets and retained warnings
          at all five corners; the corresponding repairs remain open.
        - [x] Extract the retained per-lane BD root-to-D minima and distinguish
          Control's internal-feedback bound from its guarded source release.
          The latter has a 52.094408 ns conditional first-admission margin with
          zero data-path credit; retain its existing guard. See
          [the hold evidence and assumptions](../reviews/bd-hold-credit.md).
        - [ ] Complete BD source retention, including RF/FIFO launch/reuse,
          pending admission and both returns. If an owner's complete envelope
          remains inadequate, add a short native outward ACK guard. The local
          contamination samples do not close this item. Click already has its
          32 ns stage ACK guard.
        - [x] Close the nine **local, zero-wire** capture-tree budget failures
          with stronger wide EventRegister capture roots/trunks; 660 cases per
          variant pass the unchanged budgets. Routed capture/ACK closure and
          mismatch remain open; see [the capture contract](../native-capture-distribution.md).
        - [x] Send the OpenROAD progress findings upstream. Both fixes were
          already merged; [our integration report](https://github.com/The-OpenROAD-Project/OpenROAD/pull/10514#issuecomment-6235806466)
          supplies downstream controls and test evidence, with upstream attribution.
        - [x] Audit remaining periodic clocks against native ownership. The
          [clock audit](../reviews/remaining-clock-trees.md) distinguishes physical
          sampling/time obligations from removable Services/transport state.
        - [x] Correct the newly found gated-work CTS construction gap and verify
          every periodic sink, including falling-edge launch and three SRAMs.
          Automatic discovery now covers the repair-buffer-hidden tree of
          4,009 BD/4,060 Click clock pins. Independent Liberty/graph inventory,
          actual clock relationships, whole-graph proof and fresh review pass.
          See the [construction evidence](../reviews/remaining-clock-trees.md).
          CTS balancing warnings, skew, pulse and electrical closure stay open;
          keep native capture events and SDA out of CTS.
      - [ ] **Execute RF and elapsed seeded-owner composition.** Follow
        electrical repair and the rerun campaigns. Measure actual register-bank launch,
        forwarding/Fork/Join ordering and all 15 banks. Preserve elapsed's
        seeded FIFO/merge or phase-decoupled Click owner, parent admission/data
        glue, independent side sources and publication loads. Its modeled
        output guard is 31/32 ns, not the 11 ns request guard. Cover command-last,
        owner-last and feedback contexts. Repair electrical violations before
        trusting small margins; safe-direction parameterization/lengthening
        does not need to wait for composition.
      - [ ] **Complete controller templates and custom publication.** Derive
        the missing BD pending/return and Click pulse/self-hold cases from the
        controller state graphs; add FIFO/Join and I2cPublication templates.
        I²C update measurements do not cover publication.
      - [ ] **Reduced controller SPICE and physical runtime portability.**
        Validate lumped capture loads against the retained full-payload model,
        use native crossing measurements and prove timestep convergence. Convert
        the remaining legacy synthesis/P&R/SPICE launchers to configuration.
      - [ ] **Complete paired Control capture/hold analysis.** The conditional
        pilot resolves local E/CLK/ACK paths; Control Join initial setup is now
        composed; the local zero-contamination hold and settled-B fork checks
        remain conditional. Full source retention/reuse, BD pending
        admission/returns and Click pulse/feedback remain open. Bound full
        source reuse without blind cuts or periodic staging, repair residual
        electrical violations, then include routed min/max RC. Global mapper
        repair has its own structural gate; it does not waive these obligations.
        The [uncut native Control harness](../reviews/control-native-characterization.md)
        now retains every controller feedback cell and all 315 payload cells.
        Coarse TT pilots expose unresolved sampling, including a possible short
        second-phase Click pulse. Resolve and converge sampling before a full
        corner campaign; these pilots do not close capture/hold analysis.
  - [ ] Characterize complete new data/control transforms, selection guards,
    feedback, arbitration and reset paths at all required pinned corners.
  - [ ] Bind mapped cells and constraints to the final emitted ownership graph;
    preserve async cells, macros, supplies and clock/reset domain boundaries.
  - [ ] Rerun placement/routing, extracted async-path validation and clocked STA;
    resolve violations or reopen the affected migration decision.
  - [ ] Reconcile the residual-state audit with physical results before making
    any maximal-asynchrony or timing-closure claim.

Items 1-9 are digitally verified within their original scopes. On 2026-10-10 the
user authorized deeper migration through the remaining feasible asynchronous
boundaries. Items 10-16 are the expanded implementation/audit scope; earlier
clocked-boundary descriptions below are the starting point, not exemptions.
Complete and review each substep before progressing, retaining actual failures.
Physical requalification follows the residual audit; old P&R evidence cannot
qualify the revised RTL. Every item requires both independent implementations,
invariant-focused tests and a fresh independent review before completion.

## Preliminary residual-state inventory

The 11a2a Groundlark, ADC-enabled, source-stopping low-power portable SoC
exports still contain substantial clocked state. The emitted declaration audit,
baseline comparison and per-owner removal candidates are retained under
`build/async-host-admission-payload-migration/`; see the
[remaining-state ledger](../async-residual-state.md). These are RTL declarations,
not mapped flop counts, area, power or proof of physical necessity.

| Disjoint owner group | BD bits | Click bits | Follow-up |
| --- | ---: | ---: | --- |
| Flattened SoC/Services | 2,735 | 2,736 | Items 10–16 |
| I2C wrapper | 945 | 945 | Items 11, 13–15 |
| SPI wrapper | 175 | 175 | Items 12–15 |
| Two SRAM access wrappers | 30 | 30 | Items 14–15 |
| Elapsed ingress wrapper | 37 | 37 | Items 12, 14–15 |
| 64 crossing/receipt owners | 3,828 | 3,828 | Remove with their clocked clients |
| **Total: 70 owners** | **7,750** | **7,751** | Complete audit in item 16 |

Each total includes one unchanged asynchronous SDA capture bit; periodic-clocked
subsets are 7,749/7,750 bits. Async primitive storage, fixed SRAM arrays and
verification state are excluded. The generated chip wrapper, including its
20-bit default reset hold, is outside these totals. Other supported configurations
may add the legacy service-time divider, autonomous ADC interval counter or
generic application projections. Items 15e/16 require their separate inventories.
Program return removes 87 crossing bits and adds seven temporary receipt/idle
bits, for a net reduction of 80 per variant relative to `60c5590`. The earlier
RAM return step removed another 39. Frame receipt 11a1 removes 339 more relative
to `d688255`, reducing I2C delivery crossings from 359 to 20 bits. Native frame
payload/epoch ownership now replaces the old 550-bit mailbox/count/debt with ten
descriptor/count bits and adds 24 temporary receipt/tail/busy bits, a net 516-bit
periodic-clocked reduction relative to `a0e2d1a`. The four banks add 1,348 native
payload bits plus native controls. Physical qualification remains open;
these counts are not total storage, area or power savings. Temporary crossings and reset/debt policy
remain removal candidates; neither those savings nor passing tests close the audit.

An owner is retained only with a specific physical or interface obligation and
supporting evidence. Independent time/watchdog operation and the pinned synchronous
SRAM macro interface remain requirements; policy and bookkeeping around them
remain migration candidates. This inventory does not close item 16.

## Completion criteria for the expanded migration

- Remove periodic service-clock ownership of the migrated state and control;
  document any residual clocked capture/publication and its reason.
- Show relevant native progress with the service clock stopped, in addition to
  end-to-end behavior with real clocked peripherals. Exercise both protocols,
  backpressure, reset during every transaction stage and exactly-once effects.
- Bound each independent event source and its buffering. Never turn a consumer
  stall into lost supervision, fabricated freshness, missed timeout or an
  unbounded combinational/request loop.
- Describe bundled-data stability, acknowledgment/phase return, reset ownership,
  arbitration and physical timing obligations. Do not infer physical feasibility
  from a digital simulation delay or substitute an unqualified MUTEX circuit.
- Run affected regressions, independent core/reference and Python controls,
  strict SoC exports and ABI checks. Review, fix, rerun, document, commit and push
  each completed item/substep. Preserve unrelated P&R work and original failures.

## SocFabric handshake and timing contract

ROM read/fetch and statically invalid addresses/permissions/widths terminate in
the native fabric without a service clock. Valid program reads/fetches, working
RAM accesses, full-word MMIO and HALT route to the clocked endpoint. Dynamic image
length/validity, writable MMIO permissions, WAIT, loader arbitration and SRAM
side effects remain endpoint responsibilities. HALT commits once and parks
without a response until coordinated reset, as in the existing core contract.

Four-phase holds the source payload through request acknowledgement return.
The reply uses long-hold storage. Endpoint response acknowledgement must stay
asserted until its request falls; source acknowledgement return waits for the
reply input and both endpoint channels to drain. A stalled downstream response
retains its payload independently of the next source request.

Click keeps separate source/reply, endpoint-request and endpoint-response phases.
Local transactions do not toggle endpoint phases. Dispatch fires once per pending
endpoint transaction; reply capture waits for endpoint acceptance and a fresh
response phase. Source and output guards must cover the actual composed control
network, including the three-cell De Morgan ANDs. Standard single-AND ClickStage
bounds alone do not cover that network. The release guard is at least
`inputPhase.max + 7*fire.max + skew + max(pulseLow, hold) + 1 fs` (80.200001 ns
for the 1..10 ns simulation envelope), as well as the supplied standard guard.
The seven cells are one comparator and two serial AND networks. The bound is
checked at source acknowledgement. Endpoint response parity samples its request
on the common capture pulse; local transactions keep that phase unchanged.
There is no separately gated capture pulse that can be filtered by unequal delays.
ClickFabric currently accepts only `ClickTiming.Simulation`: custom stage timing
policies are rejected until their composed-controller bounds can be exported and
exercised. Its strict adapter independently checks the fixed 1..10 ns envelope,
nominal cells, request/data guards, strict return-guard minima and guard pin
connections. Required mux and capture-aperture obligations cannot be omitted.
Focused tests monitor setup/hold and high/low pulse widths at all capture registers.
Source payload reuse must follow capture
pulse drainage. Exported data-path budgets include
the complete ROM/decode/response mux, not an extra physical data buffer.

Both endpoint bridges synchronize control and allow payload settling. Reset all
connected CPU/fabric/bridge phases together on application reset; permanent
service state stays POR-only except its explicitly application-owned registers.
Independent LF/watchdog logic remains live when the service source stops.

These controllers are digital models with ideal combinational glue/forks.
New decode, return paths, endpoint crossings, local pulse widths/distribution,
setup/hold and reset recovery need physical characterization. Historical P&R
under `build/pnr-first/bd-v5` and `click-v2` is for baseline `8637099`, has open
violations, and does not qualify this migration.

## Evidence

The inherited `build/async-fabric-migration/regression.log` records 48 tests,
41 passes and seven four-phase failures. Preserve it and the original lock error
in `native-first.log`. The first focused run (`focused-initial.log`) failed to
bind endpoint port names; `focused-ports-fixed.log` then exposed handshake errors.
`focused-return-ack.log` retains the Click maximum-cell-delay failure after the
first BD return fix. Later strict path/scope and unsized-alias elaboration failures
are also retained rather than overwritten.

SocFabric baseline results: 89 distinct verification cases and two core
physical-policy cases pass; 64 working-tree Python controls pass (six belong to the preserved earlier
P&R work), and all 11 SRAM assets verify. Both production-capacity SoCs pass strict
`--soc --vector-coverage --sleep-clock` exports with three macros each and native
Click throughout. Exact logs, hashes, counts and qualification limits are in
[build and test](../build-and-test.md#asynchronous-socfabric-migration).

The final MMIO/loader run passes all 107 verification cases across fourteen suites
and two core physical-policy cases, with no skipped/canceled/pending tests.
All 68 working-tree Python controls pass (six belong to the preserved P&R work),
and all 11 SRAM assets verify. Both production exports pass strict validation
with unchanged 34-port public ABIs and three SRAM macros each. See
[MMIO/loader evidence](../build-and-test.md#asynchronous-mmio-and-loader-migration)
for logs, hashes, independent review fixes and retained failures.

SocFabric and the scoped MMIO/loader and GPIO/events/telemetry items are digitally
complete. Item 3 passes 121 verification cases across sixteen suites, two core
physical-policy cases, 69 working-tree Python controls and both strict exports.
The 28 affected focused cases pass again after preserving the registered export
boundary. See [item 3 evidence](../build-and-test.md#asynchronous-gpio-events-and-telemetry-migration).
Item 4 passes all 145 verification cases across nineteen suites, two core
physical-policy cases, 70 working-tree Python controls and both strict exports.
See [scaling/CRC evidence](../build-and-test.md#asynchronous-scaling-and-crc-migration).
Item 5 passes 161 verification cases across 21 suites, two core policy cases,
71 working-tree Python controls and both strict exports. Its strengthened six-case
boundary rerun also passes. See [supervisor evidence](../build-and-test.md#asynchronous-permanent-supervisor-migration).
Item 6 passes 169 final verification outcomes, two core policy cases, 74 working-tree
Python controls and both strict exports after independent review. See
[SRAM evidence](../build-and-test.md#asynchronous-sram-access-sequencing-migration).
Item 7 passes 190 verification outcomes, two core policy cases, 80 working-tree
Python controls, thirteen actual wiring mutations and both strict exports after
independent review. See [I2C evidence](../build-and-test.md#native-i2c-migration---digitally-verified-2026-10-09).
Item 8 passes 206 verification cases, two core policy cases, 83 working-tree
Python controls, 22 actual RTL mutations and both strict exports after independent
review. See [SPI ADC evidence](../build-and-test.md#native-spi-adc-migration---digitally-verified-2026-10-10).
Item 9 passes 227 verification cases, two core policy cases, 84 Python controls
and both strict exports after independent review. See
[Housekeeping evidence](../build-and-test.md#native-slow-domain-housekeeping---digitally-verified-2026-10-10).
Physical qualification remains unchecked.

## GPIO/events/telemetry scope and contract

`FourPhaseTelemetry` and `ClickTelemetry` own separate native seeded state-token
loops for software GPIO output/enable, firmware-owned application words, pending
events and host measurement records. Empty channel/application sets omit those
payload fields; Groundlark does not allocate a duplicate software application bank.
The native loops and their command/reply bridges reset only on POR. Click uses
native Click storage, join, transform, fork and endpoint bridges throughout.

Clocked ingress captures GPIO edges, timer/lease/deadline/host events and acquisition
publications. Event sets coalesce. Accepted clears mask only eligible old bits;
events observed during MMIO validation or on the acceptance edge win. Deadline
replacement removes the old expiry from both queued ingress and native pending
state. A newly armed expiry enters a later batch and survives that replacement.
Captured and dispatched event sets remain visible to host snapshots until native
commit, without a temporary disappearing flag. CPU effects serialize against
outstanding telemetry; background observations cannot starve CPU validation.

Acquisition ingress is POR-owned and compacts an arbitrary stalled batch into
an attempt count (modulo the ABI's 32-bit sequence), latest validity/calibration,
last successful value and its elapsed age. Upper elapsed time saturates rather
than wrapping. Software publication enters this retained ingress on CPU acceptance,
even if application reset cancels its outstanding CPU completion. Native sample
records survive application reset. Host snapshots conservatively include queued
and dispatched elapsed time and suppress fresh-valid for a channel with an
uncommitted publication. The existing 36-byte I2C snapshot remains coherent.

Application GPIO, application-word and event projections have immediate raw
application-reset pins. Retained recovery commands clear their native state;
stale replies cannot restore pre-reset values. Accepted CPU effects wait for
native completion before replying. Buffered work and recovery inhibit sleep.

Item 5 replaces the permanent supervisor's clocked safety sample view with a
separate native record. Safety and host records consume the same acquisition
publication stream through independent retained ingress; supervisor freshness
and power decisions do not wait for native telemetry backpressure. Later items
move SPI conversion state and low-power time/deadline/mask/lease/cadence policy
into their own native loops. GPIO synchronizers, LF/watchdog, I2C snapshots,
SPI wire timing and peripheral ingress remain explicit clocked boundaries. This migration does not qualify new physical timing: native
transform data paths, compacted ingress crossings, reset recovery, forks and
capture pulses still require item 17 characterization.

## MMIO/loader scope and contract

`FourPhaseControl` and `ClickControl` own separate state-token feedback loops,
using each native protocol's seeded storage, join, transform and fork. They own
image length/entry/ID, received bytes/CRC, validity, programming lock, loader
mode/error/start state, host selector, producer index/value and application word
selector. Native MMIO preparation validates full-width accesses and permissions.
Its retained staging changes only on a separate commit command created at the
existing service-clock request acceptance. Abandoned preparation has no effect;
an accepted producer-staging commit survives watchdog reset and precedes recovery.

At item 2 completion the service domain retained bounded host ingress and its
busy/reset context, command arbitration, CPU acceptance, coherent snapshots,
MODE/start reset projection, GPIO/event/timer/peripheral effects, I2C and SRAM
byte sequencing. Item 3's separate scope above moves GPIO/event/sample state
behind another native loop. MMIO accesses still cross clocked endpoints. Two explicit,
POR-only native/clocked bridges connect each Control loop. The Click loop and
bridges contain no four-phase adapter. Item 4 originally replaced the shared
combinational CRC word function with four-byte native pipelines. Corrective
A2a subsequently replaced those stages with one narrow whole-word result
stage and retained-context rendezvous in each Control feedback loop; see
[the native CRC contract](../native-crc-contract.md). Candidate and architectural
accounting state remain separate.

One outstanding command preserves order. SRAM completion, accepted MMIO commit,
reset recovery, HALT and host/CPU commands have explicit arbitration. Host frames
remember reset and loader-busy conditions, including same-edge loader admission;
a busy command is rejected instead of executing later. A retained reset request
cannot disappear behind a stalled reply. Queued HALT and unaccepted MMIO are
application-reset-owned; stale START replies and pre-reset queued START frames
cannot restart an application. MODE retains its third-service-edge synchronized
reset behavior through a clocked status projection. Any pending command/reply,
commit or accounting token inhibits retained work-clock shutdown.
Reply acceptance requires that outstanding command. Period candidate bits are
separate from their validated update flag, which alone permits a peripheral effect.

Independent review found and prompted fixes for lost reset pulses, stale HALT,
pre-commit staging mutation, and busy-context loss (including simultaneous host
arrival/admission). `ControlResetSpec` targets these with independently stalled
command/reply bridges; its boundary test verifies that the simultaneous event
actually occurred. The original clear/event race and strict MODE reset assertions
remain unchanged. Full-width loader/CRC/lock, native backpressure and POR abort
also have independent clockless `AsyncControlSpec` oracles for both protocols.

These are digital controllers. The complete command/decode/CRC transforms use
declared simulation budgets; newly mapped paths, state feedback forks, pulse
distribution, CDC/reset and physical implementation require item 17 qualification.

### Fresh SocFabric review

An independent agent reviewed `7f07f01` and found two export-validation gaps:
positive-but-undersized Click guards were accepted, and removing a fabric's mux
timing obligation and marker bypassed its custom checks. Both now fail closed,
with independent negative controls, actual guard/capture pin comparisons and
capture-aperture observations. The reviewer found no default-policy handshake
counterexample. See the review evidence in [build and test](../build-and-test.md).

## Scaling/CRC scope and contract

Each design owns its native elapsed and sample datapaths and clocked boundary
wrappers in `ConstantScaling.scala`. A1b's elapsed implementation replaces the
four unrolled eight-bit transforms with one four-bit transform and a seeded
owner, taking one through eight turns for any unsigned 32-bit delta. The
[elapsed contract](../native-elapsed-contract.md) records its independent external
histories, passing digital checks and open physical timing gates. Three sample stages
still consume four bits apiece after input capture. Elapsed fraction and target
state remain in the native owner.
Interfaces and payload schemas alone are shared. Click stays native throughout.
The explicit wrappers capture requests and publish replies; no service clock
advances the arithmetic. All stages, fractions and both crossings are POR-only.

The scaler publishes ordered elapsed observations to independent aging/history
ingress and native Housekeeping. Final Housekeeping publication advances
consumedGray with NOW/lease effects. New targets queue behind outstanding work. Busy covers arithmetic and bridge
return drainage, including updates that produce zero whole milliseconds. A
one-tick arithmetic result grants observation credit only if its target still
matches the synchronized live count. This prevents stale supervisor confirmation
after delayed publication. Item 8 moves SPI framing, first-conversion discard and
signed offset into native conversion loops; item 9 moves low-power cadence and
timer consumers into native Housekeeping. Independent LF/watchdog, pin timing,
legacy idle delay and ingress/publication remain clocked boundaries.

The original migration used four native CRC byte stages in each Control feedback
branch. Corrective A2 now integrates one narrow whole-word result stage with
explicit retained-context rendezvous; its acceptance is tracked separately above.
The internal token still pairs architectural state with pendingCrc; the public
reply ABI is unchanged. Host/MMIO replies retain their original path, while the
next command waits for feedback completion. Only Stored with an accepted pending
loader word commits the completed candidate to architectural CRC, received bytes
and loaderPending together. Intermediate candidates cannot appear in public
state. Duplicate/early completions with no pending word are inert. Watchdog
recovery queues behind accepted work; POR aborts it and reinstalls cold state.

Fresh independent review identified stale one-tick observation credit and
required the live-target guard above. Keep arithmetic, stall, reset, maximum-delay,
sleep and independent Java CRC oracles. Regression fixes fused the first/last
elapsed arithmetic steps with preparation/finalization and made maintenance
return drainage explicit. The unchanged seven-edge ordinary activity/reset guard
can now count down while tracked native maintenance holds the gate open. BD
telemetry return uses the bridge's clocked ACK falling edge, which follows its
synchronized request return; Click reply acceptance already restores bridge idle.
New commands/outstanding work bridge those handoffs without an idle gap. CRC
precomputation remains in feedback, with A2a's single candidate stage outside
the immediate host reply path. The original sleep and brownout assertions
remain intact.
Digital stage budgets describe entire
transforms, including the quotient/remainder and CRC logic; no mapped timing or
physical signoff is implied. Old P&R results remain inapplicable.

## Permanent supervisor scope and contract

`FourPhaseSupervisor` and `ClickSupervisor` own independent native seeded state
loops for OFF/RUN/SHUTDOWN/LATCHED, faults/timeouts, four confirmation counters,
current-boot acknowledgment qualification, dwell epochs and the safety sample
record. `GroundlarkBoard`/`PowerPolicy` are immutable descriptors in `profiles/`;
no shared clocked board controller remains. Disabled production defaults cannot
energize the Pi. Native Click storage, join, transform, fork and bridges contain
no four-phase conversion. Both complete transforms currently use digital
simulation budgets; physical data, pulse, fork, CDC and reset timing is unqualified.

Each supervisor has dedicated POR-only command/reply bridges. The service island
retains GPIO synchronization, generic acquisition/time history and coherent output
projection, but no power-policy qualification counters or shadow safety sample
bank. ADC pin timing/capture, elapsed request/publication boundaries and LF/watchdog
remain clocked. Housekeeping owns native board NOW; its service projection includes
pending lower time so supervisor progress does not depend on Housekeeping stalls. Application reset neither aborts accepted
supervisor commands nor resets native state, input history or applied GPIO outputs.
Control or Telemetry stalls cannot block this independent loop. Pending input,
outstanding work and bridge return drainage inhibit service-clock shutdown.

Ingress compacts all publication attempts, last validity/calibration, last good
value, first-publication elapsed age, largest inter-publication gap, last-good age,
voltage extrema, any failed acquisition, GPIO changes and any zero-credit time
observation. Ages saturate; publication sequence wraps at 32 bits. A publication
resets current sample age but includes its coincident upper elapsed tick in the
preceding freshness interval. Ambiguous or interrupted batches cancel confirmation
credit; a recovered last sample cannot erase invalid/stale/out-of-range history.
While RUN is active, sensing faults consumed between ticks remain latched until
the next policy evaluation, even if recovery arrives in a separate command.
This is conservative under stalls. Native sample and power decisions do not wait
for host telemetry publication. The ABI still reports the same six board words.

Power transitions wait for feedback from the applied service-domain GPIO projection
before recording minimum-off/shutdown epochs or granting current-boot inactive-ACK
credit. Stalled crossings therefore defer recording the epoch until feedback
and cannot count pre-power ACK history. Minimum-off records the published lower-time count
after power removal feedback; shutdown records it after request feedback. These
are quantized logical-time epochs, not timestamps of the GPIO edges. The tests
preserve configured dwell in that model. LF phase, fractional rounding and elapsed
publication-latency bounds still require timing qualification before asserting
absolute physical durations; that limitation predates this migration. RUN clears previous
ACK observations through the first applied-power command. Later stable inactive,
then stable active-low observations qualify halt. The fixed independent timebase
and watchdog remain necessary even though native state has no service clock.

## SRAM access sequencing scope and contract

`FourPhaseSram` and `ClickSram` retain each accepted word, generate its four
little-endian byte commands and assemble read data through independent native
fork/join/stage pipelines. A seeded execution credit joins each word request;
the final consumer's acknowledgment returns that credit. The final internal
result is acknowledged only after credit capture. The credit payload carries
that retained word's operation bit; it is stable before the response offer and
held through feedback capture. Credit availability, not this payload's value,
controls execution. This serializes byte effects
through response acceptance, including an early next request and stalled replies.
Each disabled store lane still completes a native rendezvous but never enables
a macro. Store replies are zero; reads retain uninitialized bytes as unknown.
Click uses native phase storage, fork, join and crossings without RTZ adapters.

Each bank has explicit POR-only word ingress/reply and four byte request/reply
crossings. The clocked `SramBank` now performs one synchronous byte launch,
access and capture, retaining only that byte and its response-port tag. Its
one-hot port mux is not a word scheduler: native credit and lane rendezvous
guarantee exclusive requests. Service admission still validates addresses,
permissions and loader/CPU eligibility, with loader priority for simultaneous
admissible work. RAM payload bits are offered independently of valid; invalid
cycles are don't-care and cannot authorize a bridge capture or macro effect.
These clock-domain acceptance and status boundaries remain
explicit. Native control owns loader accounting after the completed word.

Macro CLK remains the service clock. Falling-edge launch gives input setup/hold;
the access rising edge is followed by a separate rising capture edge, leaving a
full cycle for Q. CEN is inactive between accesses and in retained sleep. No local
clock generator is introduced. The four sequential crossings increase word
latency; the former eight-service-cycle completion bound no longer applies.
Busy covers the admitted word, final reply and every crossing return before
another admission or sleep. Watchdog reset discards CPU replies while native
tokens, byte accesses and loader accounting survive. POR cancels pending tokens
without clearing or replaying already-written macro bytes.

The complete native transforms and acknowledgment/credit feedback currently
have digital simulation bounds only. Macro duty cycle, input/Q paths, native
feedback/fork/capture paths and CDC/reset placement need physical qualification.
The older baseline P&R results do not qualify these controllers.

## I2C scope and timing contract

`FourPhaseI2c` and `ClickI2c` own independent native protocol state: address
selection, receive/ACK sequencing, byte storage and length/overflow validation,
STOP/repeated-START frame formation, read serialization and master-NACK release.
Their feedback loops, publication storage and frame/snapshot channels use their
respective native protocols. Click contains no four-phase adapters.

Each separate `I2cTarget` retains a clocked wire boundary: two-flop SCL/SDA
sampling, edge detection, an eight-entry captured-edge ring, and the independent
inactivity counter. Slots include sampled SDA/read-word and admission context;
occupied slots remain immutable until the native published head returns through
two Gray-pointer synchronizers. Both binary pointers have an extra wrap bit and
registered Gray representations. Full-ring overwrite is a contract violation,
with a simulation assertion. Physical pointer skew/metastability qualification
is still required. The protocol loop consumes retained observations, never live
wire levels. Inactivity is counted from the sampled wire change so native
publication latency does not extend the configured timeout.

A common native capture projects the open-drain drive and protocol state, and
stores independent frame and snapshot effects. A held effect retains its own
payload while unrelated observations advance; a second effect of the same kind
backpressures publication. BD offers remain asserted through input return and
output acknowledgment, preventing a second offer from a delayed source return.
Click captures output phase feedback on that same event as all payloads.

POR-only frame/read-start bridges publish into the service domain only after
the target's two-edge local POR release. Coherent host-bank capture, word selection,
Control mailbox arbitration, the wire sampler,
startup wake qualification, timeout clock, LF/watchdog and source gating remain
clocked boundaries. Native I2C does not replace the independent timebase.
A POR-owned 64-bit reset epoch travels with completed frames; a mismatch on
service delivery retains an intervening watchdog episode, even if it ended
before delivery. Epoch wrap is outside the supported lifetime and asserted in
simulation. Current and sampled reset/busy context are also retained. POR aborts
pending effects; watchdog reset does not reset this hierarchy.

Busy combines synchronized native activity and held effects, bridge publication,
and START/STOP activity. Arbitrary inactive ring traffic does not retain service
clock demand, preserving foreign-address release. The existing seven-edge drain
and address-only source-start probe remain in force. Read-bank capture must
finish before the first data launch after address ACK; completed SELECT frames
must publish before the following read snapshot. ACK is byte reception, not
loader command completion. Internal status projection can follow STOP later
than the old clocked target's incidental testbench delay; architectural state,
error assertions and the earliest legal on-wire status observation remain checks.

The complete projection mux (including Click phase feedback) has one fixed
10 ns digital data-path model, an 11 ns request guard, 1..10 ns storage/control
cell experiments and 110 ns source/output guards. All event/phase registers
share the capture event; setup/hold and high/low pulse checks cover each register.
These composed-controller guards, primitive inventory, actual mux/storage pins,
phase pins, internal composed-AND connections and reset ownership are strict-export
obligations. They are digital simulation assumptions, not characterized physical paths. Bus-rate qualification
must bound absolute native latency as well as the existing >=8 service cycles
per SCL period and >=4 cycles per phase; a cycle ratio alone is insufficient.
The focused wire campaign targets 400 kHz at 3.2 MHz and 20 MHz service clocks
with maximum native delays, including adjacent sampled SDA changes. Physical
SDA setup, feedback/fork timing, Gray CDC, reset recovery and output pads remain
unqualified. Older P&R artifacts do not apply.

## SPI ADC scope and contract

Item 8 passes digital verification and strict export validation after fresh
independent review. Each design has its own native conversion loop and clocked boundary
in `FourPhaseSpiAdc.scala` or `ClickSpiAdc.scala`. Shared code contains only the
wire schemas and parameter/budget definitions. Click stays native throughout.

The native controller owns a single conversion credit, an immutable mode-0 pin
recipe, the primed state, frame assembly, exact integer scaling, signed offset
and retirement. Its waveform token and retained conversion context fork together;
the capture rendezvous joins all 32 MISO observations with that context. Assembly
selects sixteen rising-edge observations and ignores the first four, leaving the
twelve-bit sample. The first complete frame after POR primes the converter but
does not publish; an incomplete frame cannot prime it. The feedback credit returns
only after the consumer accepts the reply. All four crossings and all native
state are POR-only; application watchdog reset cannot discard or replay them.

The clocked boundary admits a conversion, indexes the immutable native recipe, emits exactly
32 half-period slots and buffers every MISO observation. It never waits for a
native per-edge acknowledgement while CS is low. CS asserts with SCLK low; the
first rising edge follows one complete half-period. The sixteenth falling edge
releases CS after the final complete high phase. C1d replaces copied shift
mask/pin vectors with a slot and active bit; its acceptance is tracked above.
Clocked state retains the divider, pins and observations, not ADC field extraction,
priming or scaling state. Native backpressure can delay admission or publication,
but cannot stretch a half-period. Busy includes every phase through complete
command/wave/capture/reply return. Neither another start nor retained sleep may
interrupt that lifetime.

Item 9 moves low-power cadence into separate native Housekeeping loops. Periods remain
start-to-start, accepted updates apply on an eligible between-conversion tick,
first-discard retry is immediate and repeated updates cannot starve acquisition.
Legacy mode retains its idle delay between conversions. The digital budget is
`32 * halfPeriodCycles + 32` service edges plus 2 us of native processing, rounded
up to milliseconds for cadence limits. The focused maximum-delay experiment uses
20 MHz service, two-cycle half-periods and the 1..10 ns native cell envelope; it
requires exact 100 ns phases and completion/drainage within 6.8 us. Those are
simulation obligations, not ADC electrical or physical path qualification.
That stress case produces 5 MHz SCLK, above the ADC121S021's specified 1..4 MHz
electrical-performance range; see its [datasheet, section 7.5](https://www.ti.com/lit/ds/symlink/adc121s021.pdf).
Production emitters retain 1 MHz SCLK.

Age accumulates saturated upper-bound elapsed time from admission, excluding an
elapsed interval coincident with that initial admission and including a tick
coincident with publication. Both telemetry and supervisor ingress copy the
result's age into their retained `tailAge`; a long-held conversion cannot become
fresh on release. Supervisor first-age and maximum-gap history survive an old
frame followed by a fresh frame before batch consumption. Independent LF time
and watchdog supervision remain necessary.

The strict checker asserts immutable native recipe values and native-to-recipe
wire bindings while preserving every existing dynamic endpoint activity check.
Separate actual exported-player mutation controls check register loads, pin
timing and MISO capture using the unchanged wire oracle. New 33-bit capture
storage/bridges preserve their declared ABI names against structural compiler
deduplication with 33-bit CPU responses. These preservation annotations do not
change the handshake or datapath. The public SoC ABI is unchanged.

Physical requalification must cover the composed ownership/assembly/offset paths,
native reset and return timing, all CDC/bundled-data crossings, clock gating,
SCLK/CS/MISO setup/hold and board/ADC electrical limits. The old P&R artifacts
neither qualify this controller nor establish timing closure.

## Housekeeping scope and timing contract

Separate `FourPhaseHousekeeping` and `ClickHousekeeping` state loops own nominal
NOW, lower-bound board time, consumed-target publication, application deadlines,
sleep lease and wake mask, kick authorization, and low-power ADC cadence. State
credit returns only after the publication consumer accepts the reply. Click
uses native phase storage and feedback throughout. Shared code defines schemas
and reset literals only. Digital model timing still requires physical qualification.

The service boundary accumulates immutable elapsed observations and orders them
with accepted CPU/host updates. It retains modulo nominal/lower time, a nominal
overflow indication and saturated upper age. An accepted write freezes all older
queued time; later observations cannot overtake it. Deadline replacement clears
only the old event and evaluates the new deadline against post-elapsed time.
An old deadline also expires when a large batch crosses its unsigned distance,
including complete nominal wrap; deadline offsets remain below 2^31 ms. Lease
expiry and cadence recognize nominal overflow even when the accumulated low word
is zero. No complete LF source-counter wrap can be reconstructed after an outage.

Elapsed-scaler publication feeds measurement aging, GPIO observation history and
permanent supervision independently of housekeeping stalls. The board-time view
includes retained queued, ordered and in-flight lower time. Observation credit
still comes only from a fresh single-source-tick scaler publication; delayed
housekeeping replies do not manufacture observations. Only final housekeeping
state publication advances consumedGray. Queued work, native replies and bridge
return drainage retain the work clock, with the existing seven-edge ordinary
drain guard and synchronized demand unchanged.

CPU admission gets a bounded turn between background updates even when legacy
service-derived ticks occur every service edge. Deadline writes join housekeeping
and telemetry completion before issuing one CPU response. Published period state
and dispatched/ordered updates all contribute to host period-pending status.
Cadence coalesces missed acquisitions, retries the initial discarded frame and
applies the old pending interval before recording a coincident new update.

Native housekeeping and both crossings are POR-only. Application reset immediately
resets visible application projections (lease/deadline to zero and wake mask to
15), cancels the CPU completion,
and retains reset notification until native recovery publishes. Older replies
cannot restore application state. Time, pending elapsed history and acquisition
cadence persist. The LF counter, watchdog, two-flop Gray/ACK synchronization,
clock gate, source wake, input sampling and ingress/publication registers remain
explicit clocked boundaries. Native policy emits authorized watchdog kicks;
the POR heartbeat phase and application-reset pending bit coalesce delivery at
the LF crossing. Waiting for its ACK neither creates a housekeeping transaction
nor independently holds the gate. Legacy SPI idle-delay timing remains clocked.

Physical work must qualify the complete time/deadline/cadence transforms, native
state-credit return, reset recovery/removal, all bundled-data/phase crossings,
Gray skew, independent watchdog crossing and retained clock-gate timing. Existing
P&R results do not qualify this migration and do not establish timing closure.

## Native completion assembly scope (10a, digitally verified)

Each variant has an application-reset completion controller. A held plan selects
memory, Telemetry and Housekeeping completion inputs and retains the immediate
response/error. Selected inputs may arrive before the plan or in any order.
The final response joins all selected completions and holds under backpressure.
There is no arbitration, periodic clock or four-phase adapter in the Click owner.
Production SoCs connect this reply directly to the native Fabric. Clocked test
clients use an explicit output bridge because those clients have a clock domain.

Plan/completion capture crossings, response assembly, retirement observation and
CPU Fabric share application reset. Existing POR-owned effects remain outside
this domain. Source-specific pending flags suppress old completions; recovery
and SRAM drainage prevent old operations from being assigned to a new lifetime.
At the 10a checkpoint, the admission occupancy shadow clears only from synchronized retained retirement,
never a speculative idle observation. Reuse also requires crossing return and
native output drainage. Source-ready assertions reject lost completion pulses.

10a does not migrate admission, source-pending ownership, host arbitration,
observation reduction, peripheral publication or the SRAM word crossings.
Those are tracked in the remaining expanded items. Complete mux/selection paths,
phase feedback, composed control drainage and clock-crossing setup/hold require
physical qualification; current delays are digital experiment assumptions only.

## Native admission credit scope (10b1, digitally verified)

Each variant now owns one seeded native admission credit and an empty native
retirement slot. Services consumes a grant at the existing request commit edge;
native response acceptance returns it. Clocked CPU occupancy and retirement-edge
tracking are removed. HALT consumes the only credit without returning a reply;
application reset aborts old presentation/credit and creates exactly one new seed.
Accepted persistent effects retain their existing POR ownership and source-specific
cancellation flags. Those flags and publication crossings remain for 10b2.

BD captures retirement into the empty slot before allowing response storage to
return. A C-element barrier admits recycling only after both response request and
acknowledgment are low, then holds the offer through its complete return. This
decouples response retirement from the earlier grant's clocked return handshake.
Click uses an empty native Click buffer followed by a seeded phase-decoupled
buffer; input and output parity remain independent. Its Completion occupancy
compares against retained retirement acceptance. Click has no RTZ adapter.

The explicit native-to-clocked grant bridge, two-flop completion-drain observation,
and Click reset-start synchronization remain boundary logic. Idle never creates
credit. Parked boot/WAIT requests may authorize sleep only while a grant is
available; an unused grant alone creates no clock demand. The offered MMIO
request remains visible while waiting for credit, preserving events raised after
a clear request arrives but before its later dispatch. No software ABI changes.

The native buffers, BD return barrier, Click reset-start and phase-feedback paths,
and their crossing setup/hold assumptions require physical qualification. Current
digital delay bounds do not establish routed timing closure or minimum area/power.

## Native publication ownership scope (10b2c1, digitally verified)

Each design has its own native capacity-one publication owner, used independently
by Telemetry and Housekeeping. A retained reservation tag accompanies the grant
and drain offer. The validated MMIO Control reply remains held until every
required grant and decision ingress can commit with CPU acceptance. A deadline
write requires both sources; a parked WAIT reserves neither. Cancelled queued
grants settle without consuming admission or issuing effects. Source occupancy
does not feed its own admission predicate. Offered MMIO requests remain visible
to event history throughout these stalls.

Application reset revokes only CPU eligibility. Reservation, decision, publication
and drain phases remain POR-owned. Every committed decision issues a persistent
drain offer, even if application reset cancels a staged Telemetry command before
dispatch. Accepted ordered Housekeeping actions persist and publish. Actual
service publication always sends the old owner's receipt, including after reset;
only that same publication with eligible ownership and a clear reset fence may
produce CPU completion. `consumedGray` still advances solely on actual
Housekeeping publication.

Publication ACK comes from retained receipt capture independently of retirement.
Retirement requires grant return, decision, committed drain acknowledgment,
publication or revoked eligibility, and publication return. BD holds drain REQ
through reserve return and waits for all receipt/drain/decision returns before
reserve ACK falls. Its direct ACK-to-seen fork assumes a minimum 12 ns ACK pulse
(11 ns request delay plus a minimum 1 ns receipt cell), exceeding the 10 ns seen
cell maximum. Other BD source guards are 200 ns digital delays.

Click retains independent publication and drain targets when arming each slot;
false decisions skip both histories. Its custom arm, eligibility, publication,
drain and retirement registers use native event capture. Publication capture
also waits for a committed guarded decision. Balanced control trees and retained
phase feedback are covered by 241.200001 ns outward/decision guards, 10 ns data
paths and 100 ps setup/hold, pulse and capture-distribution assumptions. The
actual-pin campaign checks all six custom registers, including min/max gate
skew and observed reset overlap with publication/drain capture and ACK propagation.
These are digital bounds, not characterized or routed physical timing evidence.

Each source currently uses five POR-owned clocked-client crossings. The drain
consumer acknowledges only after staging/outstanding commands, reply return and
publication ingress are quiet. Queued observations and undispatched recovery
work do not block this proof; they retain their history. Two-flop owner-idle
observation and reset-debt release after two fresh safe observations remain
clocked. These convenience boundaries are temporary. Item 10b2c2 owns fresh
recovery attribution and native debt; later items remove staging, dispatch,
projection and direct-interconnect round trips. Full tests, strict export checks,
fresh review and retained failure evidence pass for this scope. No physical
qualification or minimum synchronous-state claim follows from this checkpoint.

## Accepted area batch before architecture correction

The latest follow-up advances the completed pilots into one A7b/A8b/A10
production batch: supported passive data allowances across both implementations,
the complete BD ordering-guard disposition with measured canonical-family sizing, Click ACK sizing
including pulse/rearm bounds, and removal of the pure-copy SRAM prepare stages.
Use the [uploaded skill](../../.agents/skills/async-circuit-design/SKILL.md),
[guard policy](../gf180-guard-sizing.md), [passive contract](../passive-allowance-contract.md)
and [fusion contract](../native-sram-prepare-fusion.md). Local digital/timing checks
and independent review permit reversible adoption before item 17; no claim of
full physical closure follows. Record measured production costs in the ledger,
including DLYD by purpose. The batch is locally accepted: 808 distinct Scala
cases, 1,198 Python controls, four strict exports and 1,630 guard cases pass with
independent review. Mapped logic is 2.229395 / 3.048424 mm² BD / Click; see
[the evidence and remaining obligations](../reviews/native-area-adoption.md).

## Source-build and mismatch-screen follow-up

The source dependency was pinned to `83d6468`, including `06b1216`'s passive
primitives and the generation-time structural audit; no local publication was
required.

The [statistical screen](../../analog/gf180-guard-variation/README.md) passes 192
samples with both ratio tails checked and timestep/seed controls. It supports
keeping the engineering derate. It does not qualify all stages for shortening
or change the architecture-first order.

- A fresh source tree, empty Ivy repository and fresh sbt Git staging directory
  build the exact library source and pass 31 core/schema/fabric tests
  (`build/source-clean-r1.log`). No locally published library is used.
- The full fast gate passes 292 Python and 166 Scala cases with the source-built
  JAR in its receipt (`build/followup-ci-r1`). After adding two statistical-screen
  property checks, all 294 Python tests pass on Windows and Linux
  (`build/followup-python-r2`, `build/followup-linux-python-r1`). Linux has only the
  documented Windows-path skip. The 31 clean-build tests overlap the 166; do not
  add them to claim a larger distinct test count.
- The final Monte Carlo screen is `build/guard-mismatch-r3`; the first convergence
  failure and the superseded one-tail r2 result remain available.
- Fresh independent review corrected two-tail statistical acceptance and the
  proposed ownership table's reset semantics. No review blocker remains.

This follow-up changes build resolution, characterization and planning only. It
adds no RTL, guard cells or clocks, and claims no new mapped/P&R measurement.
At this checkpoint the latest area was the generic-MCU batch in the ledger;
no island or register-pointer migration was counted as complete. Their current
boundary/ABI proposals are in the [architecture plan](../architecture-followups.md).
