BiscutLabs/RISCay-MCU/soc/src/main/resources/riscay/riscay_lf_osc.v

// SPDX-License-Identifier: Apache-2.0
// Digital view of riscay_lf_osc_gf180(vdd,vss,rst_n,clk); supplies are implicit.
// POR must remain asserted >=5 ms after supply becomes valid. No trim/enable.
(* blackbox *) module riscay_lf_osc(input wire rst_n, output wire clk);
endmodule
