BiscutLabs/RISCay-MCU/tools/test_check_export.py

from test_quiescing_receipt_probe import add_native_request_fixture, request_fixture_rtl
# SPDX-License-Identifier: Apache-2.0
"""Prove the generated-reset adapter accepts correct wiring and rejects a missed
watchdog reset. The fixture uses only ordinary Verilog, independently of Chisel.
"""
import copy
import json
from pathlib import Path
import subprocess
import tempfile
import unittest
from test_service_reply_receipt import add_native_reply_fixture
from check_export import generated_reset_probe, vector_coverage_probe, probe_timeout, sleep_clock_background, register_file_background, sram_background, service_background


class ResetProbeTest(unittest.TestCase):
    def test_service_background_exercises_joint_states_and_rejects_broken_aliases(self):
        for top in ("FourPhaseSoc", "ClickSoc"):
            root = {"gate_first": 32, "gate_second": 32}
            if top == "ClickSoc": root["controlStart_stages"] = 2
            elapsed = {"returned_stages_0": 1, "returned_stages_1": 1, "active": 1, "consumed": 32}
            response = {"q": 33}
            inventories = {top: root, top+".ca_child_elapsed_scaler": elapsed}
            children = [{"id": "elapsed_scaler", "contract": {
                "module": "ElapsedTicks", "rtl_path": top+".ca_child_elapsed_scaler"}}]
            payload = top+".ca_child_core.ca_child_address.ca_primitive_payload.q"
            if top == "FourPhaseSoc":
                inventories[top+".ca_child_completion.ca_child_reply.ca_primitive_payload"] = response
                children.append({"id": "core", "contract": {"children": [{"id": "address", "contract": {
                    "primitives": [{"id": "payload", "rtl_path": payload[:-2],
                        "ports": [{"name": "q", "width": 70, "direction": "output"}]}]}}]}})
                children.append({"id": "completion", "contract": {"children": [{"id": "reply", "contract": {
                    "primitives": [{"id": "payload", "rtl_path": top+".ca_child_completion.ca_child_reply.ca_primitive_payload",
                                    "parameters": {"WIDTH": "33"}}]}}]}})
            manifest = {"top": top, "design": {"children": children}}
            scopes = {path: {"registers": regs} for path,regs in inventories.items()}
            def declarations(regs):
                return "\n".join(f"reg [{width-1}:0] {name};" for name,width in regs.items())
            rtl = "module Elapsed;\n"+declarations(elapsed)+"\nendmodule\n"
            rtl += "module Response;\n"+declarations(response)+"\nendmodule\nmodule Reply; Response ca_primitive_payload(); endmodule\nmodule Completion; Reply ca_child_reply(); endmodule\n"
            rtl += """module Payload; reg [69:0] q; endmodule
module Address; Payload ca_primitive_payload(); endmodule
module Core; Address ca_child_address(); endmodule
"""
            rtl += f"module {top}; reg reset;\n"+declarations(root)+"\nElapsed ca_child_elapsed_scaler();\n"
            rtl += "wire elapsed_valid = !ca_child_elapsed_scaler.active && ca_child_elapsed_scaler.returned_stages_1 && gate_second != ca_child_elapsed_scaler.consumed;\n"
            if top == "ClickSoc":
                width = 2
                rtl += "wire [1:0] expected = {&controlStart_stages, elapsed_valid};\n"
            else:
                width = 34
                rtl += """Core ca_child_core(); Completion ca_child_completion();
wire selected = ca_child_core.ca_child_address.ca_primitive_payload.q[69:68] == 1 &&
  ca_child_core.ca_child_address.ca_primitive_payload.q[67:36] == 32'h20000000;
wire [32:0] reply = selected ? ca_child_completion.ca_child_reply.ca_primitive_payload.q : 33'b0;
wire [33:0] expected = {elapsed_valid, reply};
"""
            rtl += f"wire [{width-1}:0] observed = expected;\nendmodule\n"
            header = f"force {top}.reset = 1'b0;\n" + "".join(
                f"force {path}.{name} = {bits}'h0;\n" for path,regs in inventories.items() for name,bits in regs.items())
            if top == "FourPhaseSoc": header += f"force {payload} = 70'h0;\n"
            header += "#1;\n"
            source = f"""module ContractProbe; timeunit 1ns; timeprecision 1ps;
reg [{width-1}:0] ones_0=0, zeros_0=0;
task check; begin
if ({top}.observed !== {top}.expected) $fatal(1,"BINDING_MISMATCH");
ones_0 = ones_0 | {top}.observed; zeros_0 = zeros_0 | ~{top}.observed;
end endtask
initial begin
force {top}.reset = 1'b1; #1;
{header}check;
if (ones_0 !== {width}'h{(1<<width)-1:x} || zeros_0 !== {width}'h{(1<<width)-1:x}) $fatal(1,"INACTIVE_ENDPOINT:observed");
$display("CONTRACT_PROBES_PASS:1"); $finish; end endmodule
"""
            extended, count = service_background(source,manifest,scopes,1)
            self.assertGreater(count,1)
            self.assertTrue(extended.startswith(source[:source.index('if (ones_0 !==')]))
            self.assertIn(f'if ({top}.observed !== {top}.expected)',extended)
            import re
            allowed = {f"{path}.{name}" for path,regs in inventories.items() for name in regs} | {top+".reset",payload}
            self.assertLessEqual(set(re.findall(r"force (\S+) =",extended)),allowed)
            with tempfile.TemporaryDirectory(prefix="riscay-service-probe-") as folder:
                path = Path(folder)
                for stimulus,model,diagnostic in ((source,rtl,"INACTIVE_ENDPOINT"),(extended,rtl,"CONTRACT_PROBES_PASS"),
                        (extended,rtl.replace("observed = expected;","observed = expected ^ 1'b1;"),"BINDING_MISMATCH")):
                    (path/"test.sv").write_text(model+stimulus)
                    built = subprocess.run(["iverilog","-g2012","-s",top,"-s","ContractProbe","-o","sim.vvp","test.sv"],
                        cwd=path,capture_output=True,text=True,timeout=30)
                    self.assertEqual(built.returncode,0,built.stderr)
                    result = subprocess.run(["vvp","sim.vvp"],cwd=path,capture_output=True,text=True,timeout=30)
                    self.assertEqual(result.returncode == 0,diagnostic == "CONTRACT_PROBES_PASS",result.stdout)
                    self.assertIn(diagnostic,result.stdout)
            for bits in (None,31):
                bad=copy.deepcopy(scopes)
                if bits is None: del bad[top]["registers"]["gate_second"]
                else: bad[top]["registers"]["gate_second"]=bits
                with self.assertRaisesRegex(ValueError,"SERVICE_PROBE_DRIVER_MISMATCH"):
                    service_background(source,manifest,bad,1)
            with self.assertRaisesRegex(ValueError,"SERVICE_PROBE_DRIVER_MISMATCH"):
                service_background(source.replace(f"force {top}.gate_second = 32'h0;\n",""),manifest,scopes,1)
            if top == "FourPhaseSoc":
                bad=copy.deepcopy(manifest)
                bad["design"]["children"][1]["contract"]["children"][0]["contract"]["primitives"][0]["ports"][0]["width"]=69
                with self.assertRaisesRegex(ValueError,"SERVICE_PROBE_DRIVER_MISMATCH"):
                    service_background(source,bad,scopes,1)

    def test_sram_background_adds_joint_idle_and_all_tags_without_masking_mapping(self):
        for top in ("FourPhaseSoc", "ClickSoc"):
            root = {"gate_enabled": 1, "fabric_controlOutstanding": 1}
            for bank in ("program", "ram"):
                root.update({f"fabric_{bank}_state": 2, f"fabric_{bank}_tag": 2, f"fabric_{bank}_result": 8})
            sync = {f"{group}_{stage}": 1 for group in ("returned_stages", "bytesReturned_stages",
                "bytesReturned_stages_1", "bytesReturned_stages_2", "bytesReturned_stages_3") for stage in (0, 1)}
            sync["active"] = 1
            reply = {"state": 2}
            request = {"state": 2}
            inventories = {top: root, top+".ca_child_control_reply_bridge": reply,
                           top+".ca_child_request_bridge": request,
                           top+".ca_child_program_grant_bridge": dict(state=2,data=1)}
            for bank in ("program", "ram"):
                inventories[top+f".ca_child_{bank}_access"] = dict(sync)
                inventories[top+f".ca_child_{bank}_access"].update({f"ownerReturned_stages_{i}":1 for i in (0,1)})
            scopes = {path: {"registers": regs} for path, regs in inventories.items()}
            manifest = {"top": top, "design": {"children": [{"id": bank+"_access", "contract": {
                "module": "ProgramAccess" if bank=="program" else "RamAccess", "rtl_path": top+f".ca_child_{bank}_access"}} for bank in ("program", "ram")]}}
            owner=top+'.ca_child_program_return';payload=owner+'.ca_primitive_payload'
            q=dict(name='q',width=32,direction='output');parameters=dict(WIDTH='32',DELAY_FS='1000000',RESET_VALUE='0')
            scopes[payload]=dict(model='ChiselAsyncEventRegister_v1',parameters=parameters,ports=dict(q=q))
            inventories[payload]=dict(q=32)
            manifest['design']['children'].append(dict(id='program_return',contract=dict(
                module=('Click' if top=='ClickSoc' else 'FourPhase')+'ProgramReturn',rtl_path=owner,primitives=[
                    dict(id='payload',rtl_path=payload,model='ChiselAsyncEventRegister_v1',parameters=parameters,
                         ports=[q],reset='reset',reset_domain='root')])) )
            def declarations(regs):
                return "\n".join(f"reg [{width-1}:0] {name};" for name,width in regs.items())
            add_native_reply_fixture(manifest, scopes, inventories, "control")
            add_native_request_fixture(manifest, scopes, inventories)
            rtl = "module Payload; reg [31:0] q; endmodule\nmodule Return; Payload ca_primitive_payload(); endmodule\n"
            rtl += "module Access;\n"+declarations(inventories[top+".ca_child_program_access"])+"\nwire idle = !active && " + " && ".join(
                name for name in inventories[top+".ca_child_program_access"] if name.endswith("_1")) + "; endmodule\n"
            rtl += "module RamNativeAccess;\n"+declarations(inventories[top+".ca_child_ram_access"])+"\nwire idle = !active && "+" && ".join(n for n in inventories[top+".ca_child_ram_access"] if n.endswith("_1"))+"; endmodule\n"
            rtl += "module ControlPayload; reg [314:0] q; endmodule\nmodule Update; ControlPayload ca_primitive_payload(); endmodule\nmodule Control; Update ca_child_update(); endmodule\n"
            rtl += "module Reply;\n"+declarations(reply)+"\nendmodule\n"
            rtl += request_fixture_rtl()
            rtl += "module Grant; reg [1:0] state; reg data; endmodule\n"
            rtl += f"module {top}; reg reset;\n"+declarations(root)+"""
Access ca_child_program_access(); RamNativeAccess ca_child_ram_access(); Return ca_child_program_return();
Reply ca_child_control_reply_bridge(); Control ca_child_control(); NativeCore ca_child_core();
Request ca_child_request_bridge(ca_child_core.ca_child_address.ca_primitive_payload.q);
Grant ca_child_program_grant_bridge();
wire program_valid = ca_child_program_access.idle && gate_enabled && fabric_controlOutstanding &&
    ca_child_control_reply_bridge.state == 2 && ca_child_control.ca_child_update.ca_primitive_payload.q[67] &&
    ca_child_program_grant_bridge.state == 2 && ca_child_program_grant_bridge.data;
wire ram_valid = ca_child_ram_access.idle && gate_enabled && ca_child_request_bridge.state == 2 &&
    ca_child_request_bridge.data_operation == 2 && ca_child_request_bridge.data_address == 32'h20000000;
wire [7:0] lanes = { (4'b1 << fabric_program_tag) & {4{fabric_program_state == 3}},
                     (4'b1 << fabric_ram_tag) & {4{fabric_ram_state == 3}} };
wire program_published = ca_child_program_return.ca_primitive_payload.q[0];
wire [10:0] expected = {program_published, program_valid, ram_valid, lanes};
wire [10:0] observed = expected;
endmodule
"""
            header = f"force {top}.reset = 1'b0;\n" + "".join(
                f"force {path}.{name} = {width}'h0;\n" for path,regs in inventories.items() for name,width in regs.items()) + "#1;\n"
            source = f"""module ContractProbe; timeunit 1ns; timeprecision 1ps;
reg [10:0] ones_0=0, zeros_0=0;
task check; begin
if ({top}.observed !== {top}.expected) $fatal(1,"BINDING_MISMATCH");
ones_0 = ones_0 | {top}.observed; zeros_0 = zeros_0 | ~{top}.observed;
end endtask
initial begin
force {top}.reset = 1'b1; #1;
{header}check;
if (ones_0 !== 11'h7ff || zeros_0 !== 11'h7ff) $fatal(1,"INACTIVE_ENDPOINT:observed");
$display("CONTRACT_PROBES_PASS:1"); $finish; end endmodule
"""
            extended, count = sram_background(source, manifest, scopes, 1, 2048)
            self.assertGreater(count, 1)
            self.assertIn('if (ones_0 !==', extended)
            self.assertIn(f'if ({top}.observed !== {top}.expected)', extended)
            allowed = {f"{path}.{name}" for path,regs in inventories.items() for name in regs} | {top+".reset"}
            import re
            self.assertLessEqual(set(re.findall(r"force (\S+) =", extended)), allowed)
            with tempfile.TemporaryDirectory(prefix="riscay-sram-probe-") as folder:
                path = Path(folder)
                for stimulus, model, diagnostic in ((source,rtl,"INACTIVE_ENDPOINT"),
                        (extended,rtl,"CONTRACT_PROBES_PASS"),
                        (extended.replace(f"force {top}.ca_child_program_grant_bridge.data = 1'h1;",
                                          f"force {top}.ca_child_program_grant_bridge.data = 1'h0;"),rtl,"INACTIVE_ENDPOINT"),
                        (extended.replace(f"force {top}.ca_child_program_grant_bridge.state = 2'h2;",
                                          f"force {top}.ca_child_program_grant_bridge.state = 2'h0;"),rtl,"INACTIVE_ENDPOINT"),
                        (extended.replace(f"force {top}.ca_child_program_access.ownerReturned_stages_1 = 1'h1;",
                                          f"force {top}.ca_child_program_access.ownerReturned_stages_1 = 1'h0;"),rtl,"INACTIVE_ENDPOINT"),
                        (extended,re.sub(r'(wire program_published = )[^;]+;',r"\g<1>1'b0;",rtl),"INACTIVE_ENDPOINT"),
                        (extended,rtl.replace("observed = expected;", "observed = expected ^ 11'b1;"),"BINDING_MISMATCH")):
                    (path/"test.sv").write_text(model+stimulus)
                    built = subprocess.run(["iverilog","-g2012","-s",top,"-s","ContractProbe","-o","sim.vvp","test.sv"],
                        cwd=path,capture_output=True,text=True,timeout=30)
                    self.assertEqual(built.returncode,0,built.stderr)
                    result = subprocess.run(["vvp","sim.vvp"],cwd=path,capture_output=True,text=True,timeout=30)
                    self.assertEqual(result.returncode == 0, diagnostic == "CONTRACT_PROBES_PASS",result.stdout)
                    self.assertIn(diagnostic,result.stdout)
            for width in (None,2):
                bad=copy.deepcopy(scopes)
                registers=bad[top+".ca_child_program_access"]["registers"]
                if width is None: del registers["returned_stages_1"]
                else: registers["returned_stages_1"]=width
                with self.assertRaisesRegex(ValueError,"SRAM_PROBE_DRIVER_MISMATCH"):
                    sram_background(source,manifest,bad,1,2048)
            for name,diagnostic in (("program_return","COMPLETION_NATIVE_RETURN_OWNER"),
                                    ("program_access","SRAM_PROBE_OWNER_MISMATCH"),
                                    ("ram_access","SRAM_PROBE_OWNER_MISMATCH")):
                bad=copy.deepcopy(manifest)
                bad["design"]["children"]=[c for c in bad["design"]["children"] if c["id"]!=name]
                with self.assertRaisesRegex(ValueError,diagnostic):
                    sram_background(source,bad,scopes,1,2048)
            for name in ("state","data"):
                bad=copy.deepcopy(scopes)
                del bad[top+".ca_child_program_grant_bridge"]["registers"][name]
                with self.assertRaisesRegex(ValueError,"SRAM_PROBE_DRIVER_MISMATCH"):
                    sram_background(source,manifest,bad,1,2048)

    def test_register_file_background_adds_activity_without_masking_bad_mapping(self):
        manifest = {"top": "RfTop", "design": {"module": "ArchitecturalRegisters", "primitives": [
            {"id": "x1", "rtl_path": "RfTop.data", "ports": [{"name": "q", "direction": "output", "width": 32}]}]}}
        stimulus = "initial begin\nforce RfTop.reset = 1'b1; #1;\n"
        checks = 0
        for control in (0, 1):
            for name, width in (("reset",1),("index",5),("data.q",32)):
                stimulus += f"force RfTop.{name} = {width}'h{control if width==1 else 0:x};\n"
            stimulus += "#1;\n"
            for name, width in (("reset",1),("index",5),("data.q",32)):
                for bit in range(width):
                    for value in (1<<bit,((1<<width)-1)^(1<<bit)):
                        stimulus += f"force RfTop.{name} = {width}'h{value:x};\n#1; check;\n"
                        checks += 1
                stimulus += f"force RfTop.{name} = {width}'h{control if width==1 else 0:x};\n#1;\n"
        prelude = '''module ContractProbe; timeunit 1ns; timeprecision 1ps;
reg [31:0] ones_0=0, zeros_0=0;
task check; integer i; begin
if(RfTop.observed !== RfTop.expected) $fatal(1,"BINDING_MISMATCH");
for(i=0;i<32;i=i+1) begin
if(RfTop.observed[i] === 1'b1) ones_0[i]=1;
if(RfTop.observed[i] === 1'b0) zeros_0[i]=1;
end
end endtask
'''
        coverage = 'if (ones_0 !== 32\'hffffffff || zeros_0 !== 32\'hffffffff) $fatal(1,"INACTIVE_ENDPOINT:RfTop.observed");\n'
        original = prelude + stimulus + coverage + f'$display("CONTRACT_PROBES_PASS:{checks}"); $finish; end endmodule'
        augmented, count = register_file_background(original, manifest, checks)
        self.assertEqual(count, checks*3//2)
        self.assertTrue(augmented.startswith(prelude + stimulus))
        self.assertIn(coverage, augmented)
        self.assertEqual(register_file_background(original,{"design":{}},checks),(original,checks))
        with self.assertRaisesRegex(ValueError,"PROBE_SHAPE_CHANGED"):
            register_file_background("",manifest,checks)
        bad = copy.deepcopy(manifest); bad["design"]["primitives"][0]["ports"][0]["width"]=31
        with self.assertRaisesRegex(ValueError,"DRIVER_MISMATCH"):
            register_file_background(original,bad,checks)
        for source, broken, diagnostic in ((original,False,"INACTIVE_ENDPOINT"),
                                           (augmented,False,f"CONTRACT_PROBES_PASS:{count}"),
                                           (augmented,True,"BINDING_MISMATCH")):
            with tempfile.TemporaryDirectory(prefix="riscay-register-probe-") as folder:
                path=Path(folder)
                rtl='''module Bank; reg [31:0] q=0; endmodule
module RfTop;
reg reset=0; reg [4:0] index=0; Bank data();
wire [31:0] expected=index==1 ? data.q : 0;
wire [31:0] observed=%s;
endmodule
''' % ("32'b0" if broken else "expected")
                (path/"test.sv").write_text(rtl+source)
                built=subprocess.run(["iverilog","-g2012","-s","RfTop","-s","ContractProbe","-o","sim.vvp","test.sv"],
                                     cwd=path,capture_output=True,text=True,timeout=30)
                self.assertEqual(built.returncode,0,built.stderr)
                result=subprocess.run(["vvp","sim.vvp"],cwd=path,capture_output=True,text=True,timeout=30)
                self.assertIn(diagnostic,result.stdout)
                self.assertEqual(result.returncode==0,"CONTRACT_PROBES_PASS" in diagnostic)

    def test_sleep_background_adds_coverage_and_keeps_mapping_failures(self):
        manifest = {"top": "SleepTop"}
        scopes = {"SleepTop": {"registers": {"gate_enabled": 1}}}
        checks = 0
        stimulus = "initial begin\nforce SleepTop.reset = 1'b1; #1;\n"
        drivers = ("reset", "gate_enabled", "request", "returned", "response")
        for control in (0, 1):
            stimulus += "".join(f"force SleepTop.{name} = 1'h{control};\n" for name in drivers) + "#1;\n"
            for name in drivers:
                for value in (1, 0):
                    stimulus += f"force SleepTop.{name} = 1'h{value};\n#1; check;\n"
                    checks += 1
                stimulus += f"force SleepTop.{name} = 1'h{control};\n#1;\n"
        prelude = '''module ContractProbe;
timeunit 1ns; timeprecision 1ps;
reg ones_0=0, zeros_0=0;
task check; begin
if(SleepTop.observed !== SleepTop.expected) $fatal(1,"BINDING_MISMATCH");
if(SleepTop.observed === 1'b1) ones_0=1;
if(SleepTop.observed === 1'b0) zeros_0=1;
end endtask
'''
        coverage = 'if (ones_0 !== 1\'h1 || zeros_0 !== 1\'h1) $fatal(1,"INACTIVE_ENDPOINT:SleepTop.observed");\n'
        original = prelude + stimulus + coverage + f'$display("CONTRACT_PROBES_PASS:{checks}"); $finish; end endmodule'
        augmented, count = sleep_clock_background(original, manifest, scopes, checks)
        self.assertEqual(count, 30)
        # Original stimulus and every assertion remain intact; only more cases
        # and the completion count are added.
        self.assertTrue(augmented.startswith(prelude + stimulus))
        self.assertIn(coverage, augmented)
        with self.assertRaisesRegex(ValueError, "REGISTER_MISMATCH"):
            sleep_clock_background(original, manifest, {}, checks)
        with self.assertRaisesRegex(ValueError, "SHAPE_CHANGED"):
            sleep_clock_background("", manifest, scopes, checks)
        for source, broken, diagnostic in ((original, False, "INACTIVE_ENDPOINT"),
                                           (augmented, False, "CONTRACT_PROBES_PASS:30"),
                                           (augmented, True, "BINDING_MISMATCH")):
            with tempfile.TemporaryDirectory(prefix="riscay-sleep-probe-") as folder:
                path = Path(folder)
                rtl = '''module SleepTop;
reg reset=0, gate_enabled=0, request=0, returned=0, response=0;
wire expected=gate_enabled & (request ^ returned) & ~response;
wire observed=%s;
endmodule
''' % ("1'b0" if broken else "expected")
                (path / "test.sv").write_text(rtl + source)
                built = subprocess.run(["iverilog", "-g2012", "-s", "SleepTop", "-s", "ContractProbe", "-o", "sim.vvp", "test.sv"],
                                       cwd=path, capture_output=True, text=True, timeout=30)
                self.assertEqual(built.returncode, 0, built.stderr)
                result = subprocess.run(["vvp", "sim.vvp"], cwd=path, capture_output=True, text=True, timeout=30)
                self.assertIn(diagnostic, result.stdout)
                self.assertEqual(result.returncode == 0, "CONTRACT_PROBES_PASS" in diagnostic)
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
