BiscutLabs/RISCay-MCU/(commit log)

2026-10-07 Establish reusable RISCay MCU cores and Groundlark design contracts
2026-10-07 Complete dual-protocol RISCay SoCs with internal memory and power supervision
2026-10-08 Complete clock/reset schematics and firmware memory sizing
    Add GF180 fast-clock and supply-monitor schematic candidates, a qualified reset hold, dual-SoC brownout coverage, and reproducible characterization records. Add compiled RV32E firmware sizing fixtures and preserve the selected flip-flop memory baseline.
    Record schematic and digital validation separately from the remaining layout, extracted verification, and physical estimates.
    [build_firmware.py, event_loop.c, riscay_reset_hold.sv, riscay_service_osc.v]
2026-10-08 Preserve power supervision on watchdog recovery and reduce MCU overhead
2026-10-09 Migrate SoC fabric to separate native BD and Click routing
    Split SoC implementations by protocol, retain clocked stateful endpoints, fix BD return sequencing and Click capture guards, and add native fabric and dual-implementation verification. Record the migration checklist, strict export evidence and remaining physical qualification.
    [check_export.py, test_async_fabric_export.py]
2026-10-10 Migrate SRAM word sequencing to native BD and Click controllers
    Retain word ownership, byte ordering and read assembly in separate native
    pipelines. Keep explicit POR-only crossings and synchronous byte macro
    boundaries, preserving watchdog effects, loader accounting and retained sleep.
    Add clockless and real-macro reset/stall tests, strict mapping source-state
    controls and updated contracts. Independent review fixes are covered by 169
    verification tests, two physical-policy tests and 74 Python controls. Both
    production strict exports pass with native protocol and reset checks retained.
    [check_export.py, test_async_fabric_export.py, test_check_export.py]
2026-10-10 Migrate I2C protocol state to independent native controllers
2026-10-10 Migrate SPI ADC state to native BD and Click controllers
2026-10-10 Migrate selected CPU completion assembly to native BD and Click
2026-10-12 Remove redundant clocked I2C frame copies
    Use separate BD and native Click payload-free receipts, with ACK tied to actual
    work-clock mailbox capture. Preserve native payload retention, reset/busy
    context, overflow behavior, wake demand and the public ABI.
    Qualify item 11a1 with 489 verification cases in an audited combined cohort,
    2 physical-policy cases, 329 Python tests, strict exports, actual RTL capture and
    fault controls, and independent review. Retain all failed attempts. Record the
    339-bit per-variant reduction and expand the remaining native mailbox/credit
    checklist; physical timing qualification remains open.
2026-10-12 Move admitted I2C frame payloads into native banks
    Implement separate four-phase and native Click payload/epoch stores with four
    physical banks and exactly two logical credits. Preserve original admission,
    dispatch-time reset context, overflow, loader priority and sleep behavior.
    Remove 516 periodically clocked RTL bits per variant; keep narrow descriptor,
    credit and dispatch state explicit for subsequent migration.
    Verified: 507 full regression cases plus two physical-policy cases; 68 final
    affected cases; 364 Python controls; both production and standalone strict
    exports; actual RTL capture, wake, mapping and fault controls. Fresh independent
    review has no unresolved findings. Physical ti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
2026-10-13 Contain application reset crossings before native recovery
    Close actual clocked receivers before destructive native reset; retain POR bridge history and payloads, coherent application projections and reservation roles. Preserve accepted effects and both native protocols.
    Verified 509 affected cases across 38 suites, four physical-emitter/core-policy tests, 402 Python tests and all four strict exports. Fresh independent review and actual RTL mutation controls pass. Physical reset timing, frame-copy completion and current cost refresh remain open.
2026-10-13 Add historical GF180 routing flow with input provenance guards
2026-10-13 Join native frame copy completion before host admission
    Preserve original-offer overflow and reset/busy history while BD and Click wait for bank completion. Join publisher acknowledgment natively and require BD copy-low rearm.
    Verify 262 distinct Scala cases, 457 Python tests, all four strict exports and exact-site mutation campaigns. Record matched area/activity, retained failure evidence and independent bounded digital approval; physical timing remains open.
2026-10-13 Keep frame-bank routing under native ownership
2026-10-13 Remove duplicate peripheral and SRAM receiver payload storage
    Capture retained native payloads at the existing consumer edge while preserving BD/Click control cadence and SRAM macro timing. Add native-state inventory, capture proofs and wiring fault controls; record matched cost, wake activity and complete regression evidence.
2026-10-14 Qualify I2C snapshot receipts on the actual consumer clock
2026-10-15 Shrink native CRC feedback to one result stage
2026-10-15 Retain only consumed native I2C observation fields
2026-10-15 Compact SPI playback without copying native recipes
2026-10-15 Store I2C receive bytes in a native addressed bank
    Keep separate BD and Click ownership and retain the public ABI, frame/reset semantics and independent phase returns. Remove 513 native payload bits per variant; matched whole-logic area falls 1.9160%/1.5153% with unchanged wake activity.
    Validation: 210 Scala tests, 570 Python checks, four strict exports, 129 actual wiring controls and 344 frame cases. Preserve prior failures and all measured physical timing violations; physical qualification remains open.
    Evidence SHA-256: 4985b91ea2b82fb30c887d913bb505f623fee5e942fad3b13d1a30209b37c210
    Independent review SHA-256: d147b30244b826ab10dfa842e62fb6ad058c79be3c5230fe06a867b45f8fdd4a
2026-10-15 WIP: checkpoint capacity-sized loader metadata for review
2026-10-15 Finish loader metadata validation and bound export probe allocation
2026-10-16 Reuse native stage timing checks across mapped instances
2026-10-17 Bind repaired stage and Join timing to preserved leaf pins
2026-10-17 Bound native capture trees and separate SRAM clock drivers
2026-10-17 Record repaired stage and Join corner sweeps
2026-10-17 Prove wire-dependent repair with bounded resizer progress
2026-10-17 physical: strengthen wide capture drivers within unchanged local budgets
2026-10-17 Borrow retained native frames at Control ingress
2026-10-17 Measure same-corner elapsed guard pilot and track batched area work
2026-10-17 Measure passive RAM-stage allowances in both native variants
2026-10-17 Add asynchronous circuit design skill and production area workflow
2026-10-18 Adopt passive data, measured guards and SRAM prepare fusion
    Use the source-pinned passive allowance across both native variants, adopt locally measured BD publication/elapsed and Click ACK recipes, and fuse the pure-copy SRAM prepare stores. Record matched area, complete audits, retained failures, independent review and remaining physical qualification limits.
2026-10-18 Pin library source and set BD architecture priorities
2026-10-18 Route BD on rectangular die and publish layout image
2026-10-18 Record BD routing on 1.94 by 2.53 mm die and update layout
2026-10-18 Keep event arbitration clocked and complete native register views
    Keep pending, arrival-cutoff masking and WAIT together in Services for BD and
    Click. Remove event transport from Telemetry and give Click its own retained
    native application/GPIO view. Qualify all clocked readers of the native bank.
    Add shared event-oracle regression, closed-pin and recovery coverage, and
    repaired-map BD reader timing. Record matched area, sinks, wake activity and
    independent review findings. Preserve routed timing as an open obligation.
2026-10-18 Split native sample ownership and derive telemetry age from timestamps
    Give the ADC its retained native sample bank in both implementations; keep CPU
    software publications and application/GPIO updates independently owned. Replace
    sample age accumulation and Telemetry observation traffic with retained timestamps.
    Preserve accepted publications across reset and qualify coherent host reads.
    Remove 240 Services work-clock sinks per variant and reduce Click maintenance
    from 21 to 18 work edges. Retain intentional clocked event/command arbitration.
    Record ranked sink inventories, matched area/activity and independent review fixes.
    Verification: 303 Python and 197 Scala CI tests, 42 focused tests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
2026-10-19 Complete routed BD stage timing diagnostics
2026-10-19 Isolate measured native receiver inputs for upstream wire repair
2026-10-19 Add verified external A/B boot slots and golden recovery
2026-10-19 Record repaired routing and direct keeper coupling results
2026-10-19 Narrow retained sample time with saturation and matched verification
2026-10-19 Read Housekeeping from retained native banks
    Remove Services state mirrors and obsolete elapsed lanes in both variants while retaining the receiving-edge wake acknowledgement and command arbitration. Qualify native bank readers, repair overloaded ordinary hierarchy outputs, and verify source/polarity timing composition. Record matched area, wake activity, full-capacity boot and remaining routed obligations.
2026-11-06 Complete independent clocked MCU with shared chip verification
    Implement synchronous fabric, loader, SRAM sequencing, peripherals and low-power reset coordination around the clocked RV32E core. Preserve the generic MCU ABI and reuse native chip test bodies and event oracles.
    Add ordinary clocked export and pinned GF180 mapping, CI coverage, and measured area/activity records. Independent review fixes and functional regressions pass; physical timing qualification remains open.
2026-11-07 Fuse BD ADC scaling with an exact finite-domain transform
2026-11-07 Trim consumed BD CPU payload and physical trace storage
2026-11-09 Protect composed memory-guard dependencies in CI and sizing
    The Source grant now reuses its reservation LongHold publication delay.
    That chain must cover eligibility capture as well as LongHold publication;
    a publication-only sizing pass must not silently shorten it. Record both
    consumer obligations and enforce their measured eight-cell minima in the
    mapper, proposer and fast CI, including inventories from older maps.
    Name released/completion keeper retention in the routed item-17 gate and
    separate keeper pulse repairs from the payload hold reserve. Make the
    retained work-clock bridge prerequisite explicit in the architecture plan.
    Correct RAM decision coverage and Services sink attribution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
2026-11-09 Adopt resetless BD frames and compact retained transport
    Pin the reviewed chisel-async resetless payload option at 856fc75 and use it
    only for the four POR-owned transient frame banks (1,348 bits). Keep native
    control, seeded tokens and architectural state resettable. Bind the distinct
    primitive to latq_1 and update generation consumers, RDC lifetime checks,
    whole-graph repair proofs, real latch apertures and activity accounting.
    Store only the accepted MMIO write fields (77 to 44 bits) and seven variable
    address bits in the Control sender. Preserve malformed-access validation,
    offset-52 index semantics, cancellation and full-return payload ownership.
    Extended tests exposed the existing ea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
2026-11-10 Establish desync Phase 0 tools and the repaired clocked reference
    Reproduce the pinned clocked export at 0.5318332992 mm2 and establish
    0.5915383488 mm2 after matched repair, placement and CTS. Preserve the
    complete logic graph and independently reach all 2980 clock pins; all five
    PVT electrical reports are clean. This is not routed or 20 MHz timing closure.
    Add one primitive registry, Liberty-based area/storage ratios, protection
    audit, monotonic budgets, same-corner STA requirements and a delay-policy
    loader that rejects absent/stale/unmeasured recipes. Loaded-chain evidence
    must match the chosen count, mix and netlist. No physical counts are invented:
    the GF180 mutex lacks LEF/Liberty/la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
2026-11-10 Add the desync MCU digital prototype
    Copy the clocked region without architectural state changes and integrate one
    pausible C-element/delay/mutex source at the existing fast-clock boundary.
    Keep work gating, independent LF timing, SRAM hookup, ABI and reset behavior.
    The user limited this batch to digital modeling: all physical generator recipes
    remain unavailable, and region-only maps cannot pass the whole-chip area gate.
    Mapped region ratio: 1.000x -> 1.000x (0.5318332992 mm2; generator excluded).
    Region storage: 2977 -> 2977 bits. Delay/controller/mutex area and the complete
    mapped/repaired ratios remain unmeasured; physical acceptance is not claimed.
    RTL diff versus clocked: +159/-27 Sc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
2026-11-10 Implement phase-aware desync graph and causal controller candidates
    Separate the 42 opposite-edge bits into the tenth bank so its S master can
    receive its own measured request delay. Bind work-gate qualifiers to the
    original previous/enabled registers and include macro and gate dependencies.
    The abstract graph is live and one-safe across 25,293 markings; stopping at
    power.m- drains all markings within 51 firings. It remains an incomplete
    screen, not physical controller correspondence or handshake-wire rest.
    Add single-registry GF180 schematic candidates and loaded characterization.
    Restore the original controller's Ri & !Ro causal condition after the
    simplified recipe stalled at 50 fF. The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
2026-11-10 Record the experimental desync Mutex layout and RC results
    The unchanged 46-transistor GF180 candidate now has a reproducible 28 x 35.28 um
    layout, independent foundry GDS DRC and two LVS checks, distributed RC, negative
    controls, and reviewed waveform checks in chisel-async 24c1216/3a712ec.
    The measured outline is 0.00098784 mm2, within the 0.001 mm2 allowance. Record
    462 passing five-corner samples and remaining LEF/Liberty, min/max RC,
    variation/noise and unresolved-reset qualification obligations. No binding
    is enabled and no maximum contention-resolution time is claimed.
    Whole-chip mapped/repaired ratio: unavailable -> unavailable. Reference
    architectural bits: 2,977 unchanged; calcula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
2026-11-10 Record routable Mutex views and the stop/wake reliability target
    Record the revised GF180 cell evidence from chisel-async aef1f09. Seven M5
    landing pads fix the real M4 pin-access failure without changing transistors,
    internal routes or the 0.00098784 mm2 outline. The views remain experimental:
    scenario conditions do not establish prior quiescence or bound contention.
    The user selected at most 1 FIT per MCU for stop/wake arbitration; this is an
    unmet target, not a result from finite simulations. Keep the registry disabled.
    Mapped/repaired whole-chip ratios: unavailable -> unavailable.
    Architectural state: 2,977-bit reference unchanged; calculated storage-area
    floor: 1.230263x -> 1.230263x.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
2026-11-11 Connect generated desync bank controllers for timing preparation
    Connect the approved one-sided closure/same-phase qualification, CPU rearm,
    and persistent stop/Mutex to all ten generated banks. Preserve the request
    keeper dependency on actual enable N. Define nine POR sample masters; add
    no architectural bits or payload copies. Production delay/recipe acceptance
    stays disabled. Review fixes separate CPU A capture from N roots and preserve
    literal recipe nets. Exact protected-leaf and retired-clock audits pass.
    Whole-chip mapped ratio: unavailable -> unavailable (10 delay apertures).
    Measured preparation: 0.5849922624 -> 0.5958650880 mm2, or
    1.099954x -> 1.120398x pinned clocked reference.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
2026-11-11 Measure desync distribution and stop the ten-line area trial at budget
    Factor C-element feedback and strengthen the S request driver after loaded
    failures. Add graph-preserving parent/reset drivers and bounded enable trees,
    conditional native STA, scoped bank-path samples and an ideal-cycle fold proof.
    Independently enumerate storage sinks; preserve blackbox pins through repair.
    Review fixes catch missing trees, incomplete waveform windows and invalid
    Q-to-D extrema claims. Composed closing/hold/transparent-slew timing stays open.
    Connected mapped ratio: 1.120398 -> 1.127910 (.595865088 -> .599860352 mm2).
    Cell-exact ten-line area experiment: .618651264 mm2 / 1.163243x, over 1.15x.
    Delay ar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
2026-11-11 Set approved desync budget and measure pure data paths
    Apply the user's mapped-area ceiling increase from 1.15x to 1.20x, anchored
    to parent 291d731. Other budgets and future tightening remain protected.
    The unchanged ten-line trial fits mapped area; control share still exceeds 5%.
    Add a loaded cut-Q/D analysis view so clock arrival and latch aperture cannot
    hide the fastest data path. Rank paths with zero required time to avoid float
    cancellation. Independently audit registry/Liberty removals, every frontier,
    all restored loads, unchanged ordinary logic and both min/max reachability.
    These are fixed-slew data samples, not composed or continuous-slew bounds.
    Mapped ratio: 1.163243 -> 1.163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
2026-11-11 Measure direct native latch hold from a common frontier
    Compose receiver closure and sender reopening on the repaired graph, preserving
    all pin loads and independently enumerating paired storage. This replaces an
    independent-extrema I2C alarm with a reproducible conditional STA check, without
    adding cells. Review fixes reject omitted sinks and ignored SDF annotations.
    Physical hold still needs a full-feedback minimum-transition bound; keeper
    reinforcement, pulses, setup, reset and routed RC are not qualified here.
    Mapped trial ratio: 1.163243x -> 1.163243x (0.6186512640 mm2).
    Storage: 2977 architectural bits and 5283 FF/latch + 198 keeper bits, unchanged.
    Delay/controller/mutex: 0.033746809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
2026-11-11 Check full-feedback I2C latch retention
    The fixed-keeper STA model is not a physical minimum reopening bound.
    Characterize the actual sender controller, repaired ACK/enable trees and
    all paired latches with feedback intact. Explicit source-D timing frontiers
    restore their original live pin loads; every source must reuse while every
    receiver retains. Reject early/recrossing edges and an ACK disconnected
    from the common receiver-A frontier. Document the remaining modeled-load,
    waveform, mismatch, pulse/reset and routed qualification limits.
    Mapped ratio 1.163242815x -> 1.163242815x (0.618651264 mm2 provisional trial).
    Storage unchanged: 2,977 architectural bits, 5,283 FF/latch + 198 keepers;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
2026-11-11 Check retained work-gate return ordering
    Measure the actual nine work-enable gates with qualifier-owner feedback,
    ACK joins, closed-input paths, retained qualifier latch and distribution
    trees intact. Keep CPU master.A capture distinct from normal enable N.
    Account for omitted pin loads and actual reset markings; reject unknown
    storage clocks, cyclic return cones and duplicate targets that could hide
    a gate. The check covers sampled closing/order, not opening/setup, pulse,
    reset, mismatch or routed qualification. No circuit or delay count changes.
    Storage unchanged: 2,977 architectural bits, 5,283 FF/latch + 198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
2026-11-11 Measure retained work-gate opening at its setup aperture
    Extend the existing feedback-preserving gate tool to check opening on the
    actual target paths. Inventory the exact enabled/previous latch chains;
    admit data using the actual Liberty D/E setup axes and measured slews.
    Sweep data and frontier slew independently and distinguish invalid setup
    premises from qualifier-ordering failures. Independent review found a gap
    in prior CPU pulse observation; close it and reject faults in both polarities.
    All 360 conditional opening cases pass. The minimum sampled input-order
    separation is 0.626009 ns, versus 0.626309 ns at the finer timestep. Upstream
    arrival/retention, continuous slew, mismatch, rou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
2026-11-12 Apply the approved desync prototype area ceilings
    Record the user's explicit 1.17x mapped-area and 5.5% control/delay-share
    limits, replacing the preceding 1.20x and 5% limits. Keep repaired+trees
    1.20x, architectural bits exactly 1.00x and storage area 1.25x unchanged.
    This is permission to continue the prototype, not timing or production
    qualification.
    Bind the approval to b2cac0f and the previous values. Approval lookup now
    covers a control-share increase even while mapped area tightens. Preserve
    the separate historical mapped-only approval and test both before/after
    commit, unauthorized changes and attempts to replay after tightening.
    Mapped ratio: 1.163243x -> 1.163243x; 0.618651264 m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
2026-11-12 Exercise the generated desync MCU before further timing work
    Run original whole-SoC pin benches on the actual generated storage and logic,
    with registered behavioral control and trial-STA delay ranges. Audit the control
    graph before substitution; check real N-event ordering, register transfers,
    reset tokens and closed-phase gating. Require flow evidence for the complete
    live inventory and report unexercised/undefined state. Keep reference CI separate
    from the explicit generated gate. Bound simulator runs and clean up owned workers
    on timeout or cancellation.
    Pause local SPICE. Archive the long ledger and prior contract detail; retain one
    short ledger row per commit. Independent review found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
