BiscutLabs/RISCay-MCU/docs/images/bd-layout-1940x2530.png

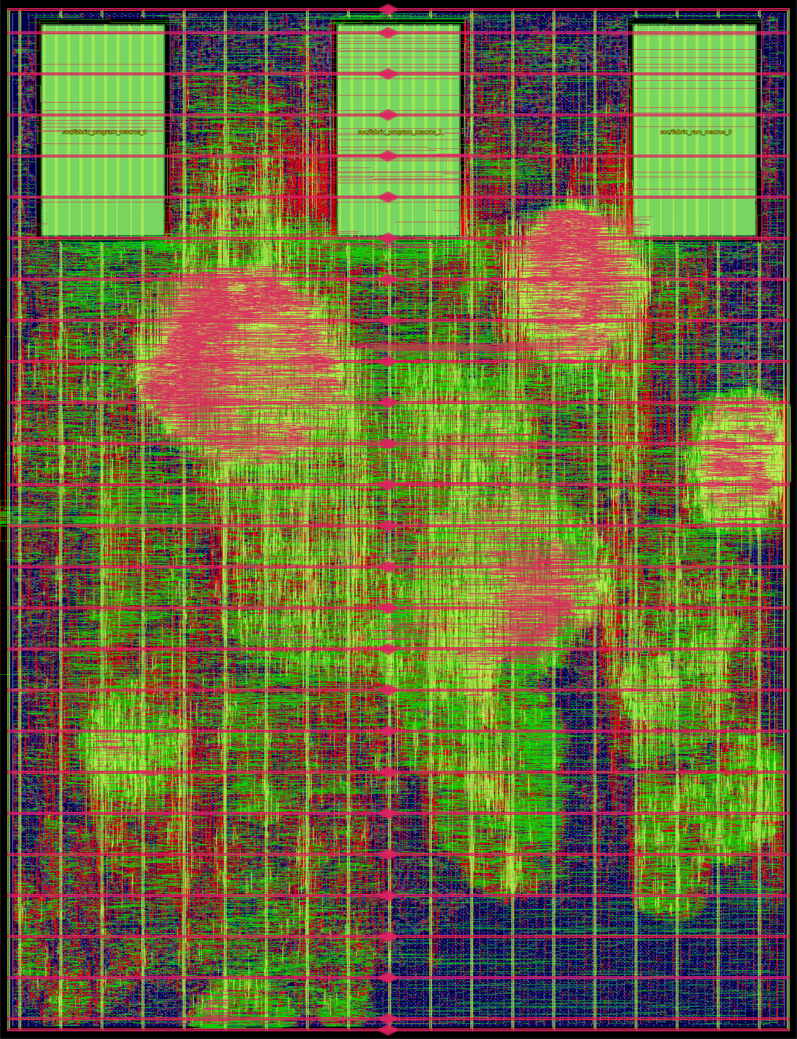
docs/images/bd-layout-1940x2530.png
