BiscutLabs/RISCay-MCU/docs/images/bd-layout.png

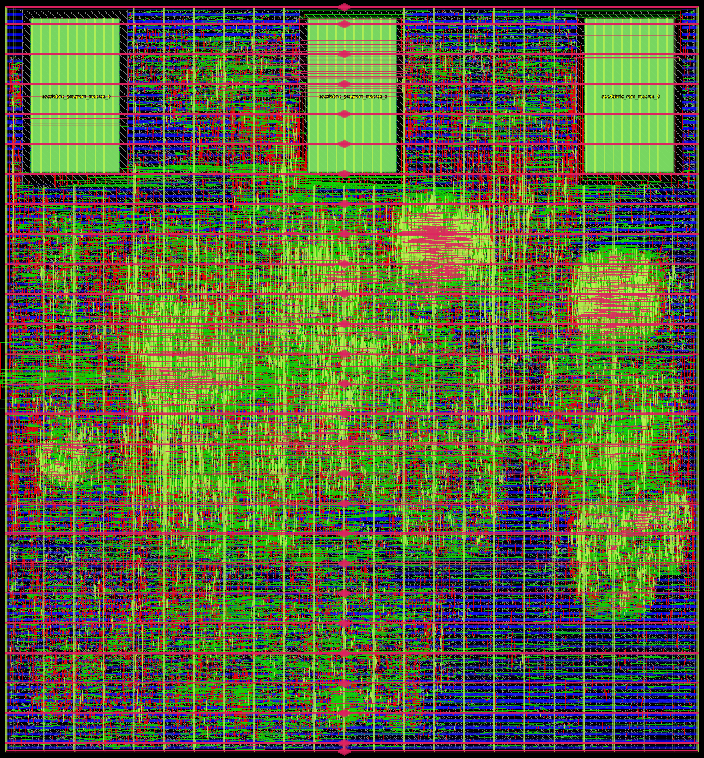
[picture p1: docs/images/bd-layout.png]
docs/images/bd-layout.png
